joelguittet/chip-hardware/ALPHA-CHIP[v0_21]/README.md

# Source Files
C.H.I.P. is designed using OrCAD! A free "lite" viewer is available at <a href="http://www.orcad.com/">www.orcad.com</a>

# CHIP-Hardware
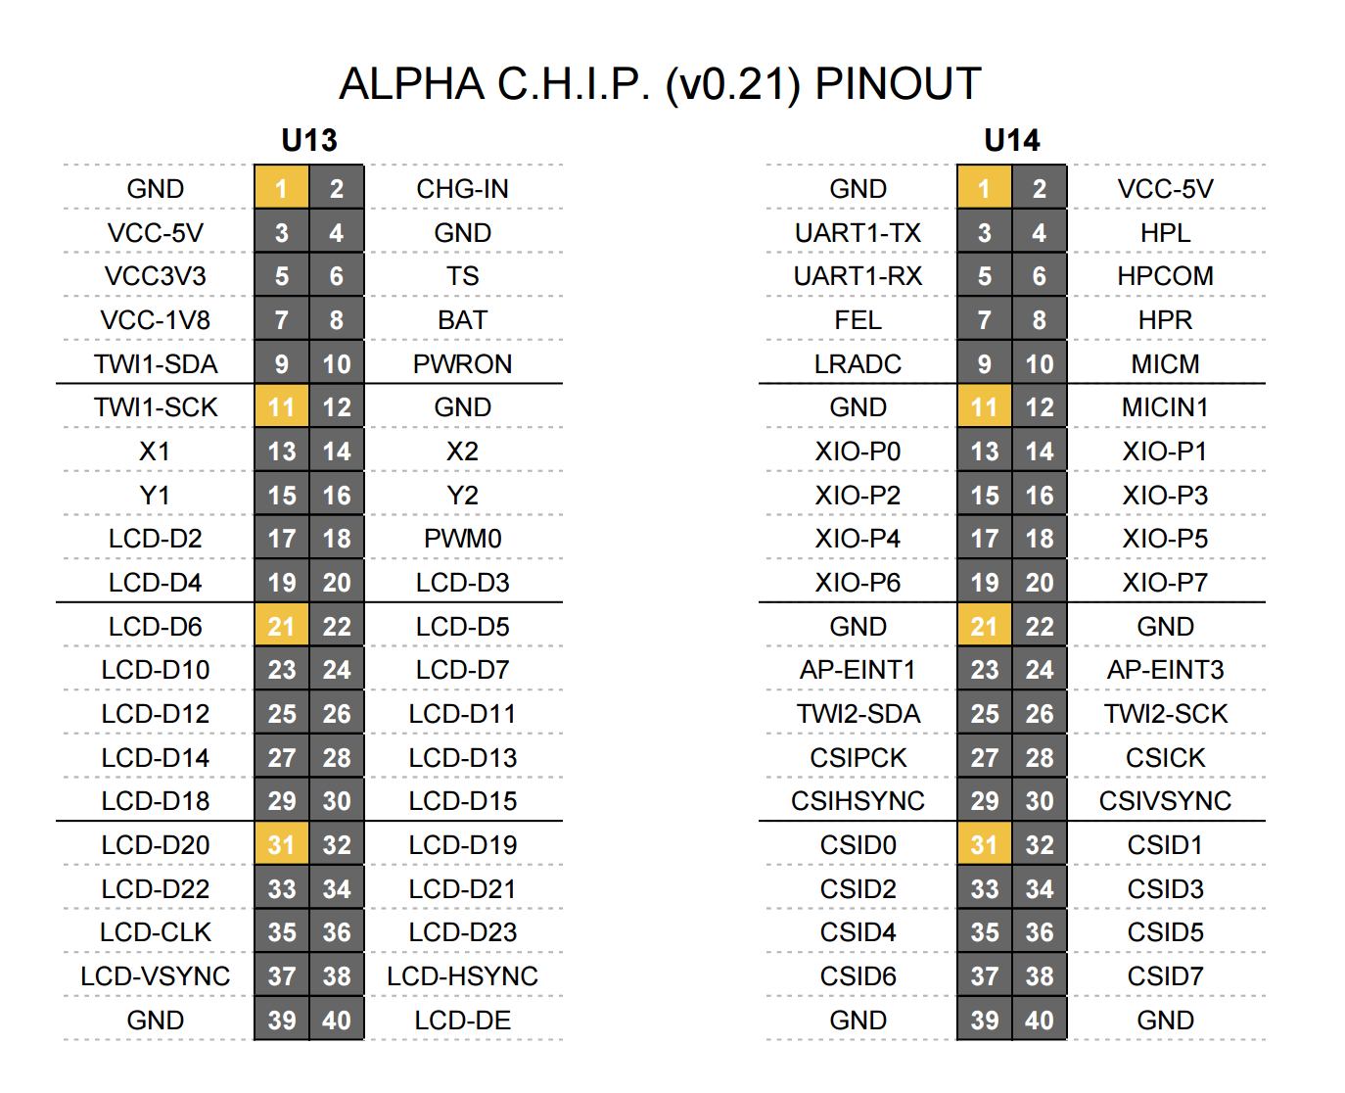
[picture p2: ALPHA-CHIP[v0_21]/ALPHA CHIP v0_21 PINOUT.png]
CHIP


#Composite Video and Audio Connector
A 3.5mm (1/8") "mini" TRRS to RCA composite video output cable.
Composite Cable

#License
<br />This work is licensed under a <a rel="license" href="http://creativecommons.org/licenses/by-sa/3.0/us/">Creative Commons Attribution-ShareAlike 3.0 United States License</a>.
