joelguittet/chip-hardware/CHIP[v1_0]/CHIP_v1_0_PINOUT.pdf

GND | 1 | 2 | CHG-IN | | GND | 1 | 2 | VCC-5V
VCC-5V | 3 | 4 | GND | | UART1-TX | 3 | 4 | HPL
VCC-3V3 | 5 | 6 | TS | | UART1-RX | 5 | 6 | HPCOM
VCC-1V8 | 7 | 8 | BAT | | FEL | 7 | 8 | HPR
TWI1-SDA | 9 | 10 | PWRON | was LRADC> | VCC-3V3 | 9 | 10 | MICM
TWI1-SCK | 11 | 12 | GND | was GND> | LRADC | 11 | 12 | MICIN1
X1 | 13 | 14 | X2 | | XIO-P0 | 13 | 14 | XIO-P1
Y1 | 15 | 16 | Y2 | | XIO-P2 | 15 | 16 | XIO-P3
LCD-D2 | 17 | 18 | PWM0 | | XIO-P4 | 17 | 18 | XIO-P5
LCD-D4 | 19 | 20 | LCD-D3 | | XIO-P6 | 19 | 20 | XIO-P7
LCD-D6 | 21 | 22 | LCD-D5 | | GND | 21 | 22 | GND
LCD-D10 | 23 | 24 | LCD-D7 | | AP-EINT1 | 23 | 24 | AP-EINT3
LCD-D12 | 25 | 26 | LCD-D11 | | TWI2-SDA | 25 | 26 | TWI2-SCK
LCD-D14 | 27 | 28 | LCD-D13 | | CSIPCK | 27 | 28 | CSICK
LCD-D18 | 29 | 30 | LCD-D15 | | CSIHSYNC | 29 | 30 | CSIVSYNC
LCD-D20 | 31 | 32 | LCD-D19 | | CSID0 | 31 | 32 | CSID1
LCD-D22 | 33 | 34 | LCD-D21 | | CSID2 | 33 | 34 | CSID3
LCD-CLK | 35 | 36 | LCD-D23 | | CSID4 | 35 | 36 | CSID5
LCD-VSYNC | 37 | 38 | LCD-HSYNC | | CSID6 | 37 | 38 | CSID7
GND | 39 | 40 | LCD-DE | | GND | 39 | 40 | GND

Use square pad

## C.H.I.P. (v1.0) PINOUT

U13 | U14

New Pin Location vs. v0.21
