joelguittet/chip-hardware/ALPHA-CHIP[v0_21]/CompositeCable-TRStoRCA-PINOUT.png

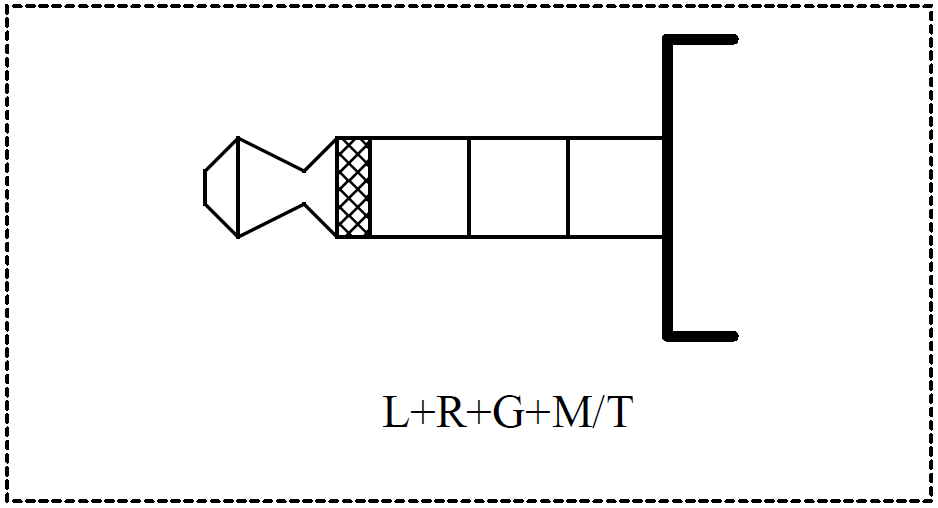
ALPHA-CHIP[v0_21]/CompositeCable-TRStoRCA-PINOUT.png
