joelguittet/chip-hardware/CHIP-PRO/CHIP_PRO-Schematics.pdf

# Schematics Index£º

# P01: REVISION HISTORY

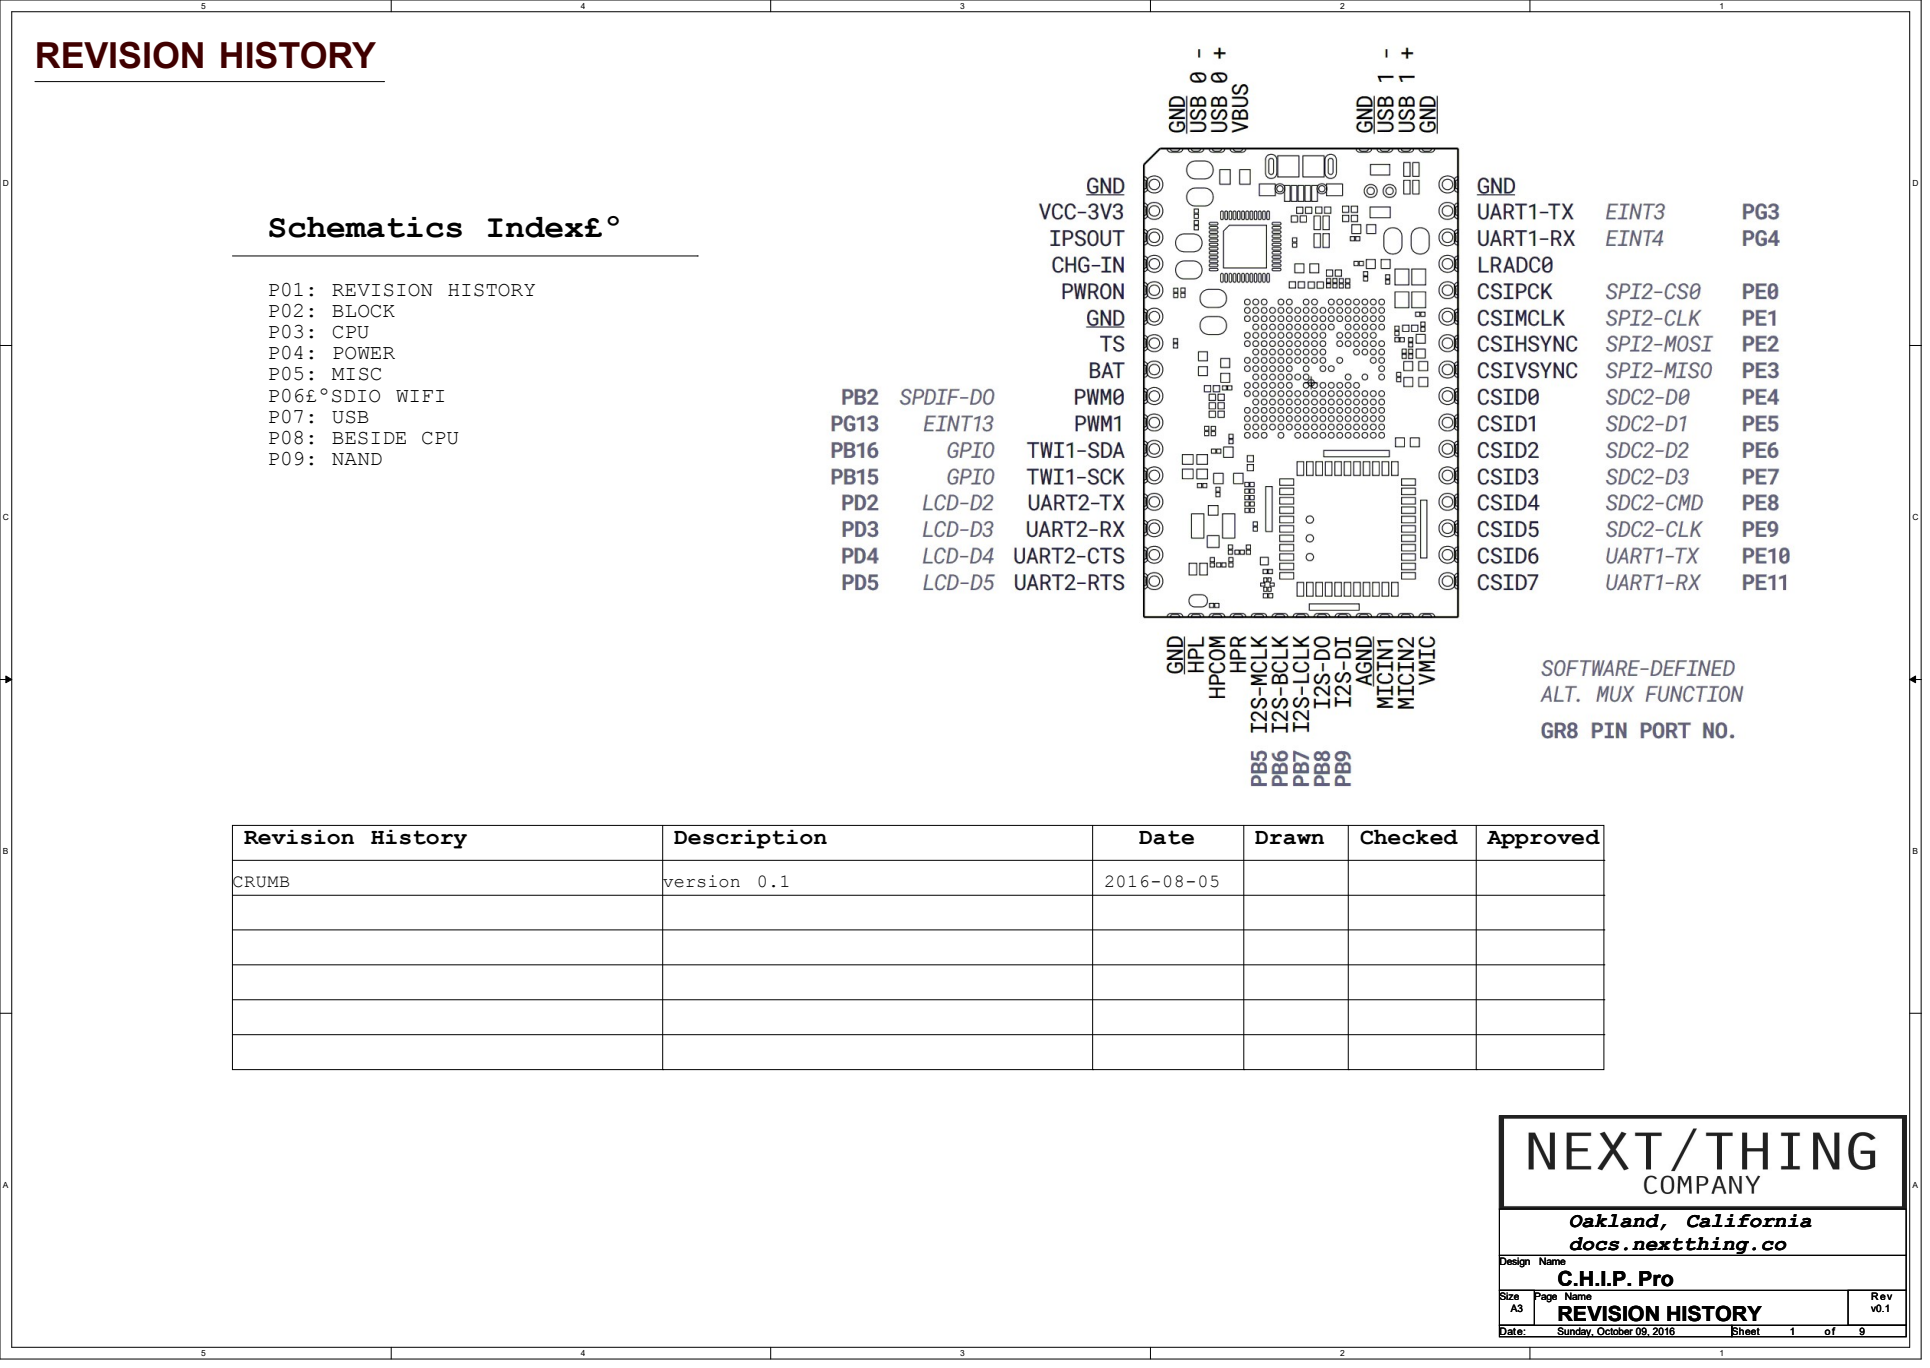
[picture p9: page 1]
Revision History; Description; Date; Drawn; Checked; Approved; P02: BLOCK P03: CPU P04: POWER P05: MISC P06£ºSDIO WIFI P07: USB P08: BESIDE CPU P09: NAND; REVISION HISTORY; CRUMB; version 0.1; Design Name; Size; Page Name; Rev; Date:; Sheet; v0.1 C.H.I.P. Pro A3; Sunday, October 09, 2016

Oakland, California
docs.nextthing.co

# BATT

# DCIN

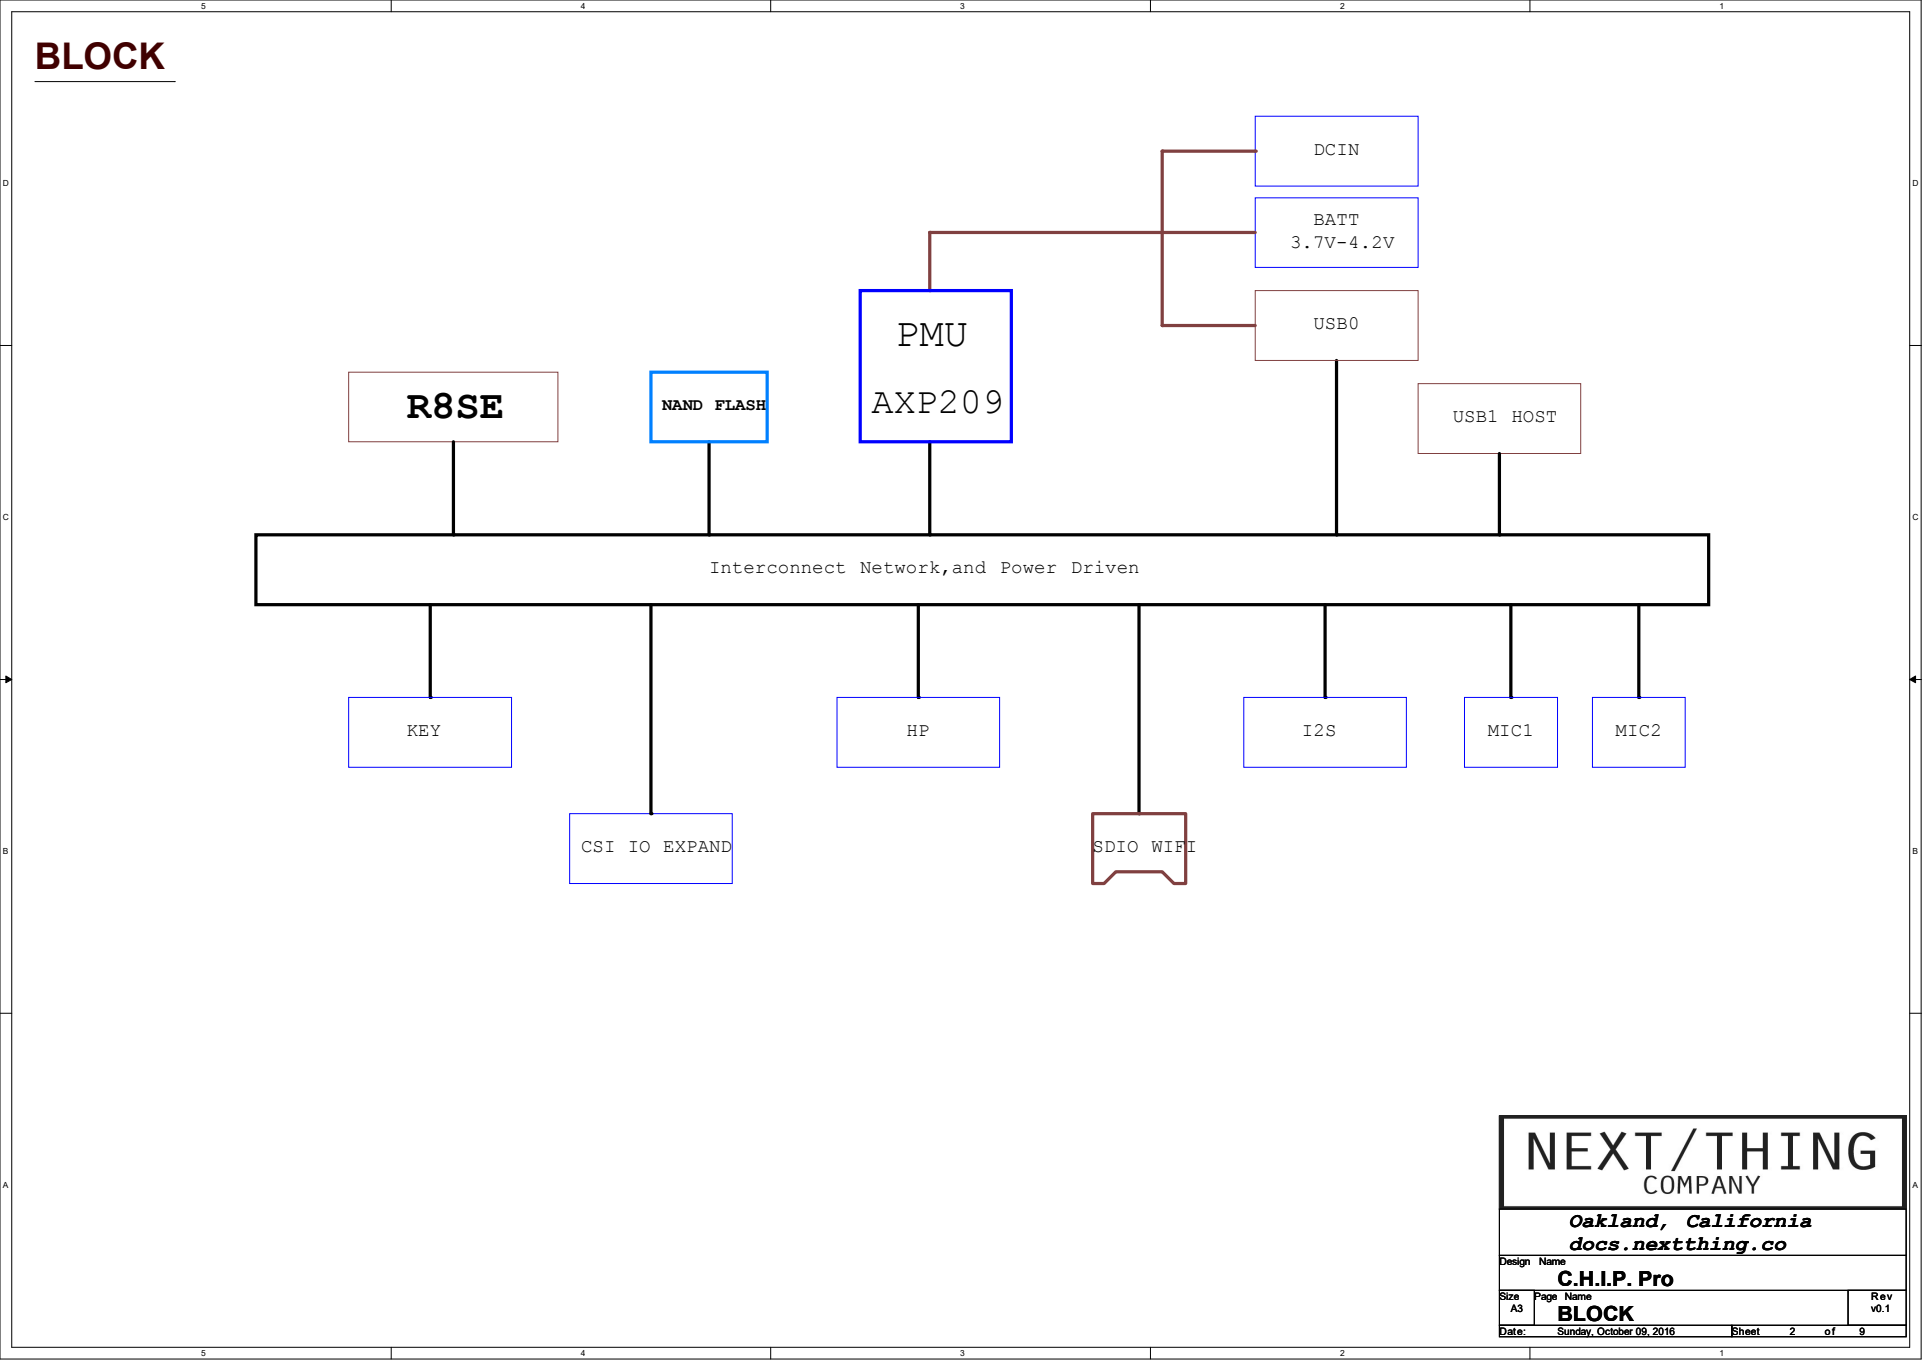
[picture p10: page 2]
SDIO WIFI; USB0; KEY; PMU; AXP209; MIC1; BLOCK; NAND FLASH R8SE; USB1 HOST; MIC2; Design Name; Size; Page Name; Rev; Date:; Sheet; v0.1 C.H.I.P. Pro A3; Sunday, October 09, 2016

Interconnect Network,and Power Driven

CSI IO EXPAND

Oakland, California
docs.nextthing.co

CPU | NAND

# SYS

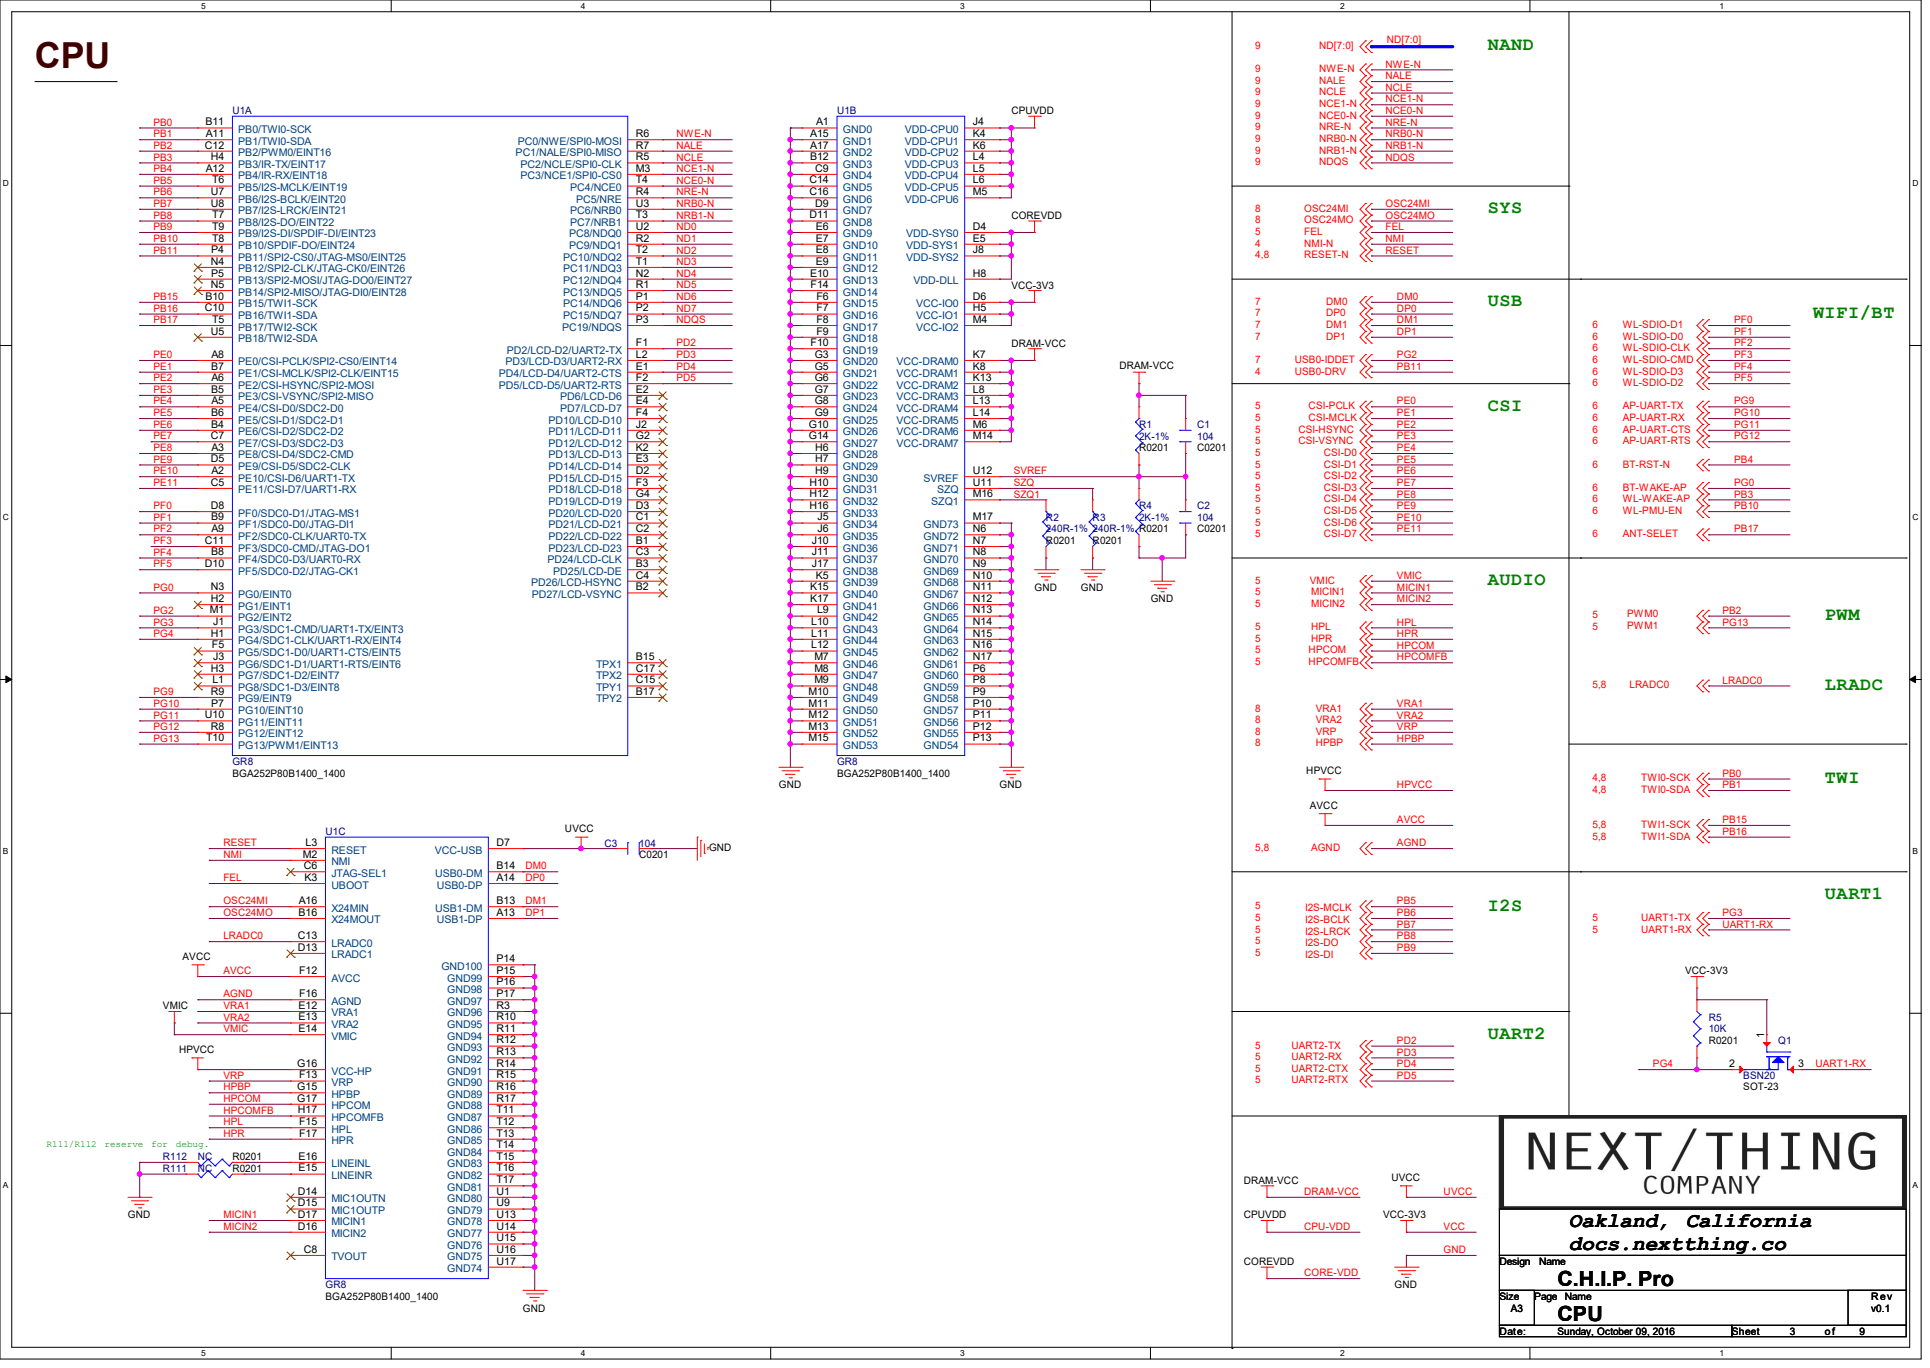
[picture p11: page 3]

VDD-CPU0 J4 VDD-CPU1 K4 VDD-CPU2 K6 VDD-CPU3 L4 VDD-CPU4 L5 VDD-CPU5 L6 VDD-CPU6 M5 VDD-DLL H8 VDD-SYS0 D4 VDD-SYS1 E5 VDD-SYS2 J8 VCC-DRAM0 K7 VCC-DRAM1 K8 VCC-DRAM2 K13 VCC-DRAM3 L8 VCC-DRAM4 L13 VCC-DRAM5 L14 VCC-DRAM6 M6 VCC-IO0 D6 VCC-IO1 H5 VCC-IO2 M4 GND25 G9 GND26 G10 GND27 G14 GND28 H6 GND29 H7 GND30 H9 GND31 H10 GND32 H12 GND33 H16
PC1/NALE/SPI0-MISO R7 PC0/NWE/SPI0-MOSI R6 PC3/NCE1/SPI0-CS0 M3 PC2/NCLE/SPI0-CLK R5 PC5/NRE R4 PC6/NRB0 U3 PC8/NDQ0 U2 PC10/NDQ2 T2 PC11/NDQ3 T1 PC13/NDQ5 R1 PC12/NDQ4 N2 PC19/NDQS P3 PC14/NDQ6 P1 PC9/NDQ1 R2 PC7/NRB1 T3 PC4/NCE0 T4 PC15/NDQ7 P2 TPX1 B15 TPX2 C17 TPY1 C15 TPY2 B17

PD2/LCD-D2/UART2-TX F1 PD3/LCD-D3/UART2-RX L2 PD4/LCD-D4/UART2-CTS E1 PD5/LCD-D5/UART2-RTS F2 PD6/LCD-D6 E2 PD7/LCD-D7 E4 PD10/LCD-D10 F4 PD11/LCD-D11 J2 PD12/LCD-D12 G2 PD13/LCD-D13 K2 PD14/LCD-D14 E3 PD15/LCD-D15 D2 PD18/LCD-D18 F3 PD19/LCD-D19 G4 PD20/LCD-D20 D3 PD21/LCD-D21 C1 PD22/LCD-D22 C2 PD23/LCD-D23 B1 PD24/LCD-CLK C3 PD25/LCD-DE B3 PD26/LCD-HSYNC C4 PD27/LCD-VSYNC B2

HPBP HPL NMI RESET OSC24MI OSC24MO

2 3 U1C GR8 BGA252P80B1400_1400
VCC-USB D7 USB0-DM B14 USB0-DP A14 USB1-DM B13 USB1-DP A13 HPBP G15

# POWER/PMU

# VCC-1V8 AVCC

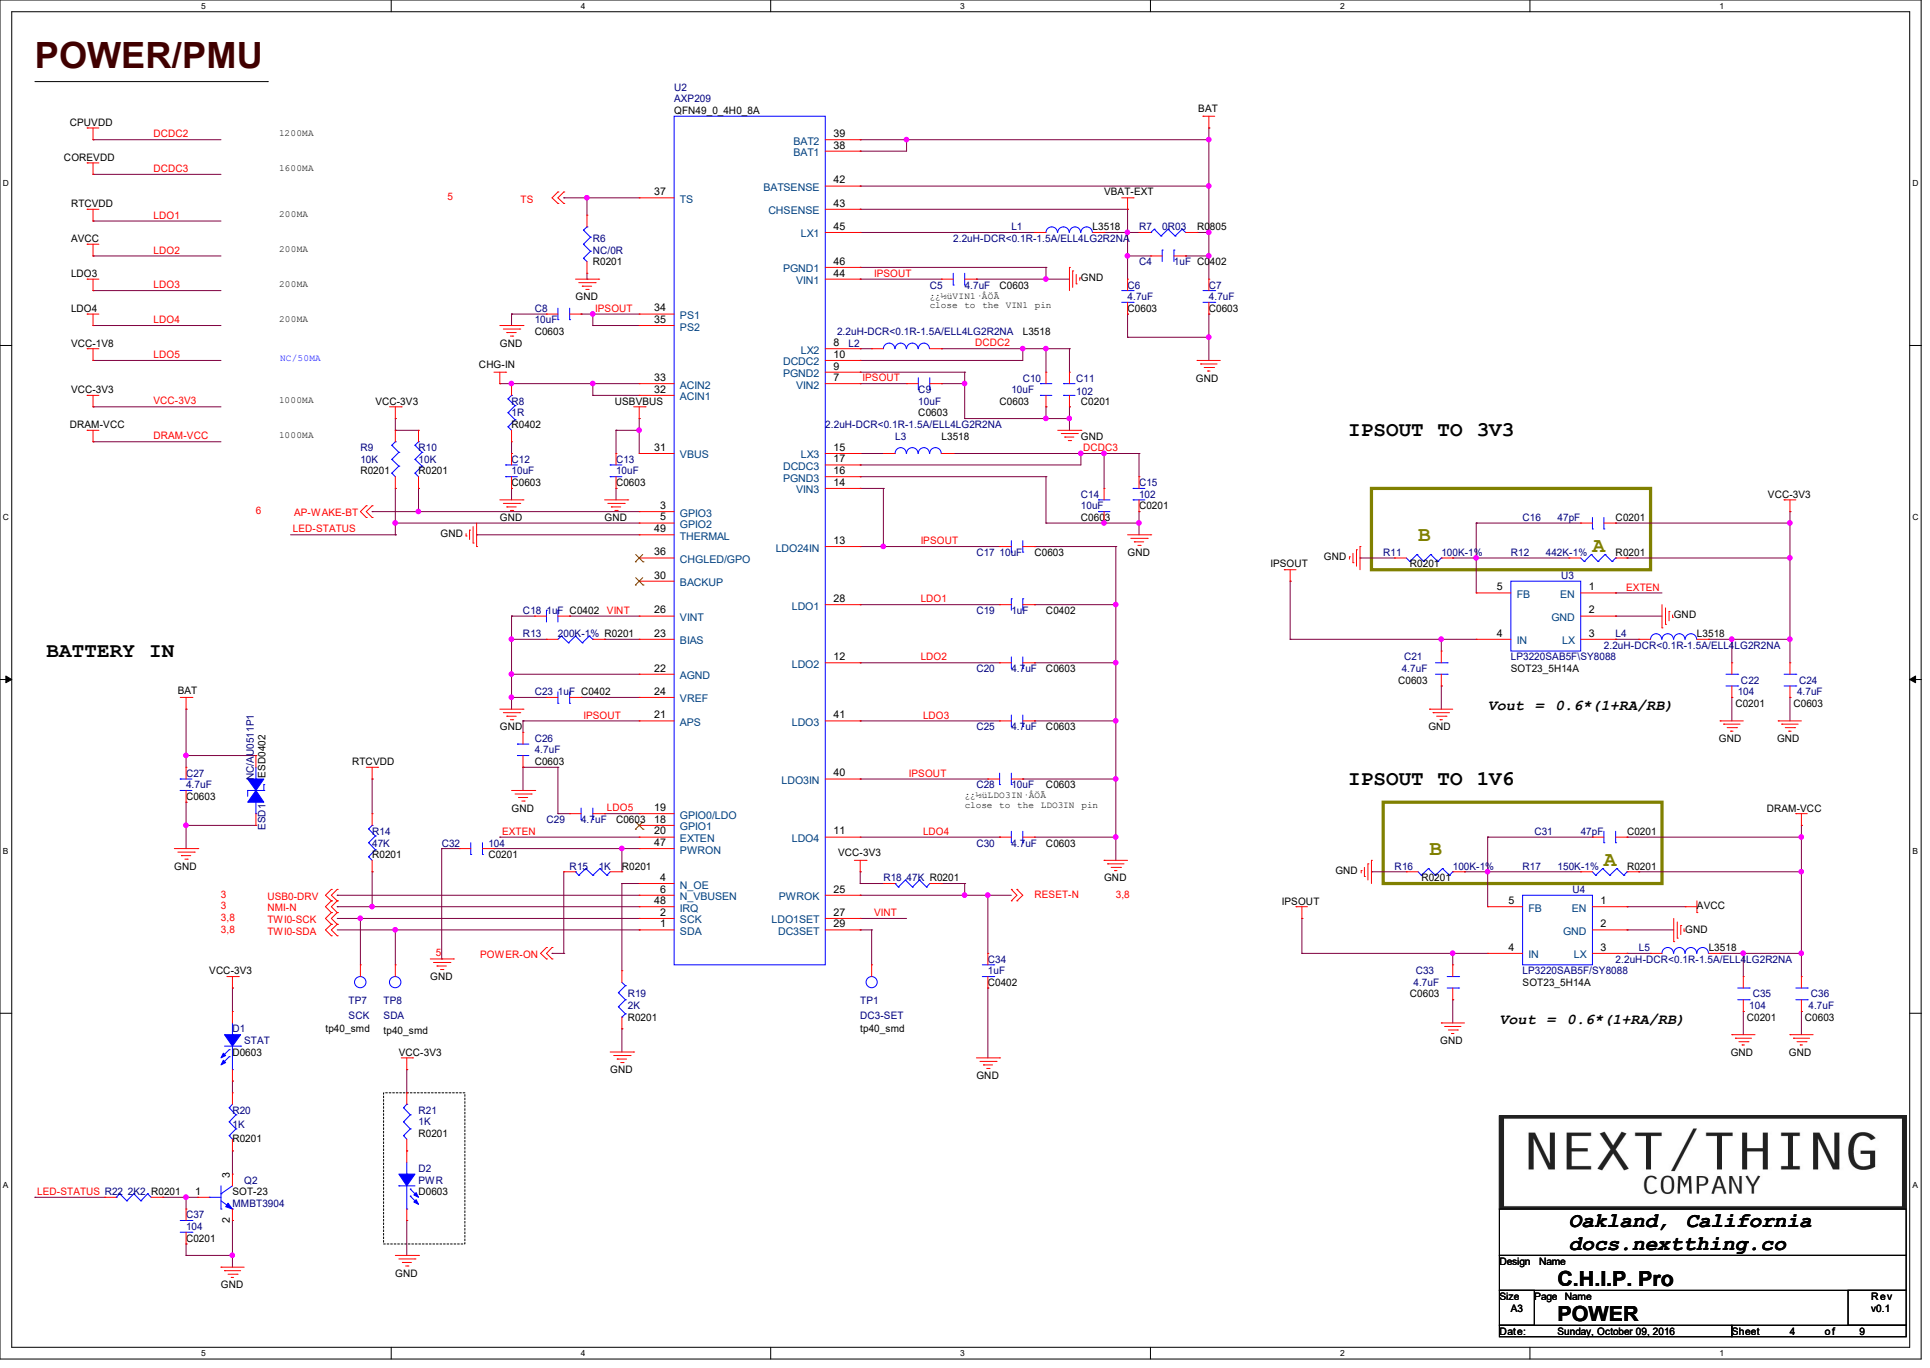
[picture p12: page 4]

BATSENSE 42 CHSENSE 43 VIN1 44
BACKUP 30 VBUS 31 ACIN1 32 ACIN2 33 PS1 34 PS2 35 CHGLED/GPO 36

¿¿½üVIN1·ÅÖÃ
close to the VIN1 pin

¿¿½üLDO3IN·ÅÖÃ
close to the LDO3IN pin

# MISC

# PWM0 TSUART2-RTX UART2-TX

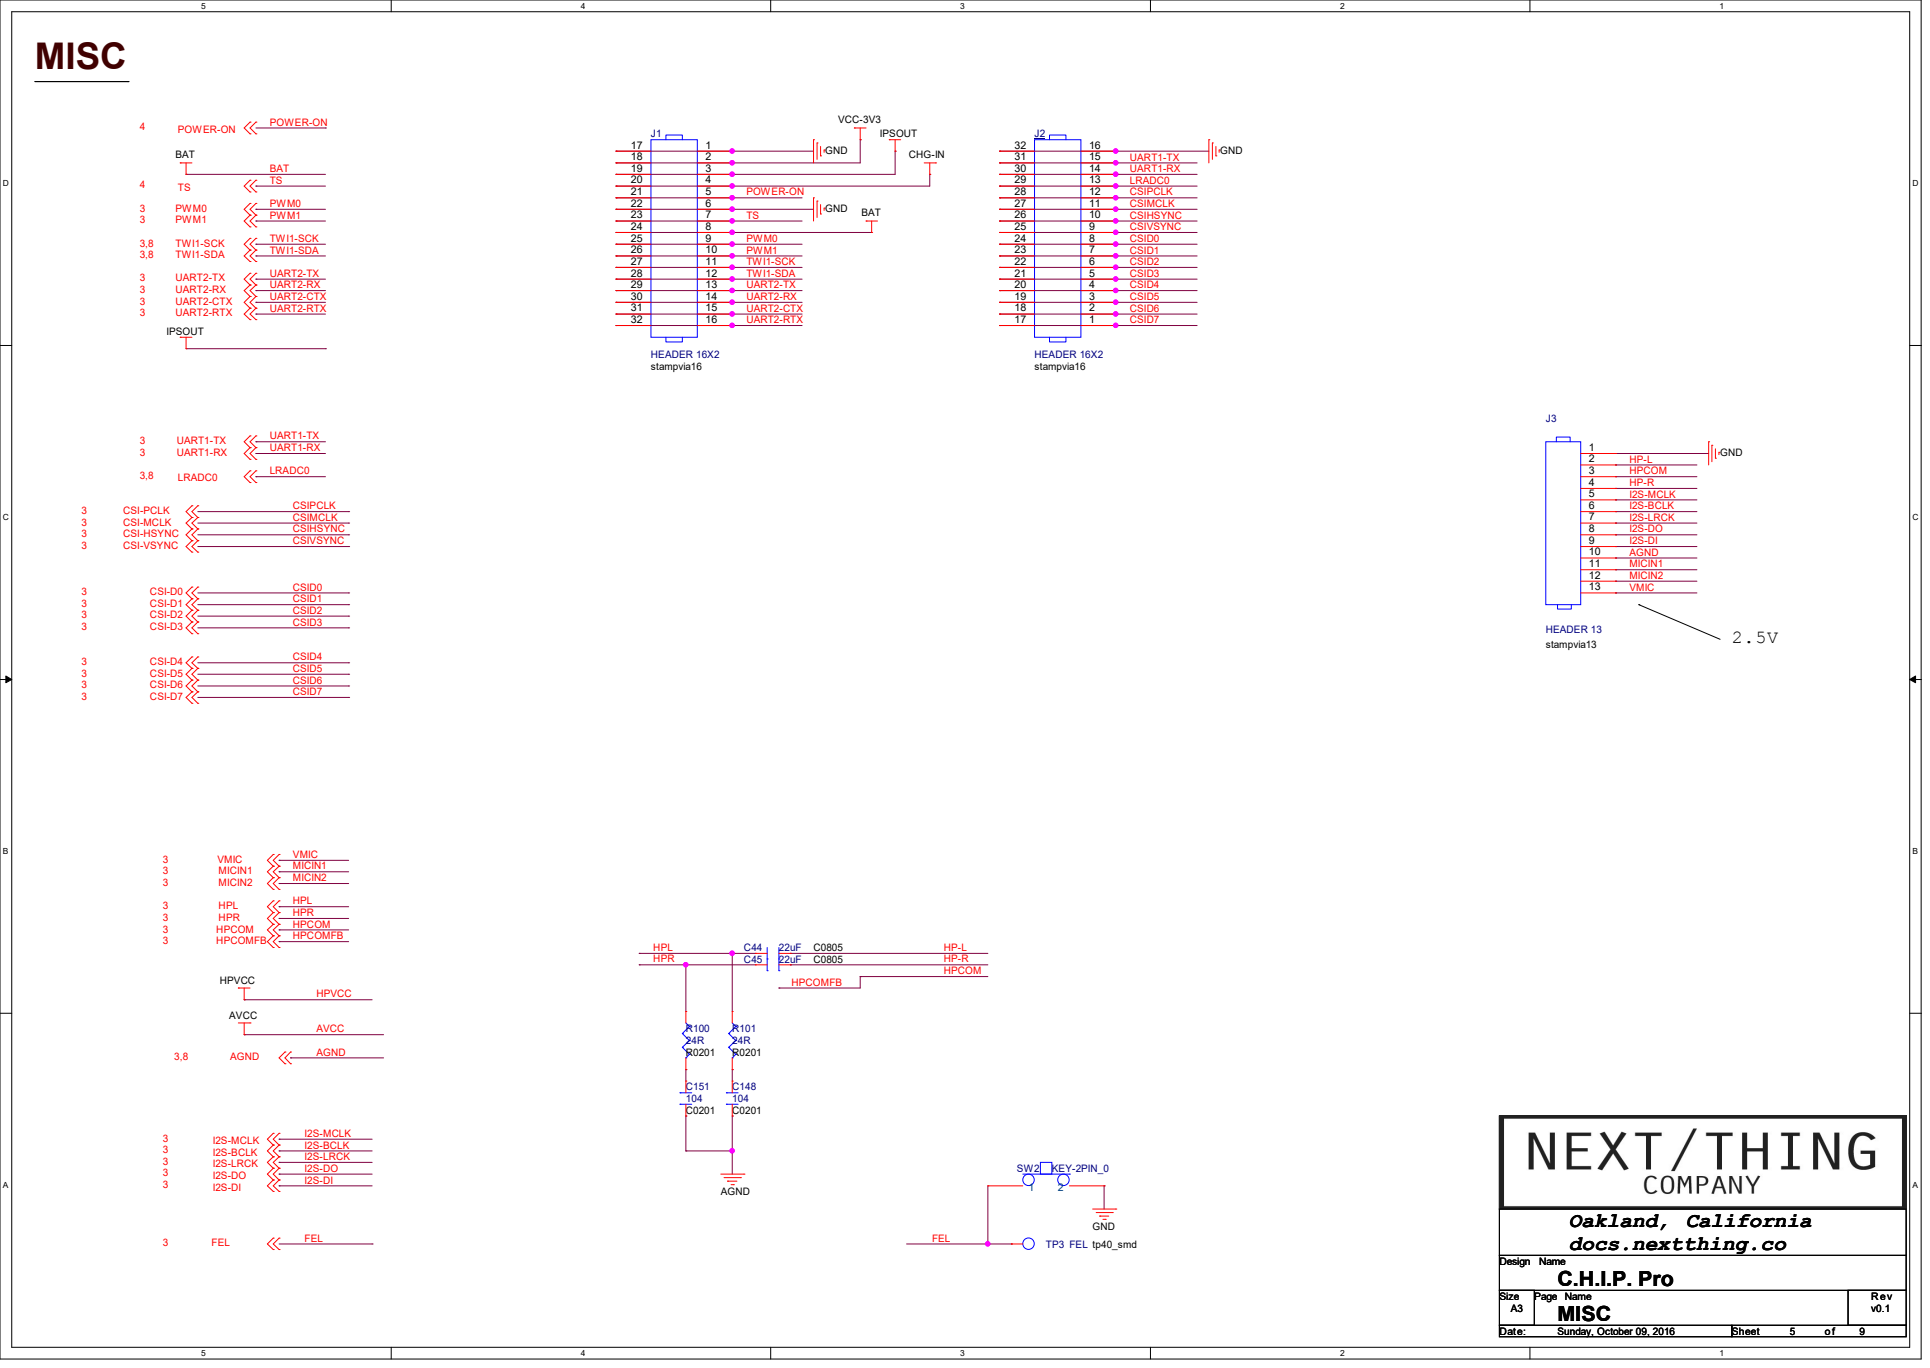
[picture p13: page 5]

IPSOUT GND BAT GND

TWI1-SCK
TWI1-SDA UART2-RTX UART2-CTX UART2-RX UART2-TX

A

B

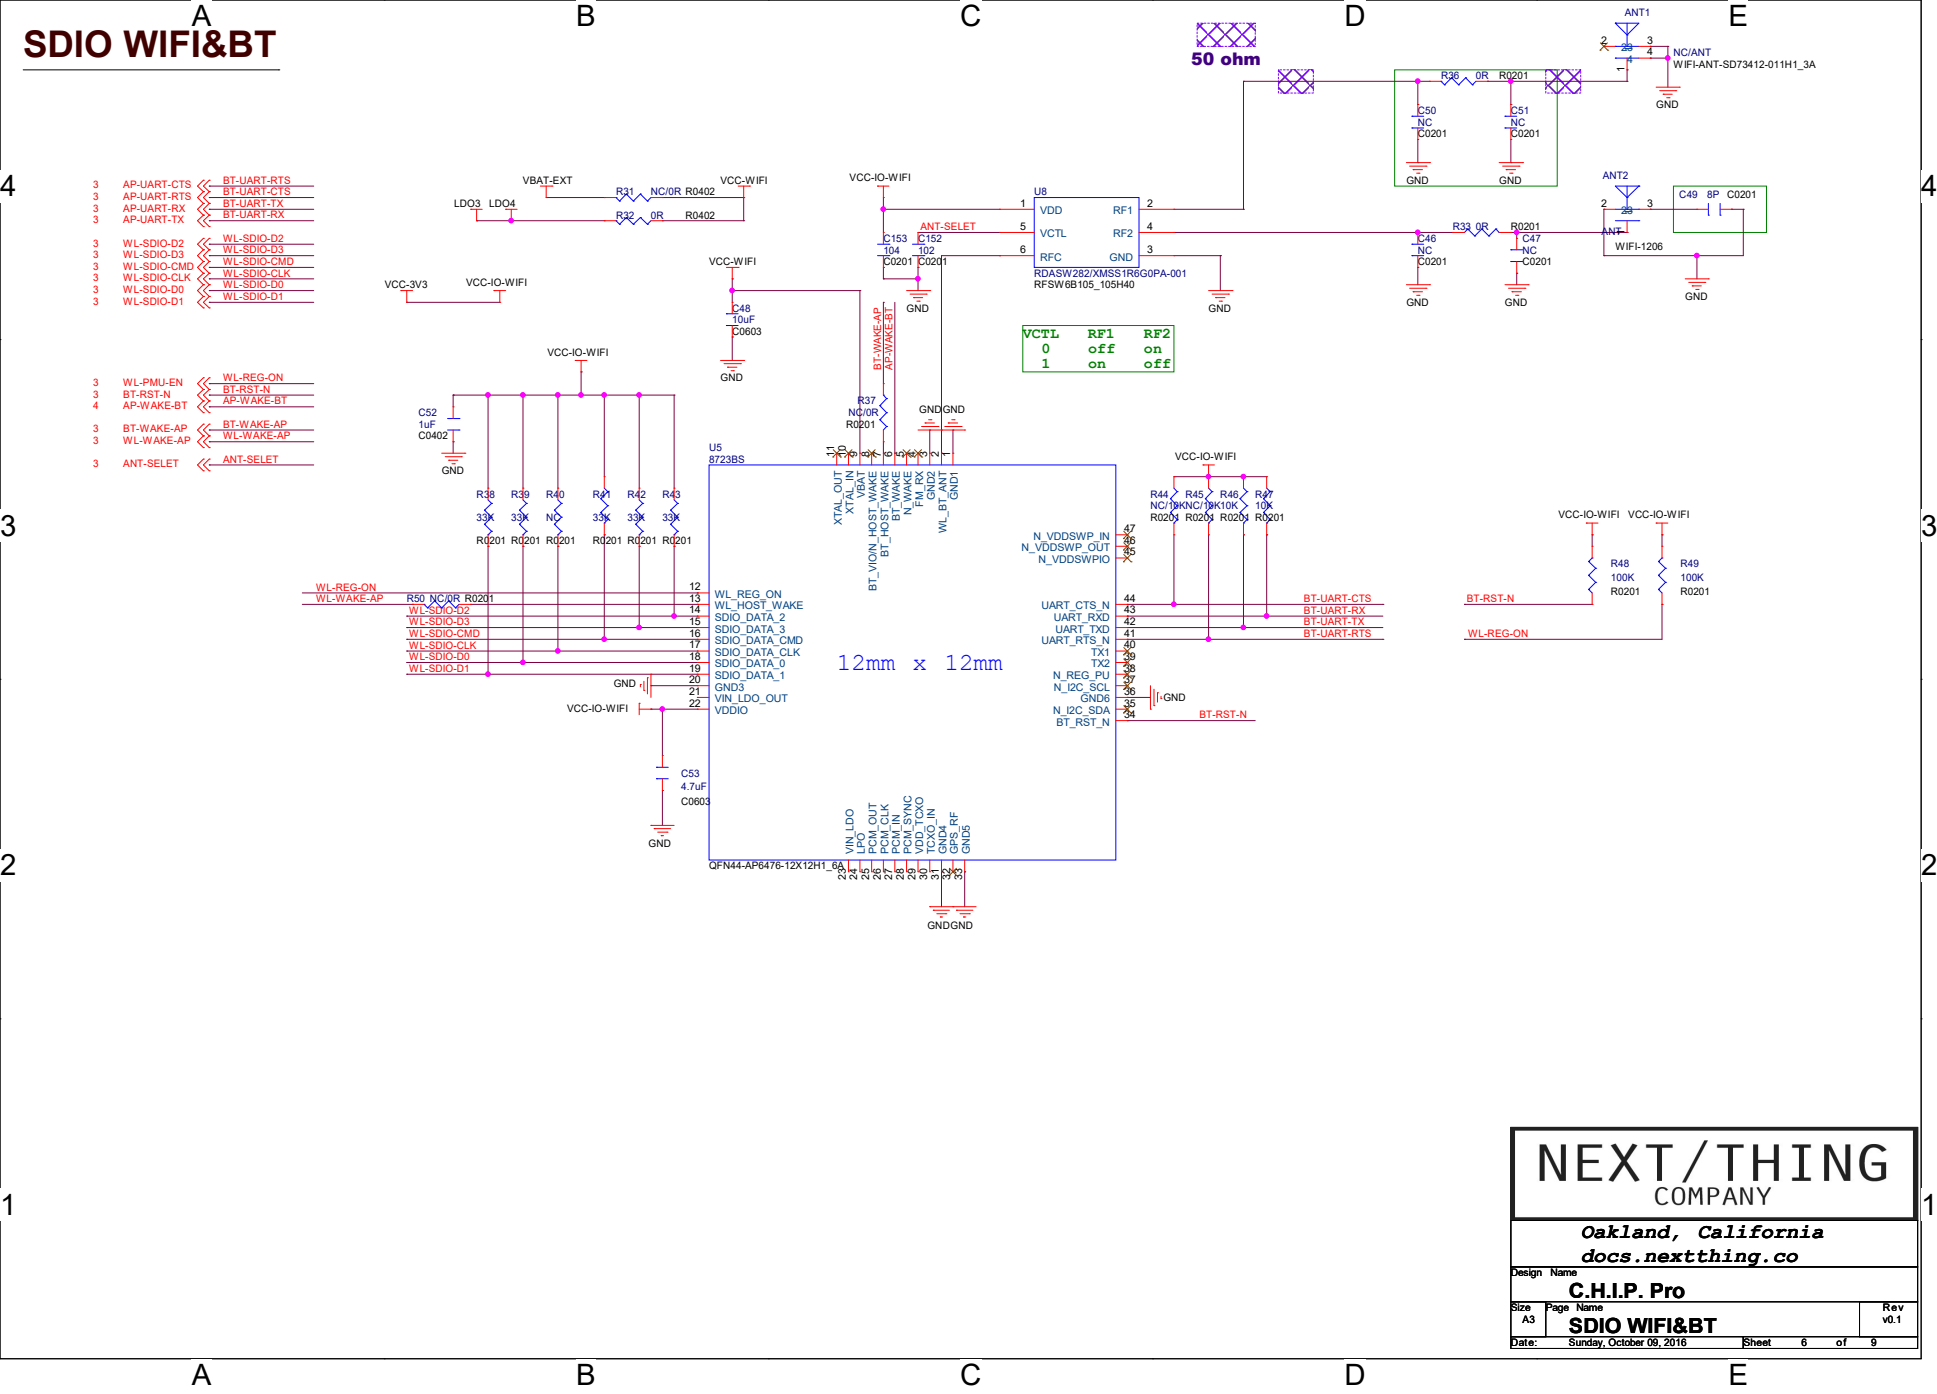
[picture p14: page 6]

BT-UART-RTS
BT-UART-CTS
BT-UART-TX
AP-WAKE-BT BT-RST-N WL-SDIO-D2 WL-SDIO-D3 WL-SDIO-CMD WL-SDIO-CLK WL-SDIO-D0 WL-SDIO-D1 BT-UART-RX

BT-RST-N WL-REG-ON WL-REG-ON

BT-RST-N WL-SDIO-CLK

# USB

# J5HEADER 4

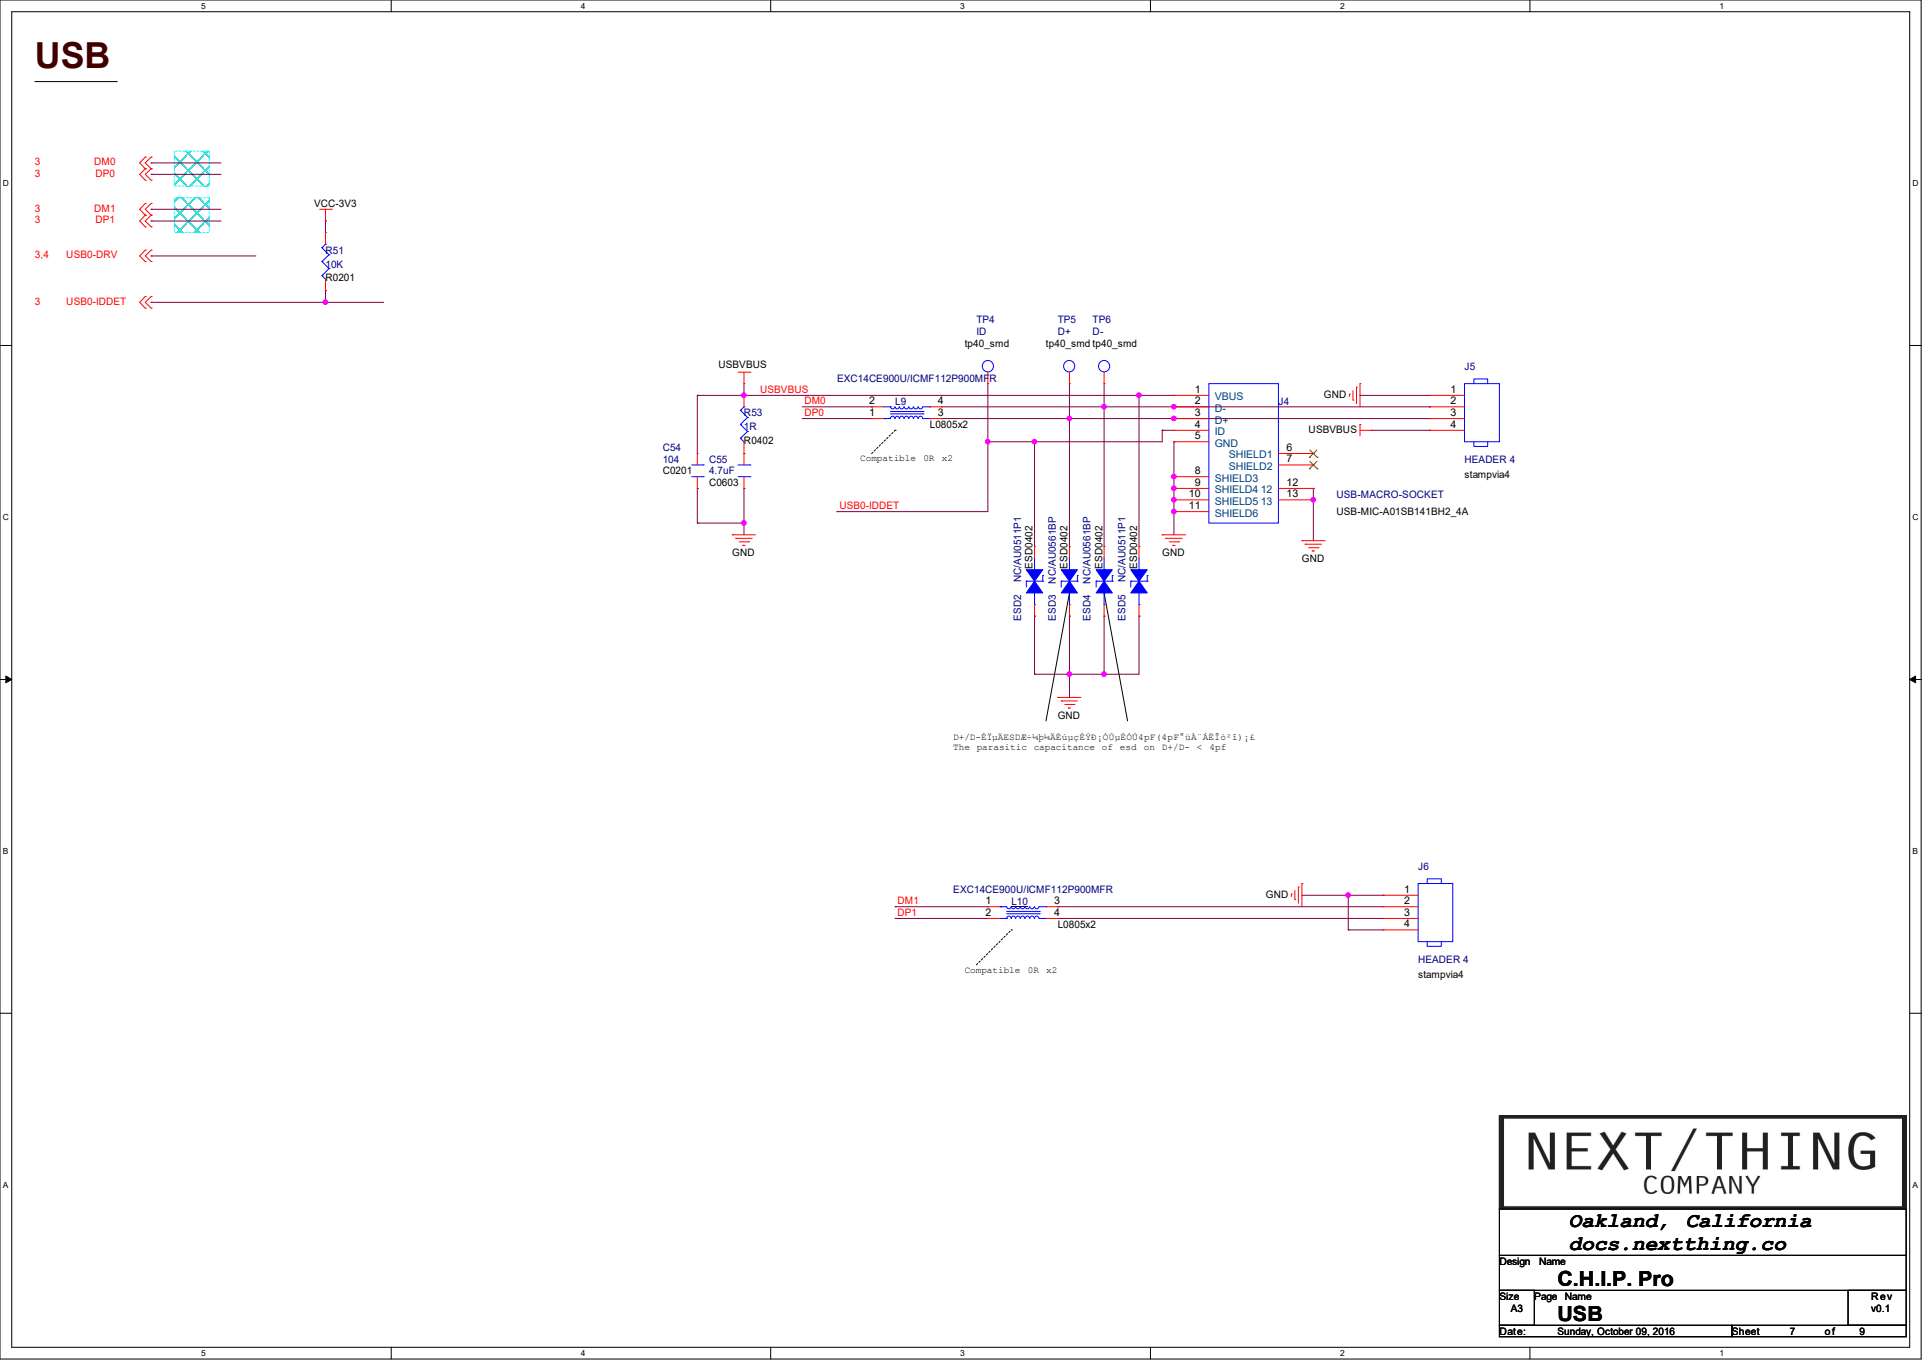
[picture p15: page 7]

4 ESD⁴ NC/AU⁰⁵⁶¹BP ESD⁰⁴⁰² TP5 D+

4 ESD³ NC/AU⁰⁵⁶¹BP ESD⁰⁴⁰²

D+/D-ÉÏµÄESDÆ÷¼þ¼ÄÉúµçÈÝÐ¡ÓÚµÈÓÚ4pF(4pF°üÀ¨ÁËÎó²î)¡£
The parasitic capacitance of esd on D+/D- < 4pf

# DRAM

# PIO-INTFACE

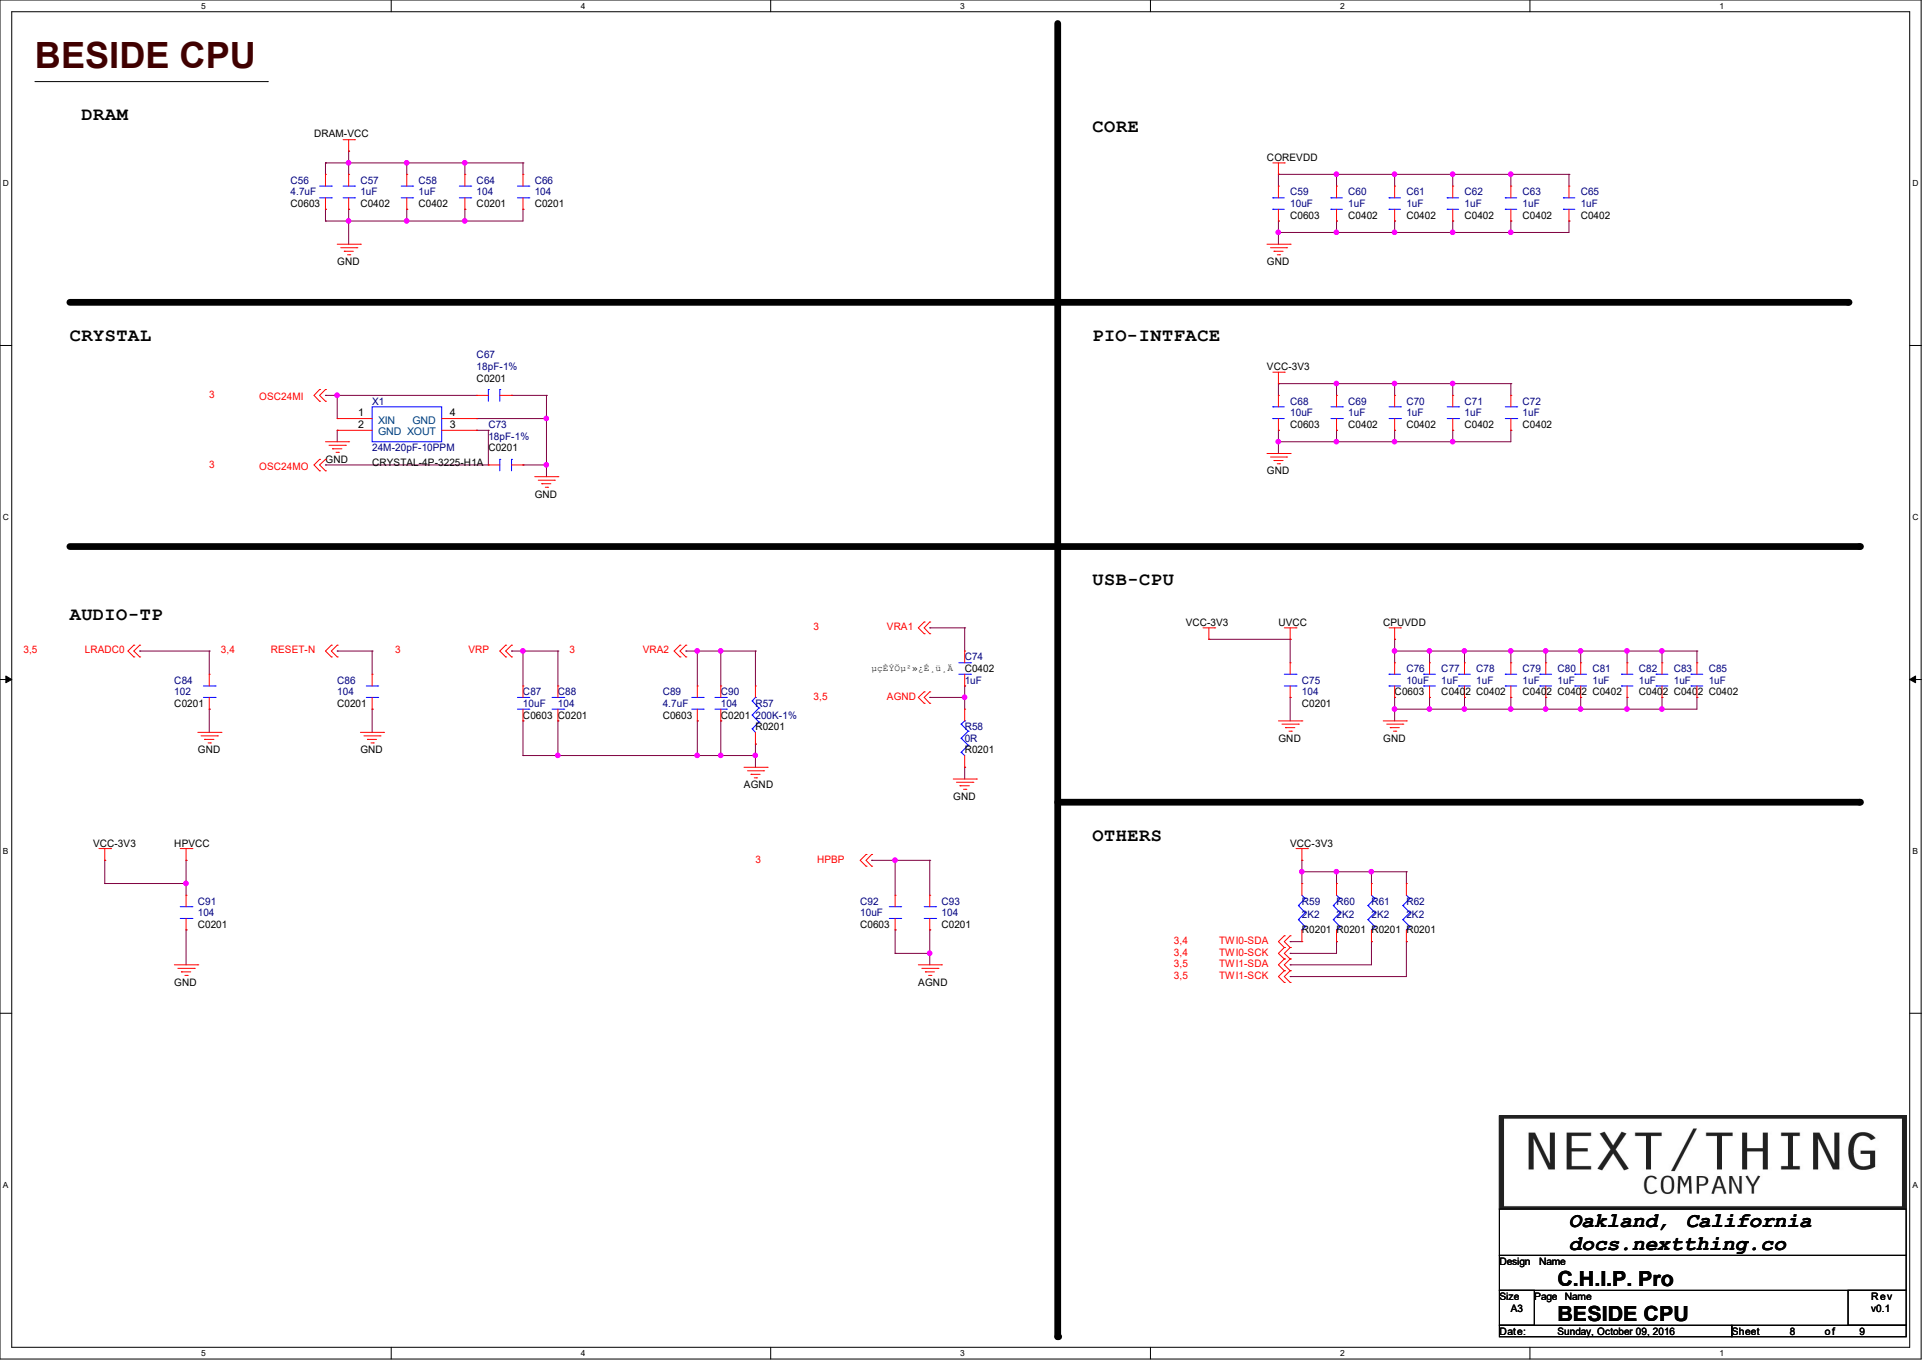
[picture p16: page 8]

# NAND

# NALE NRB1-N

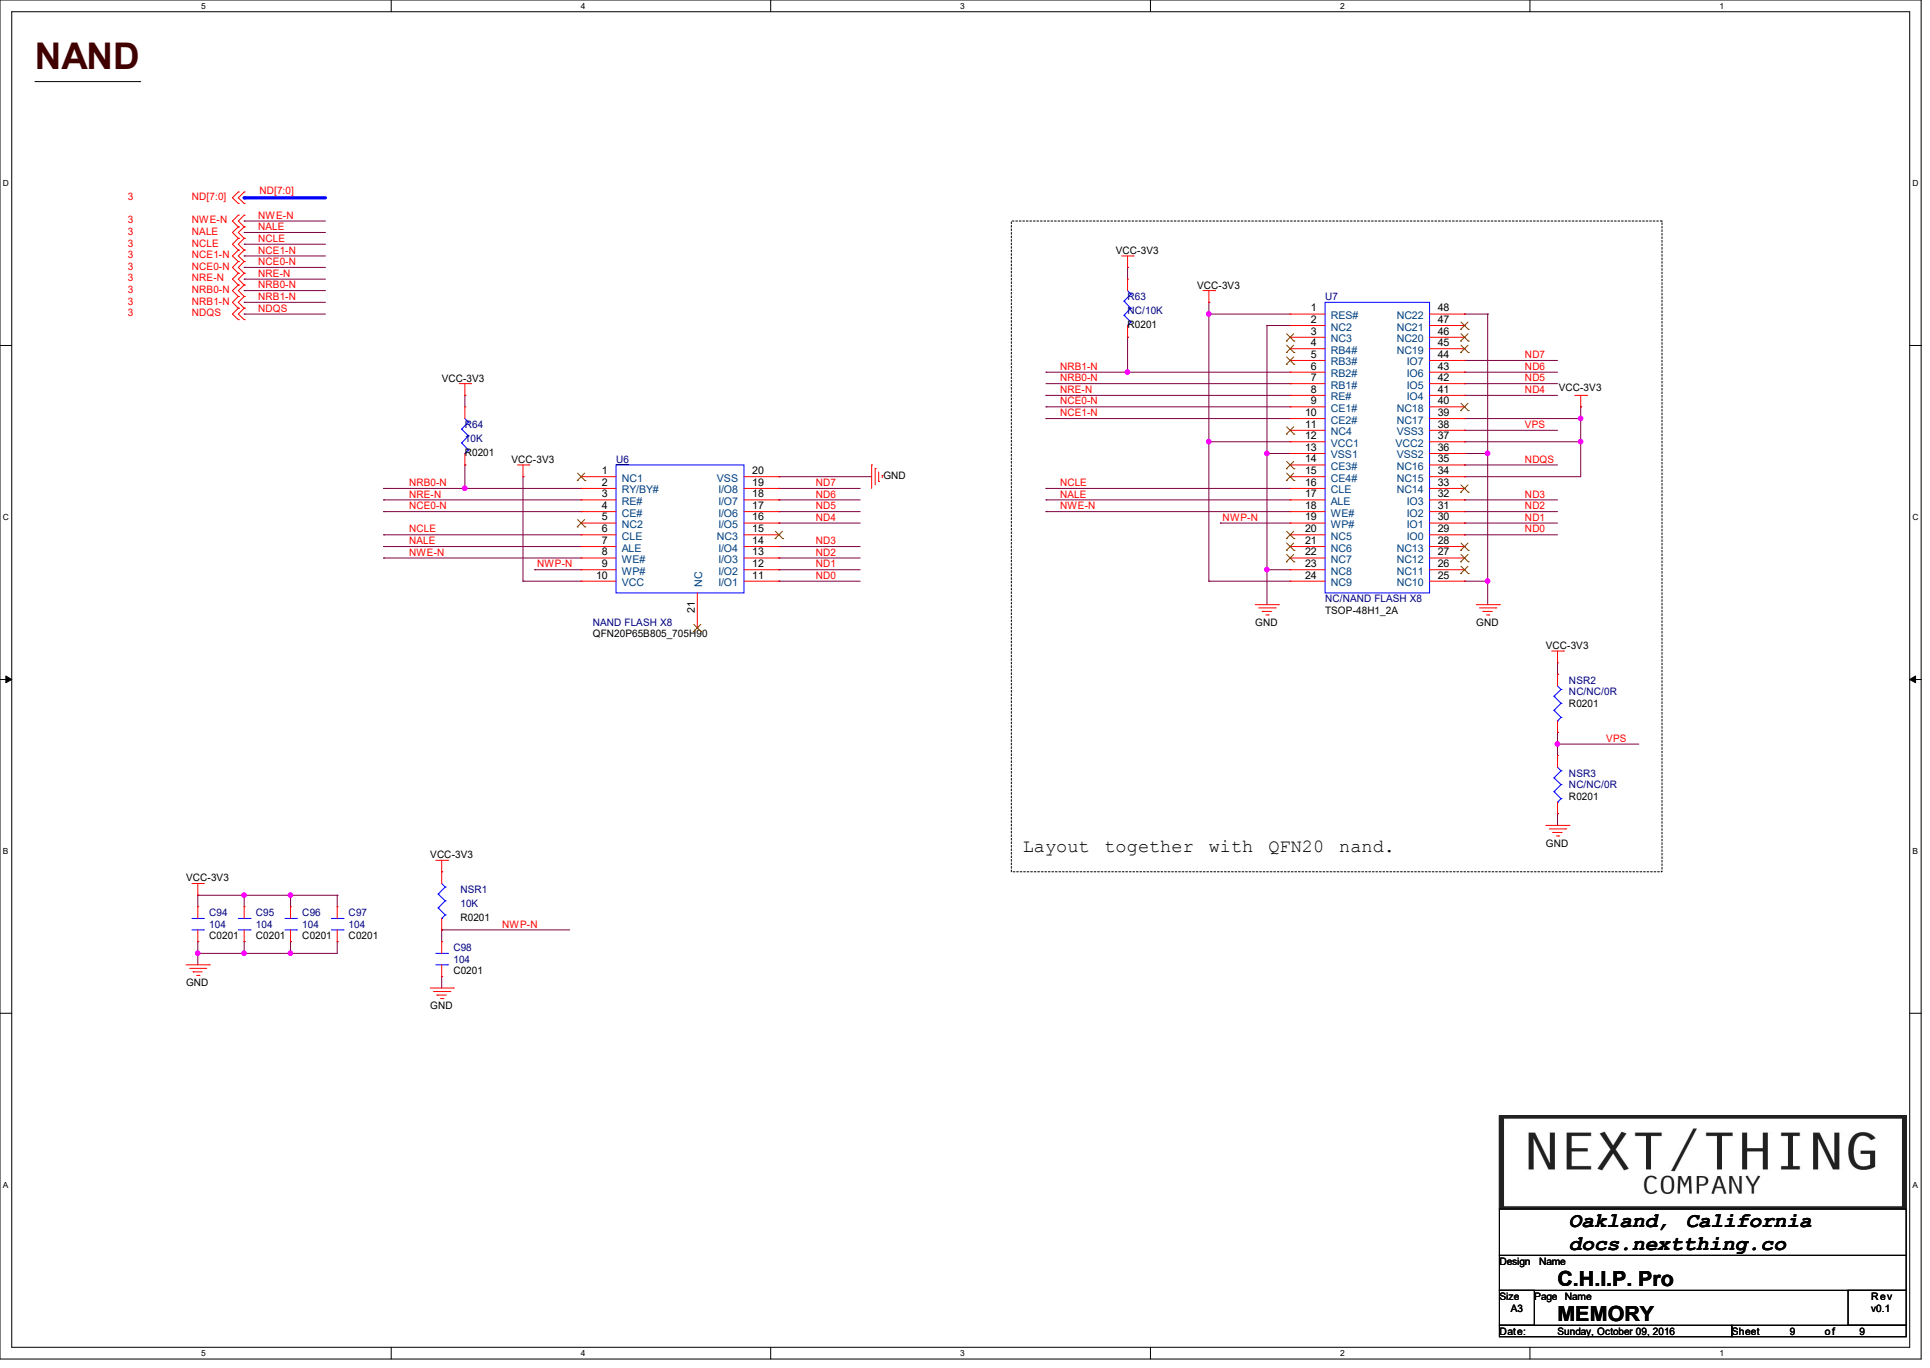
[picture p17: page 9]

R0201 NAND FLASH X8 U6 QFN20P65B805_705H90 CLE 6 ALE 7 RE# 3 VCC 10 CE# 4 NC2 5 WE# 8 WP# 9 NC1 1 RY/BY# 2

Layout together with QFN20 nand. NWP-N
