joelguittet/chip-hardware/CHIP[v1_0]/CHIP_v1_0_SCHEMATIC_20151203.pdf

# Schematics Index：

# P01: REVISION HISTORY

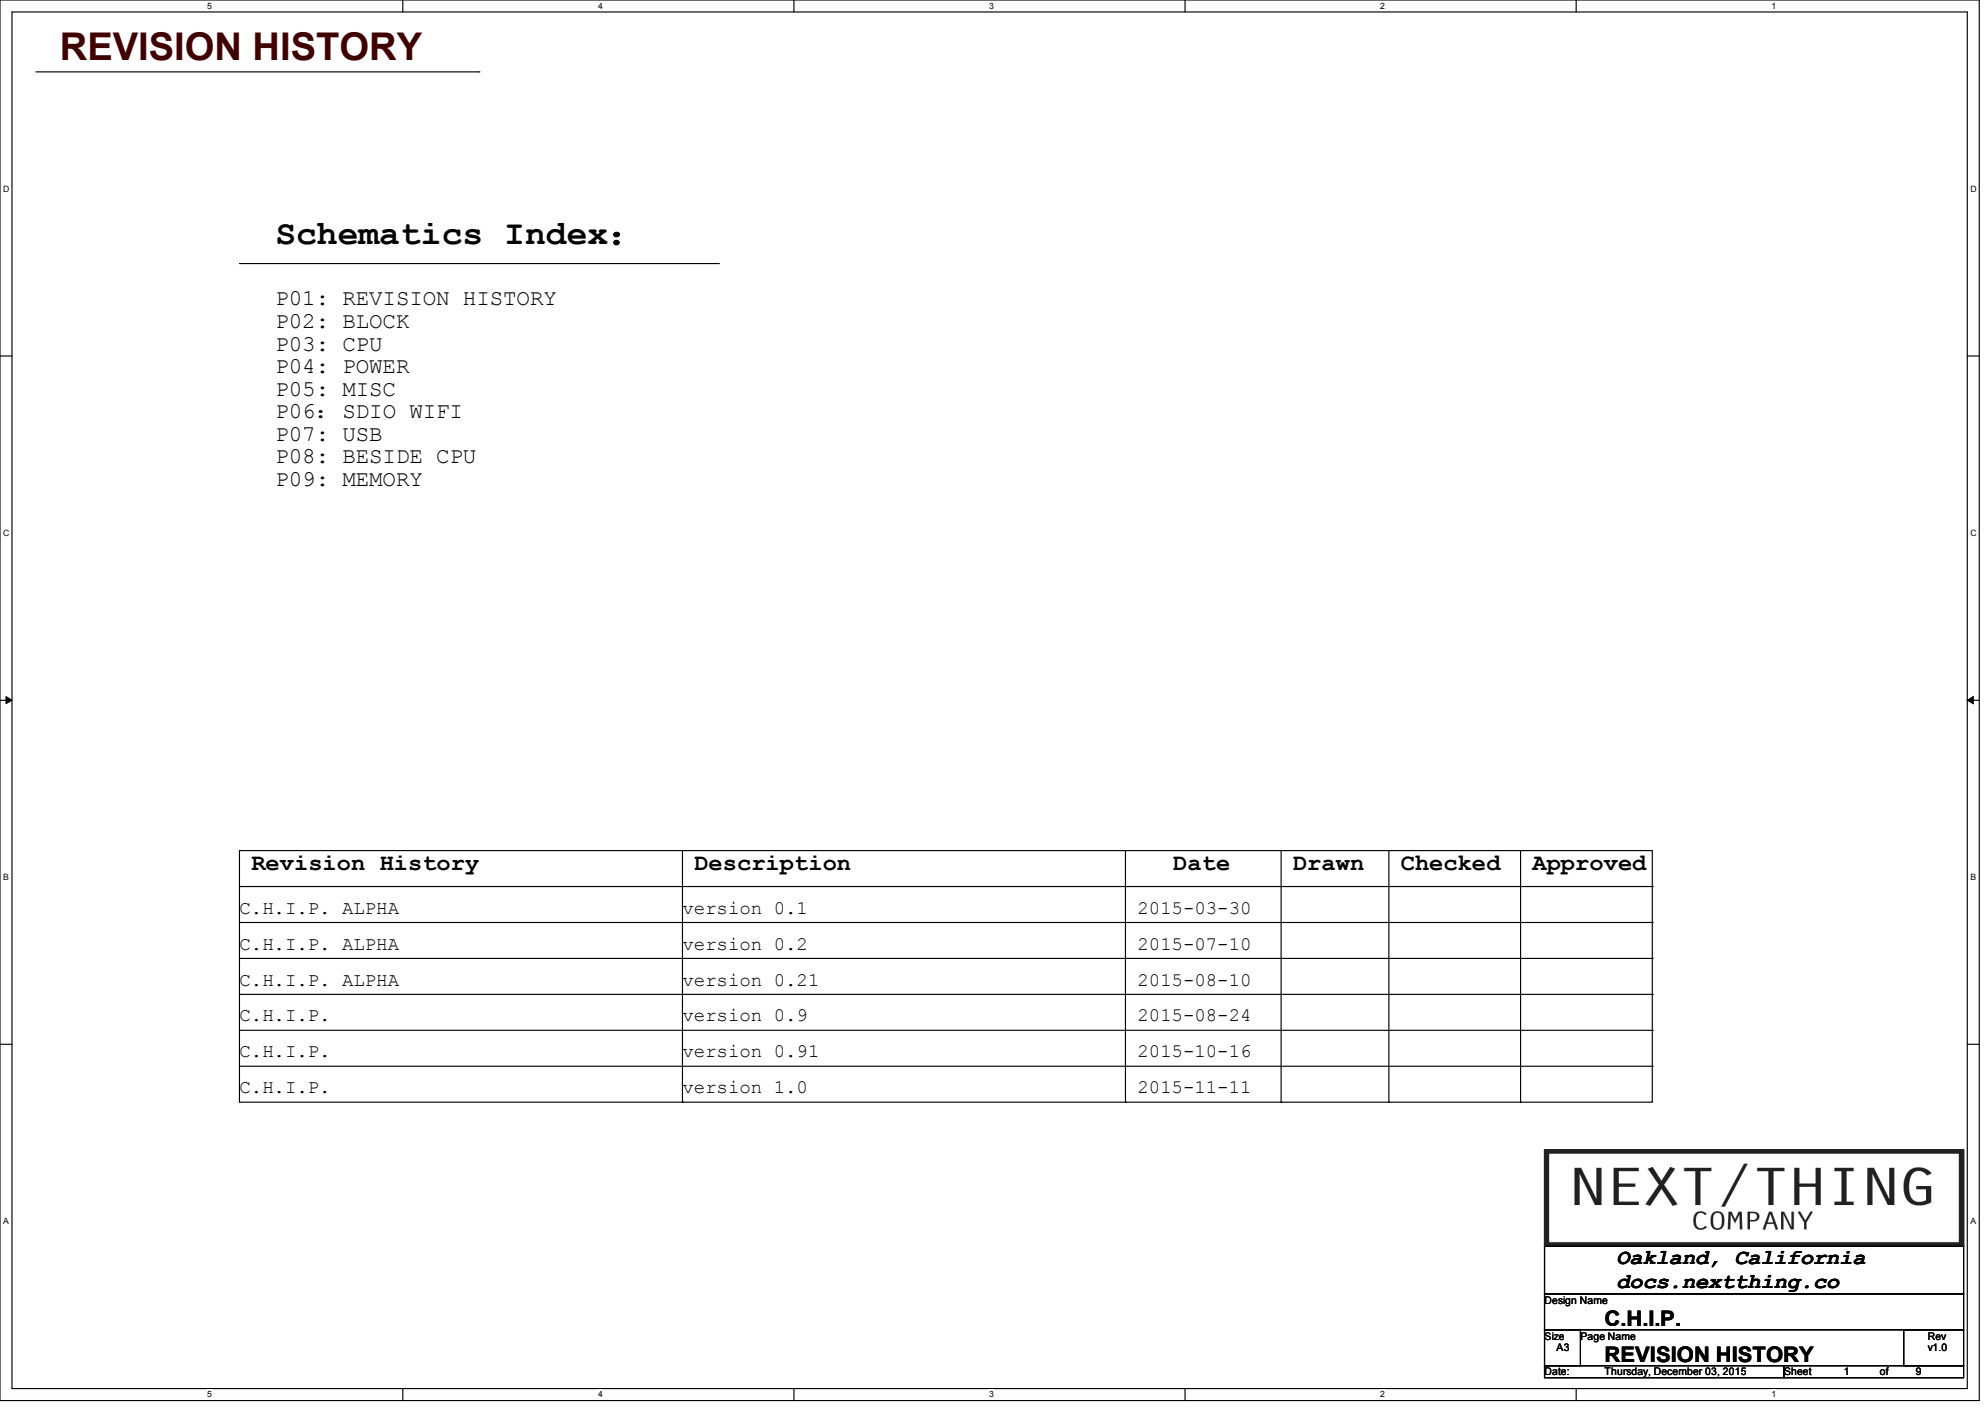
[picture p18: page 1]
Revision History; Description; Date; Drawn; Checked; Approved; P02: BLOCK P03: CPU P04: POWER P05: MISC P06：SDIO WIFI; P07: USB P08: BESIDE CPU P09: MEMORY; REVISION HISTORY; C.H.I.P. ALPHA; version 0.1; version 0.2; version 0.21; version 0.9; version 0.91; version 1.0; Design Name; Size; Page Name; Rev; Date:; Sheet; Thursday, December 03, 2015

Oakland, California
docs.nextthing.co

# BATT

# DCIN

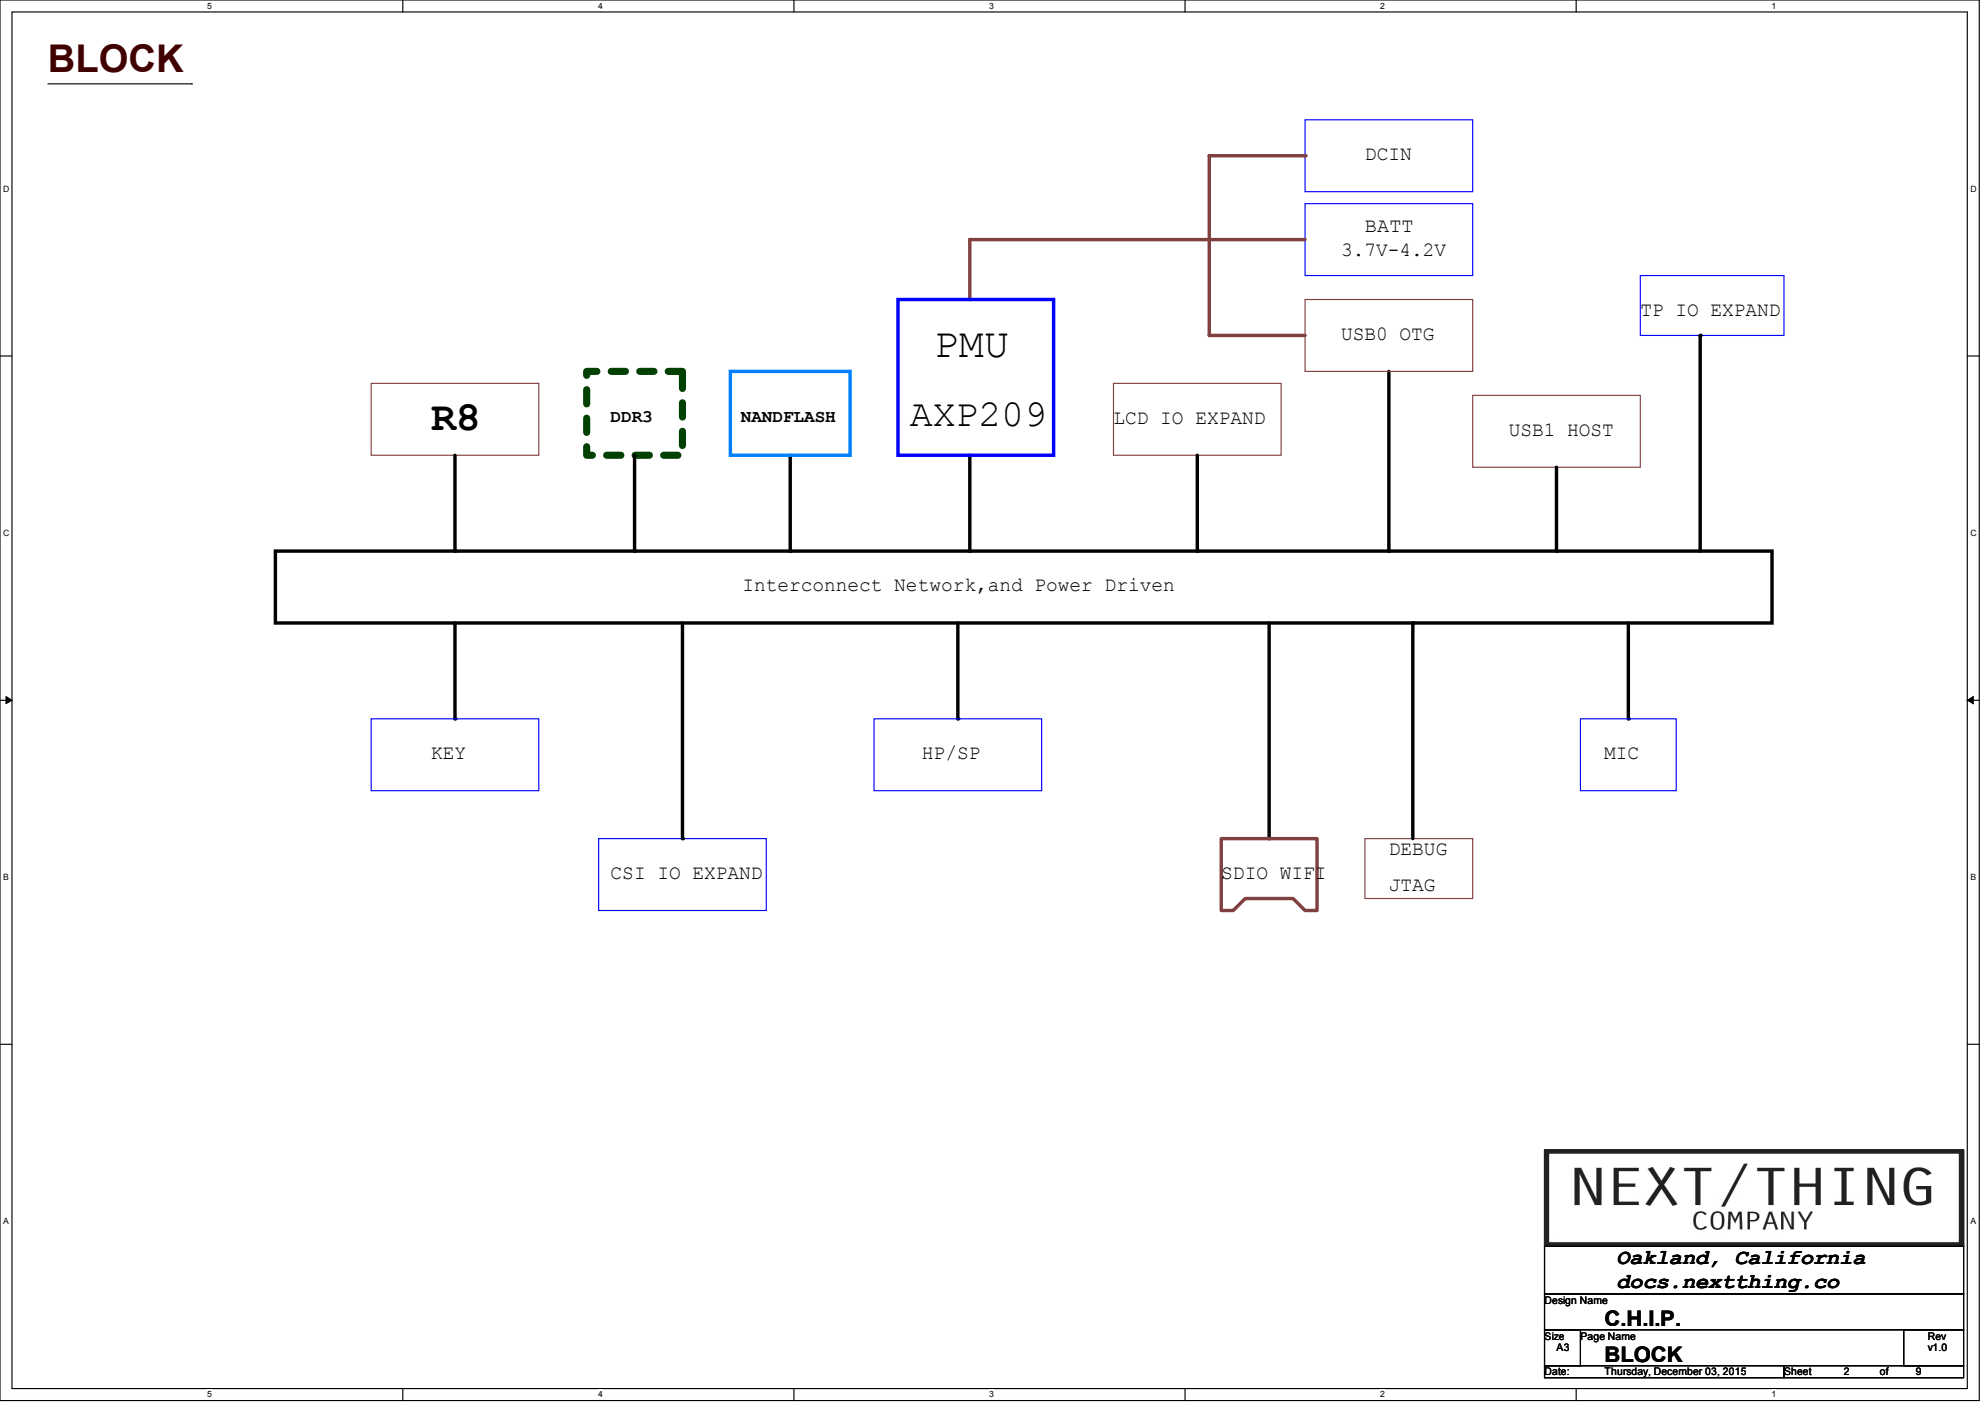
[picture p19: page 2]
SDIO WIFI; USB0 OTG; DEBUG; JTAG; KEY; PMU; AXP209; MIC; BLOCK; NANDFLASH; USB1 HOST R8; DDR3; Thursday, December 03, 2015

TP IO EXPAND

LCD IO EXPAND

Interconnect Network,and Power Driven

CSI IO EXPAND

Oakland, California
docs.nextthing.co

# CPU

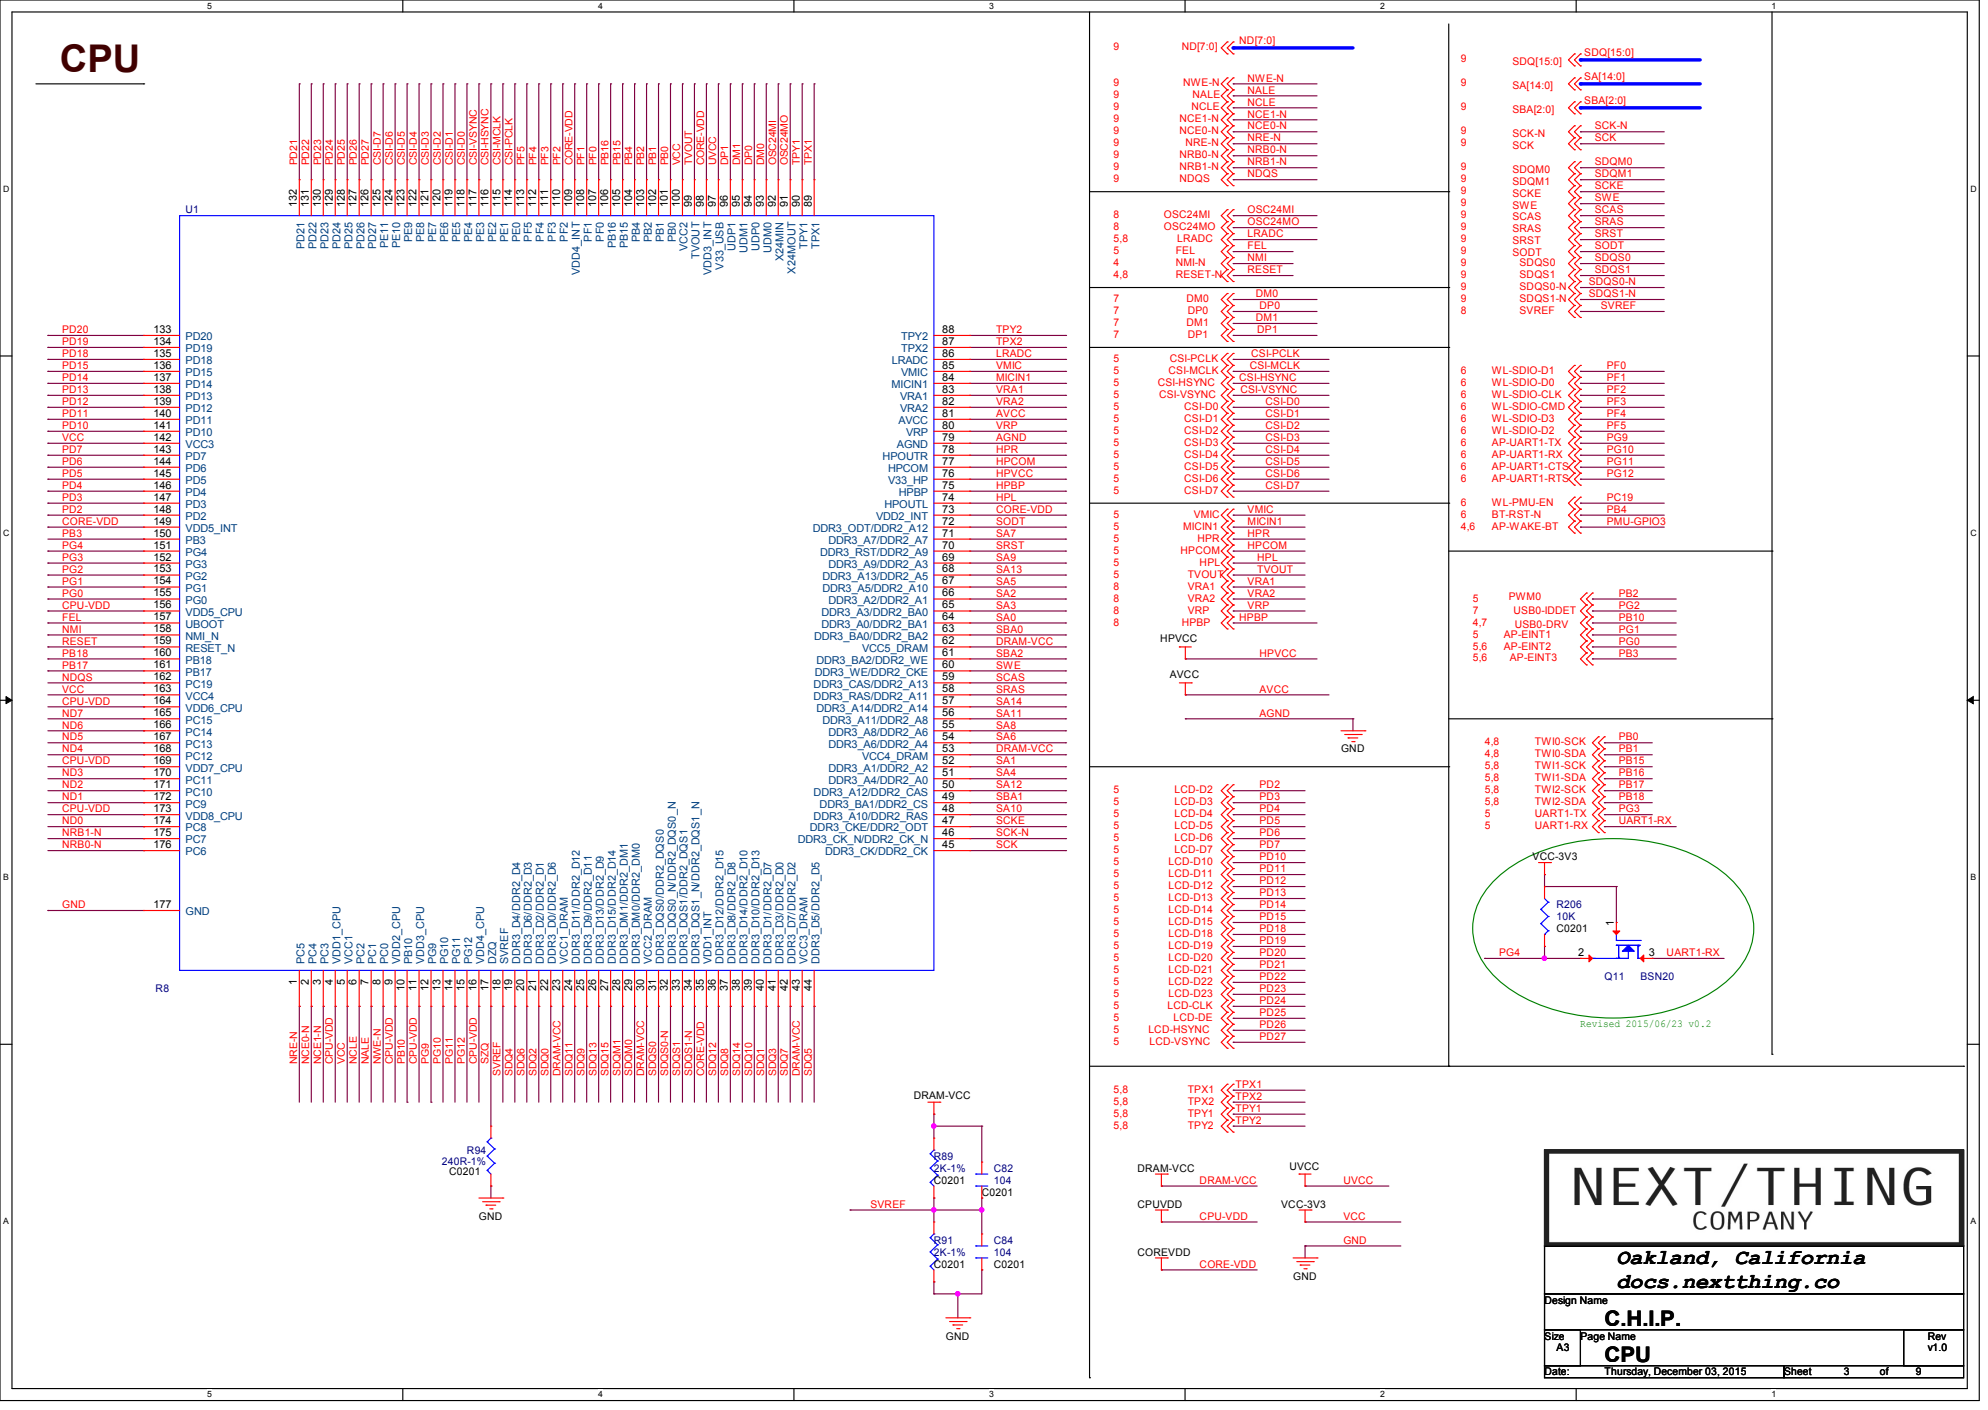
[picture p20: page 3]

# POWER/PMU

# IPSOUT TO 5V FOR SYS

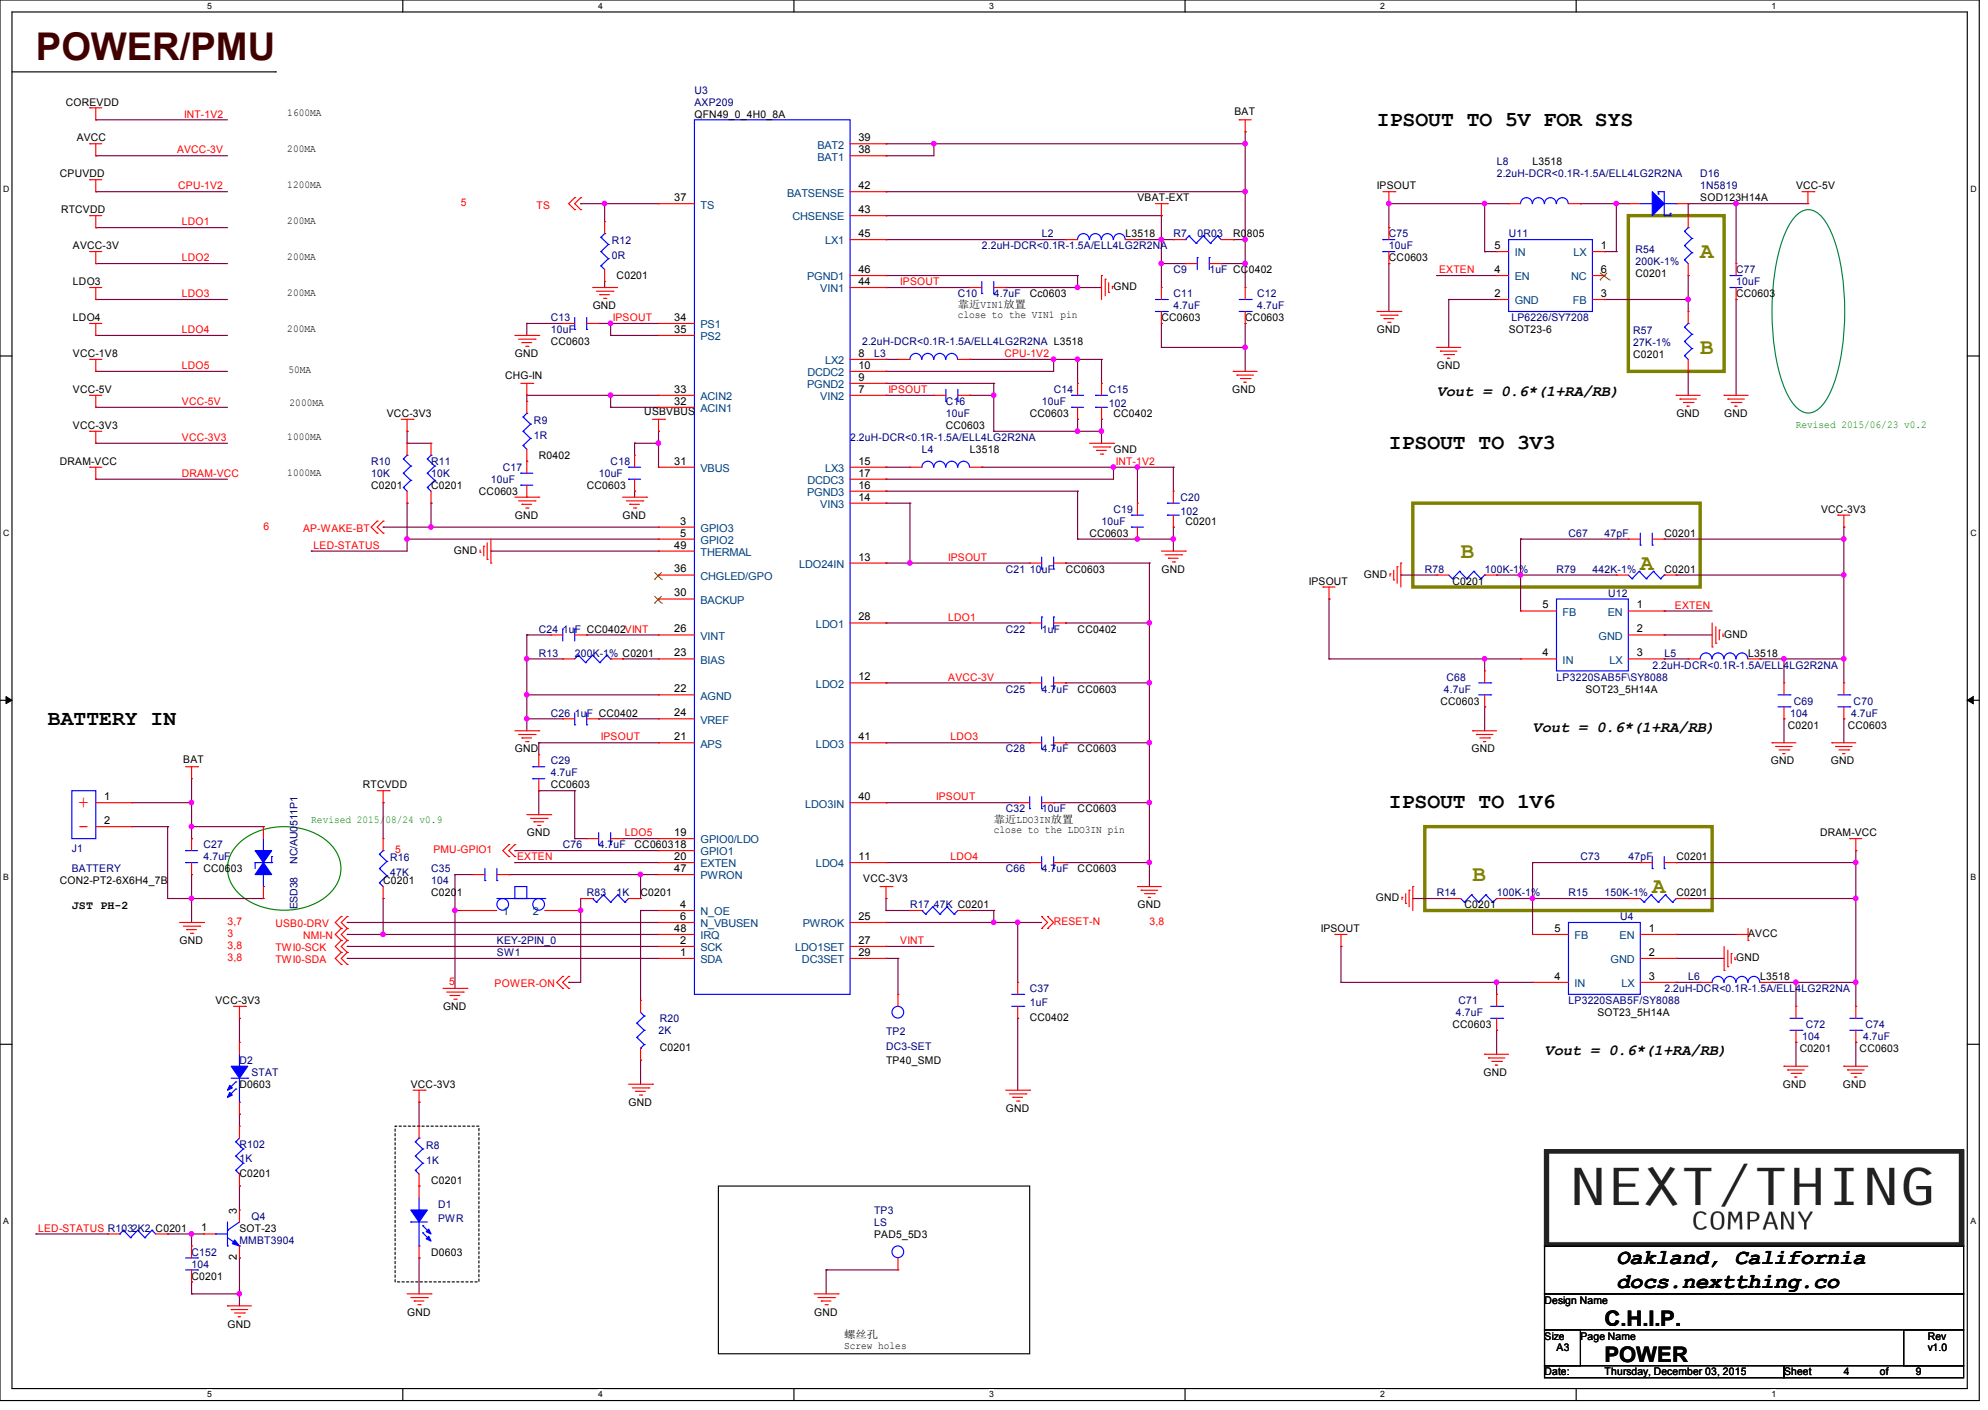
[picture p21: page 4]

靠近VIN1放置
close to the VIN1 pin

靠近LDO3IN放置
close to the LDO3IN pin

# MISC

## Note:

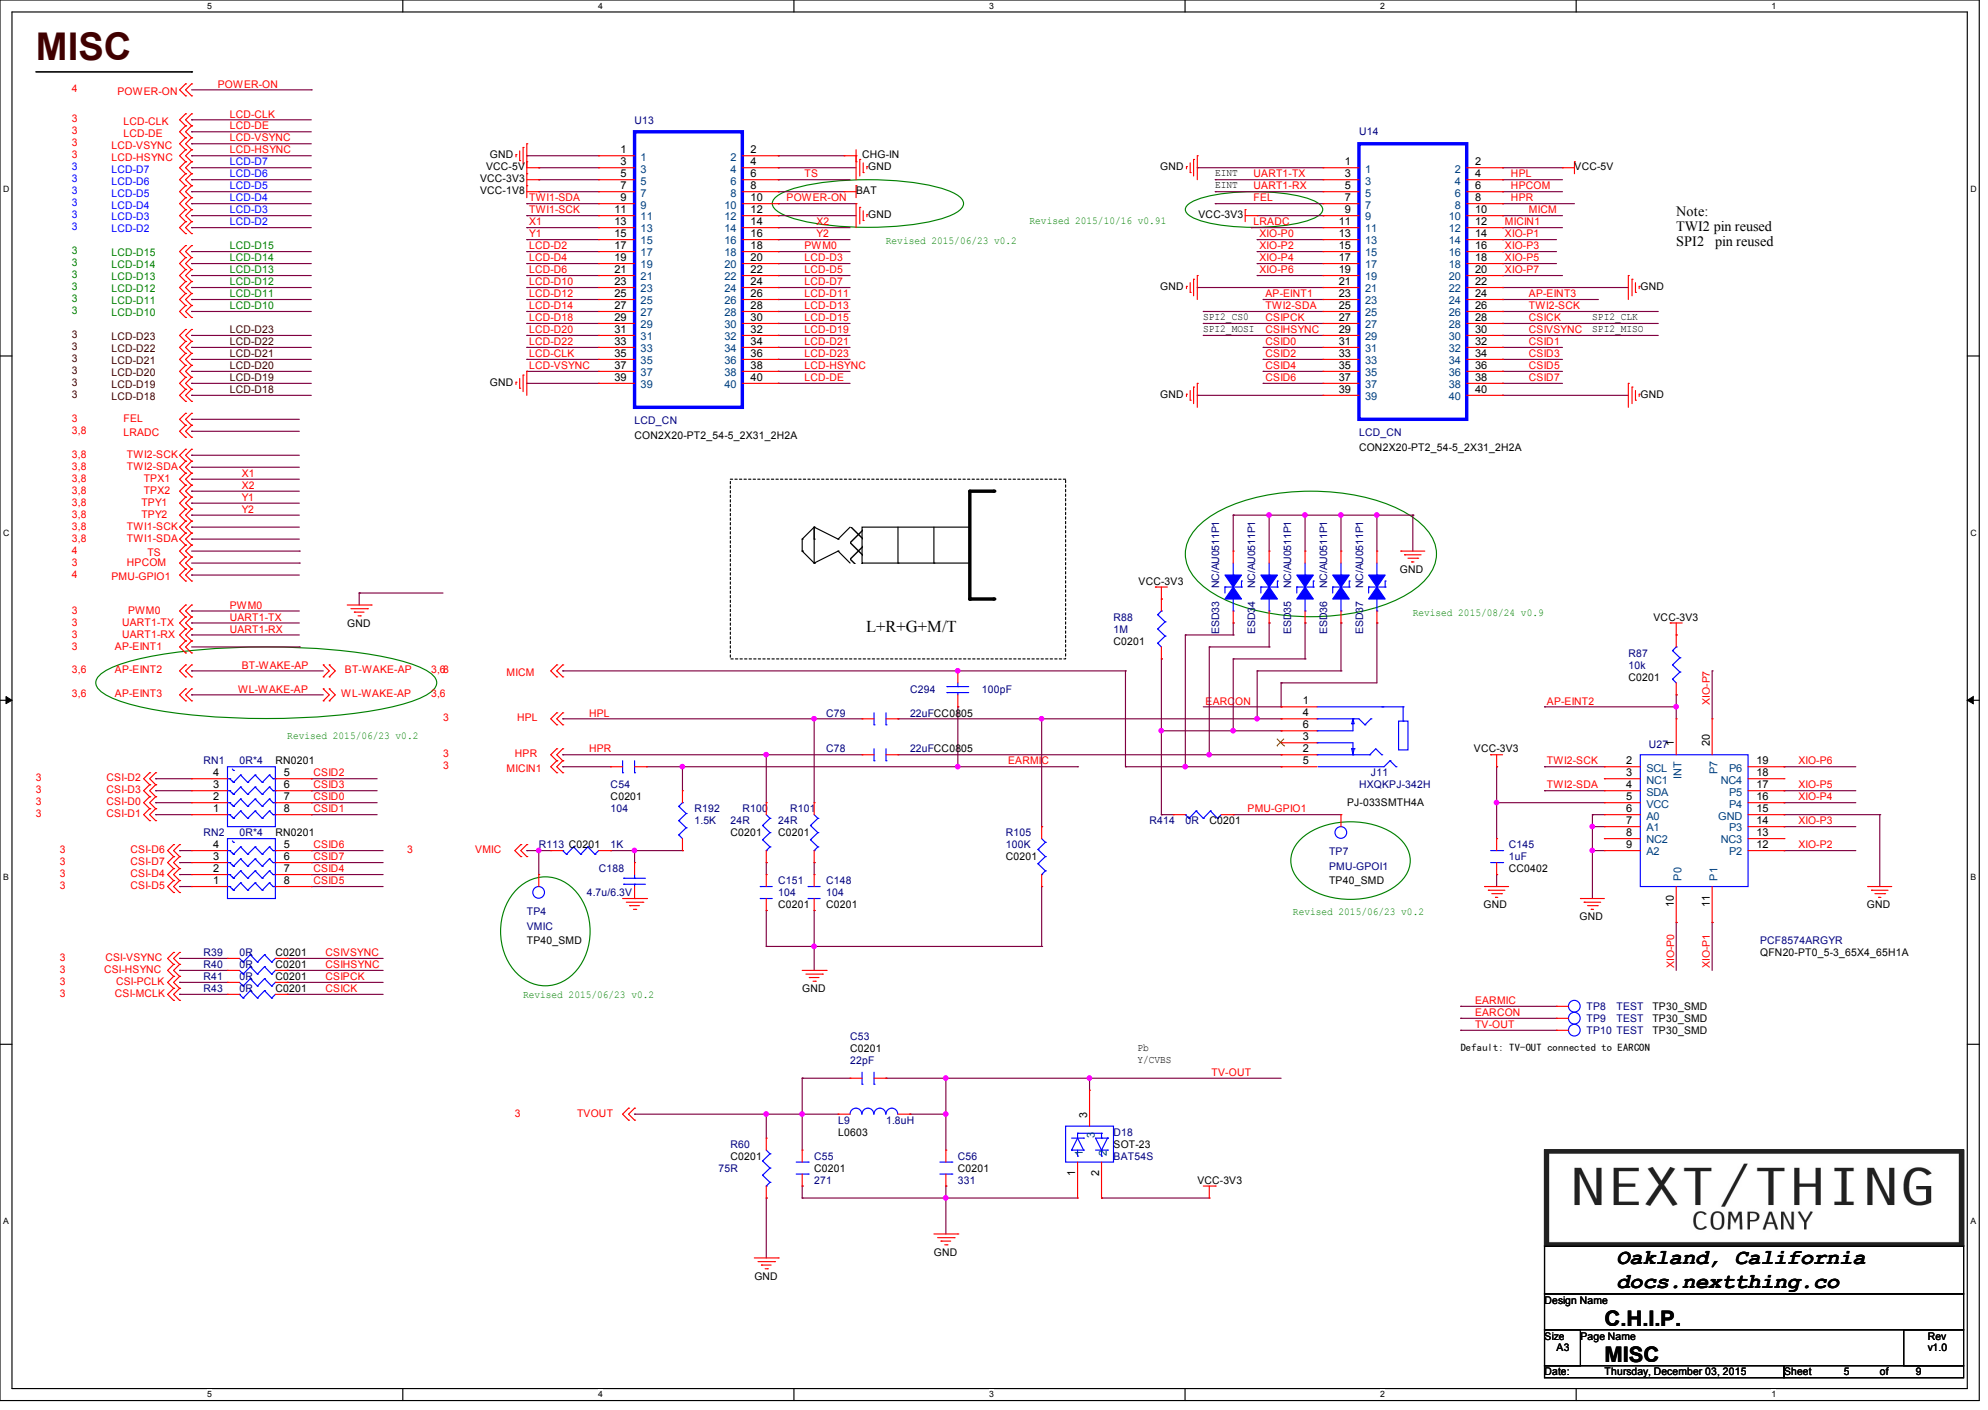
[picture p22: page 5]

EARMIC | | 6

Default: TV-OUT connected to EARCON

A

B

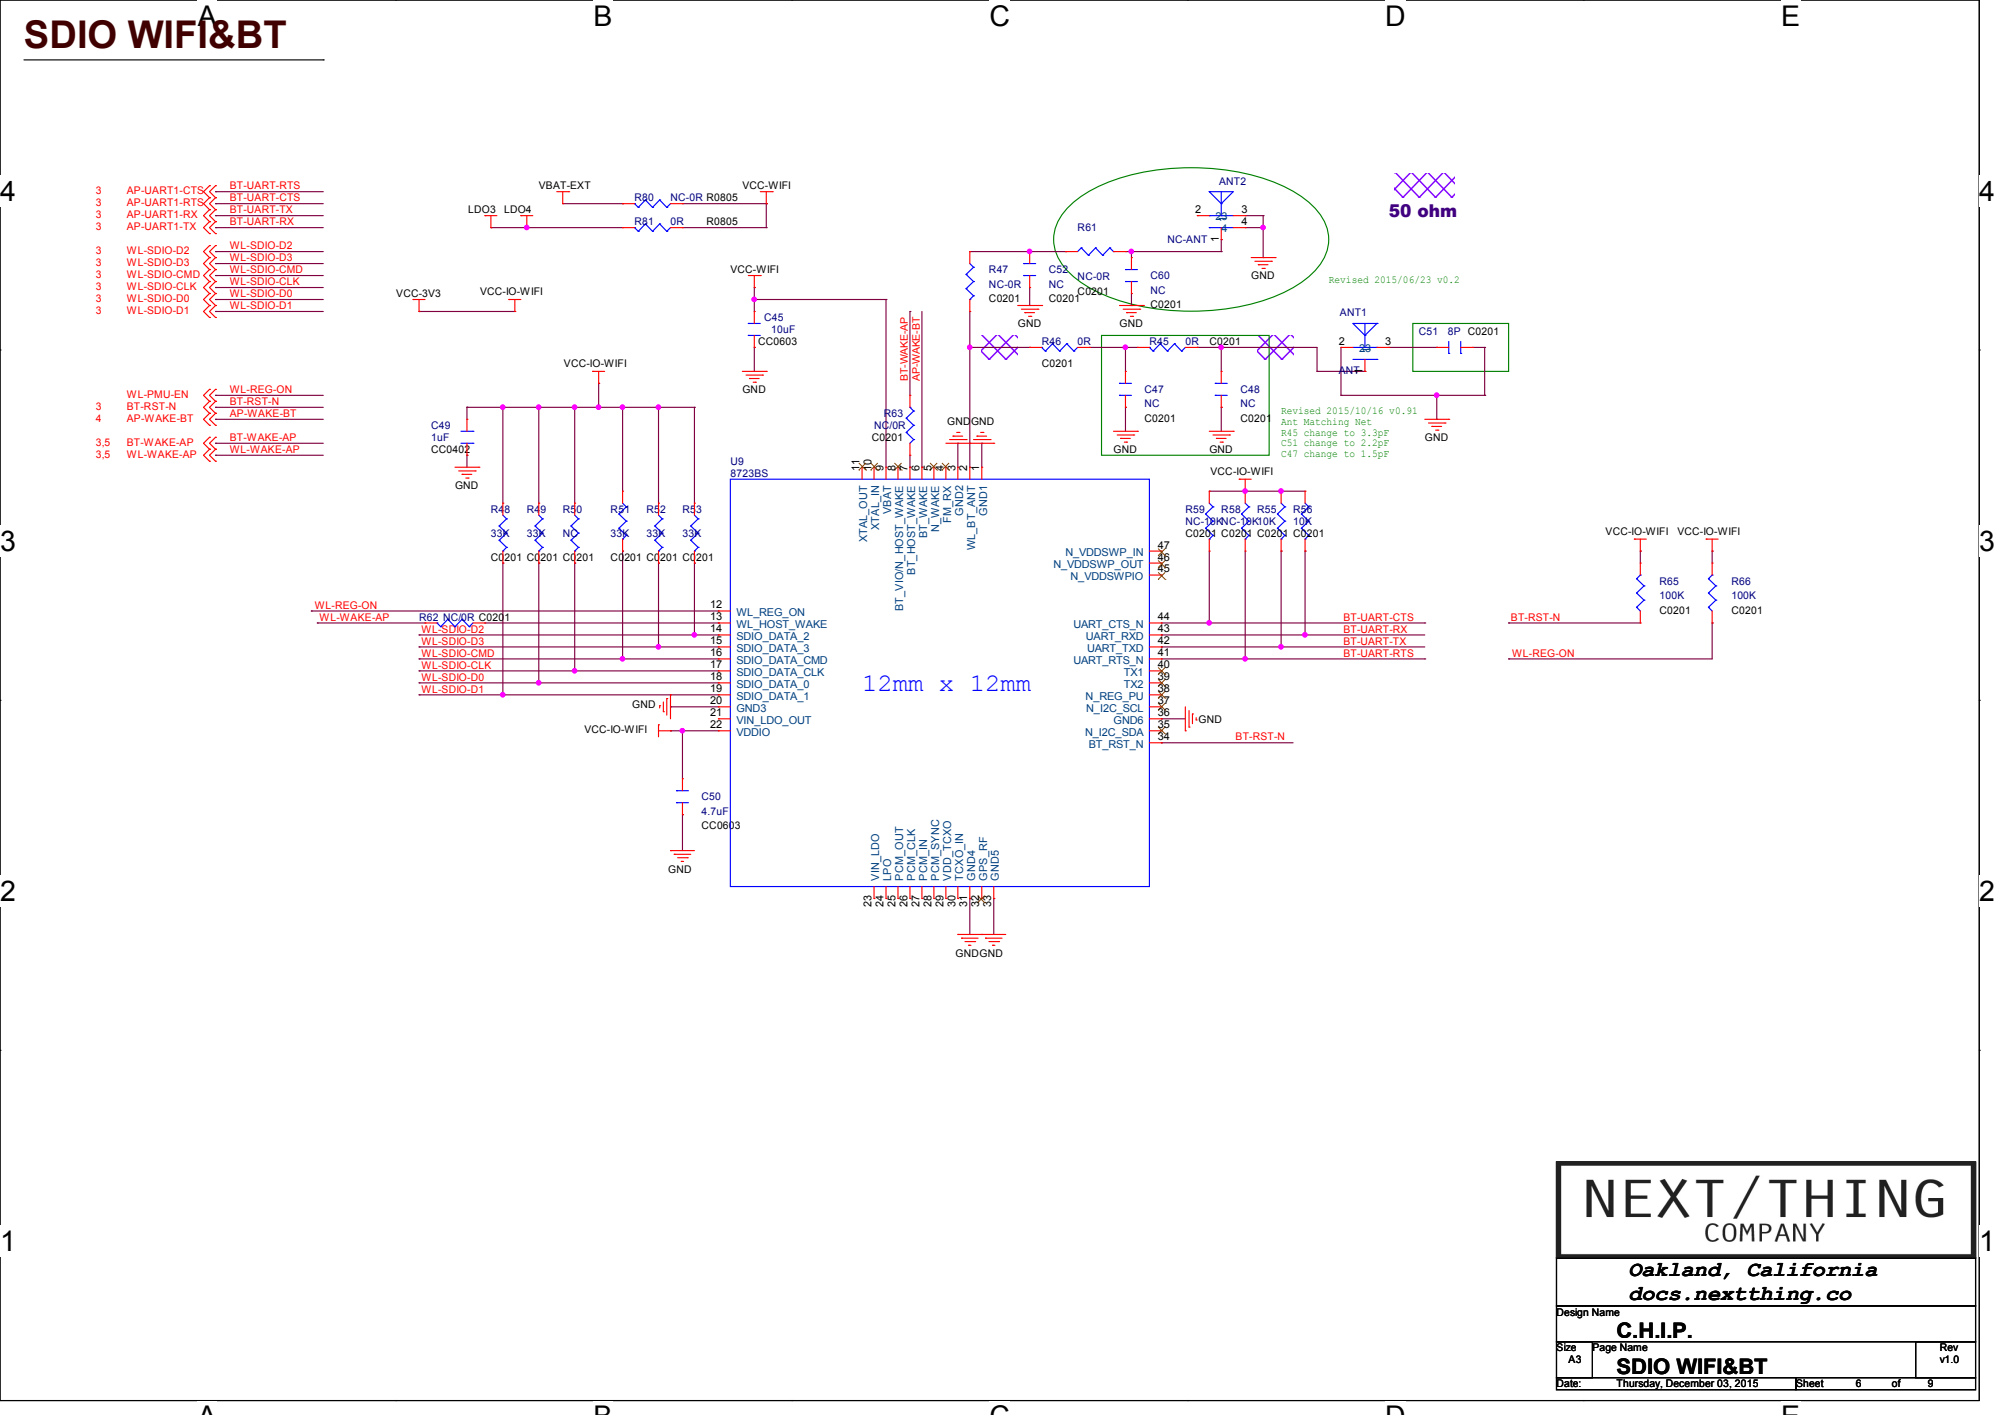
[picture p23: page 6]

VCC-IO-WIFI

# USB

# USB

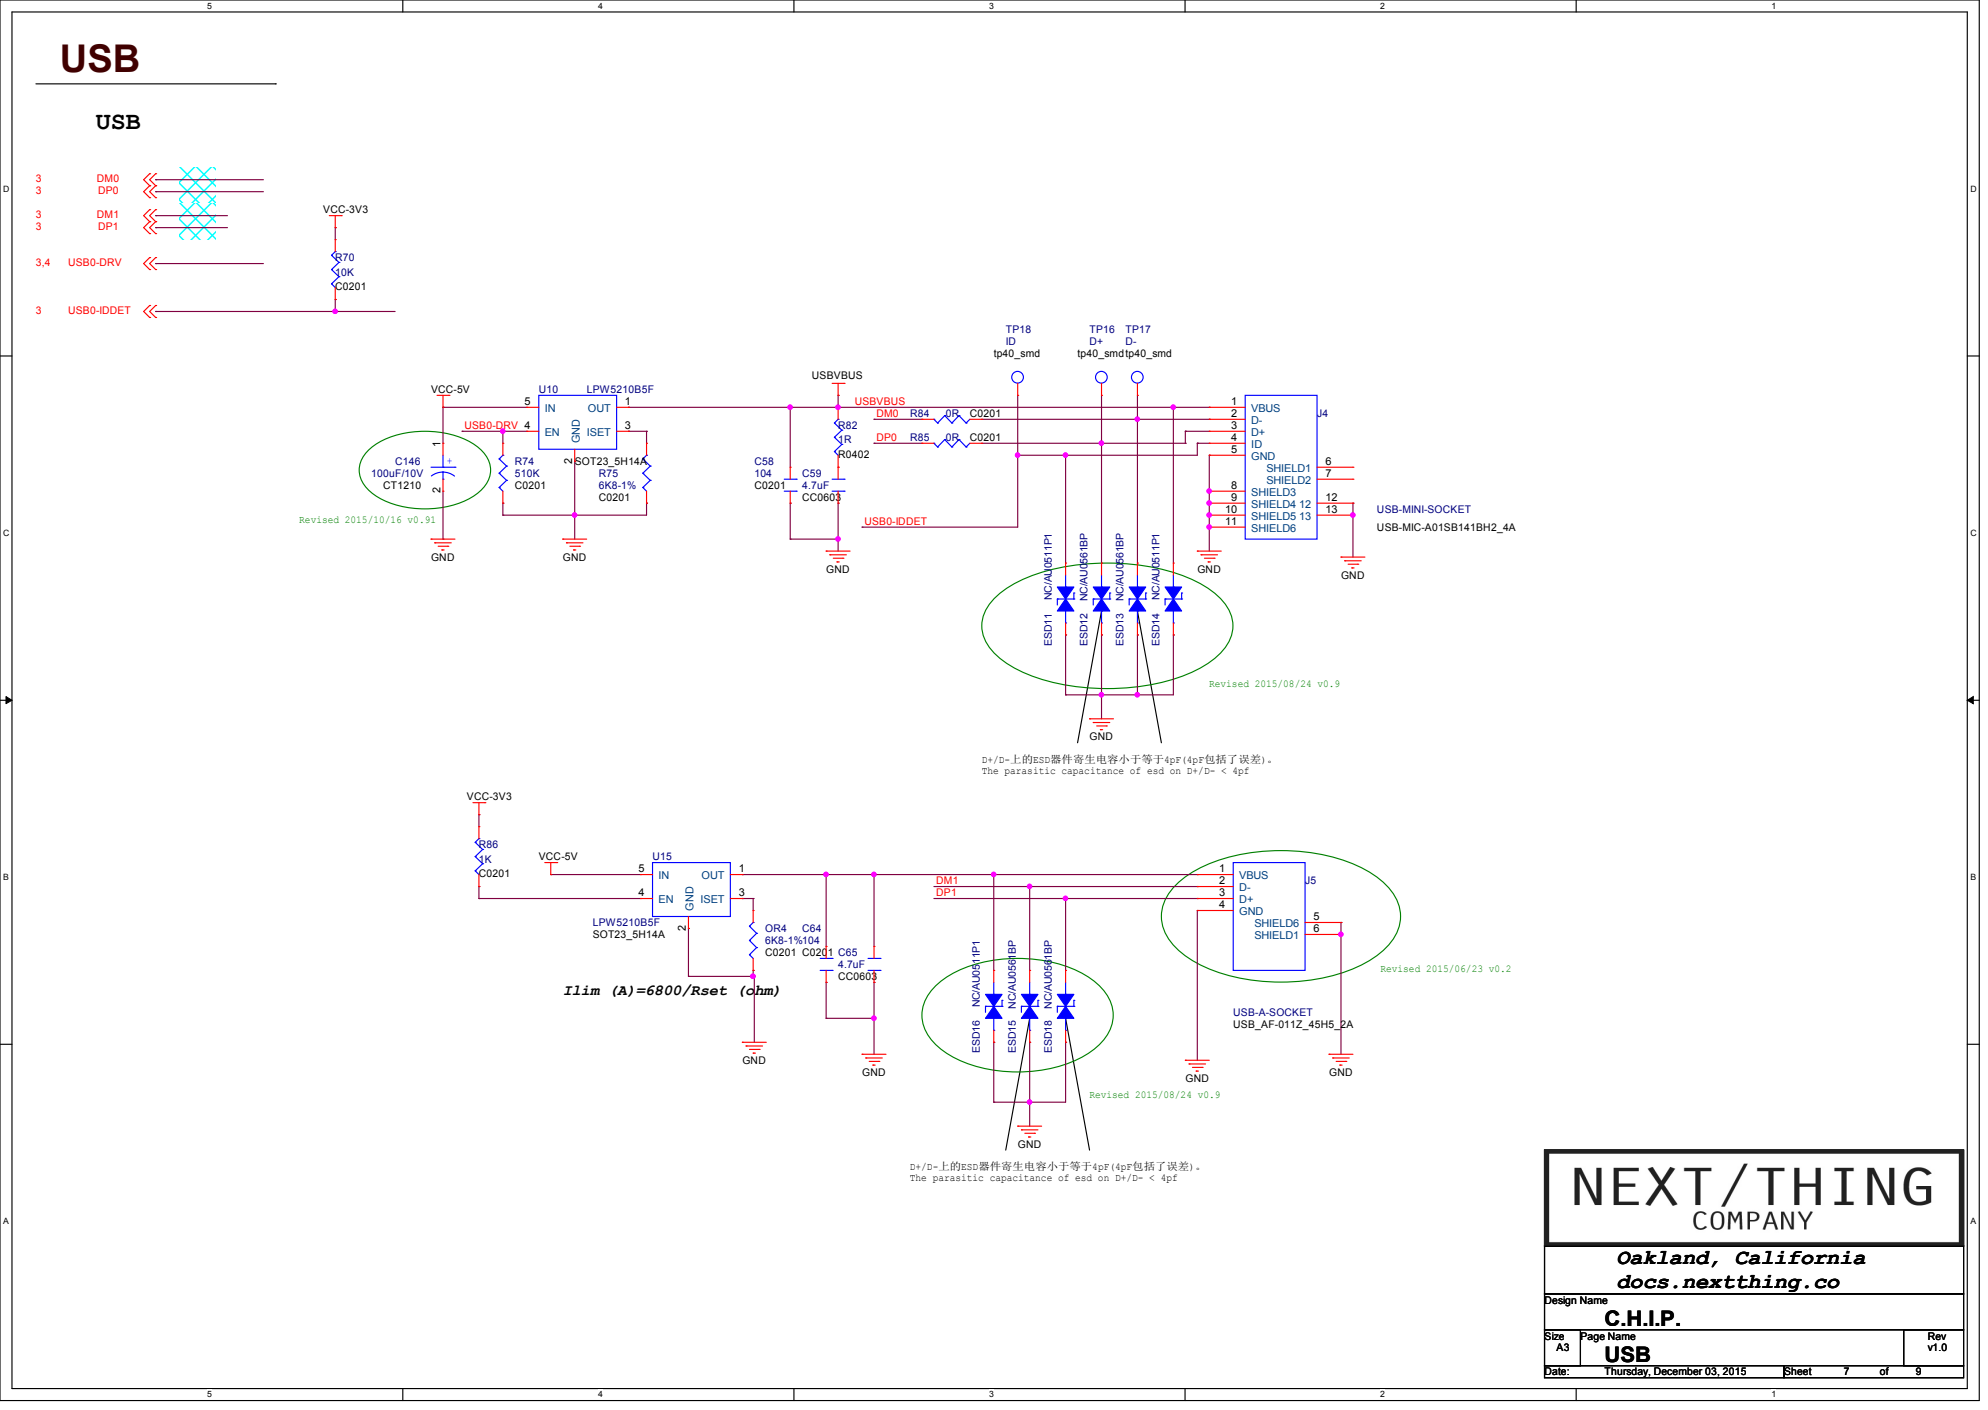
[picture p24: page 7]

D+/D-上的ESD器件寄生电容小于等于4pF(4pF包括了误差)。
The parasitic capacitance of esd on D+/D- < 4pf

# DRAM

# PIO-INTFACE

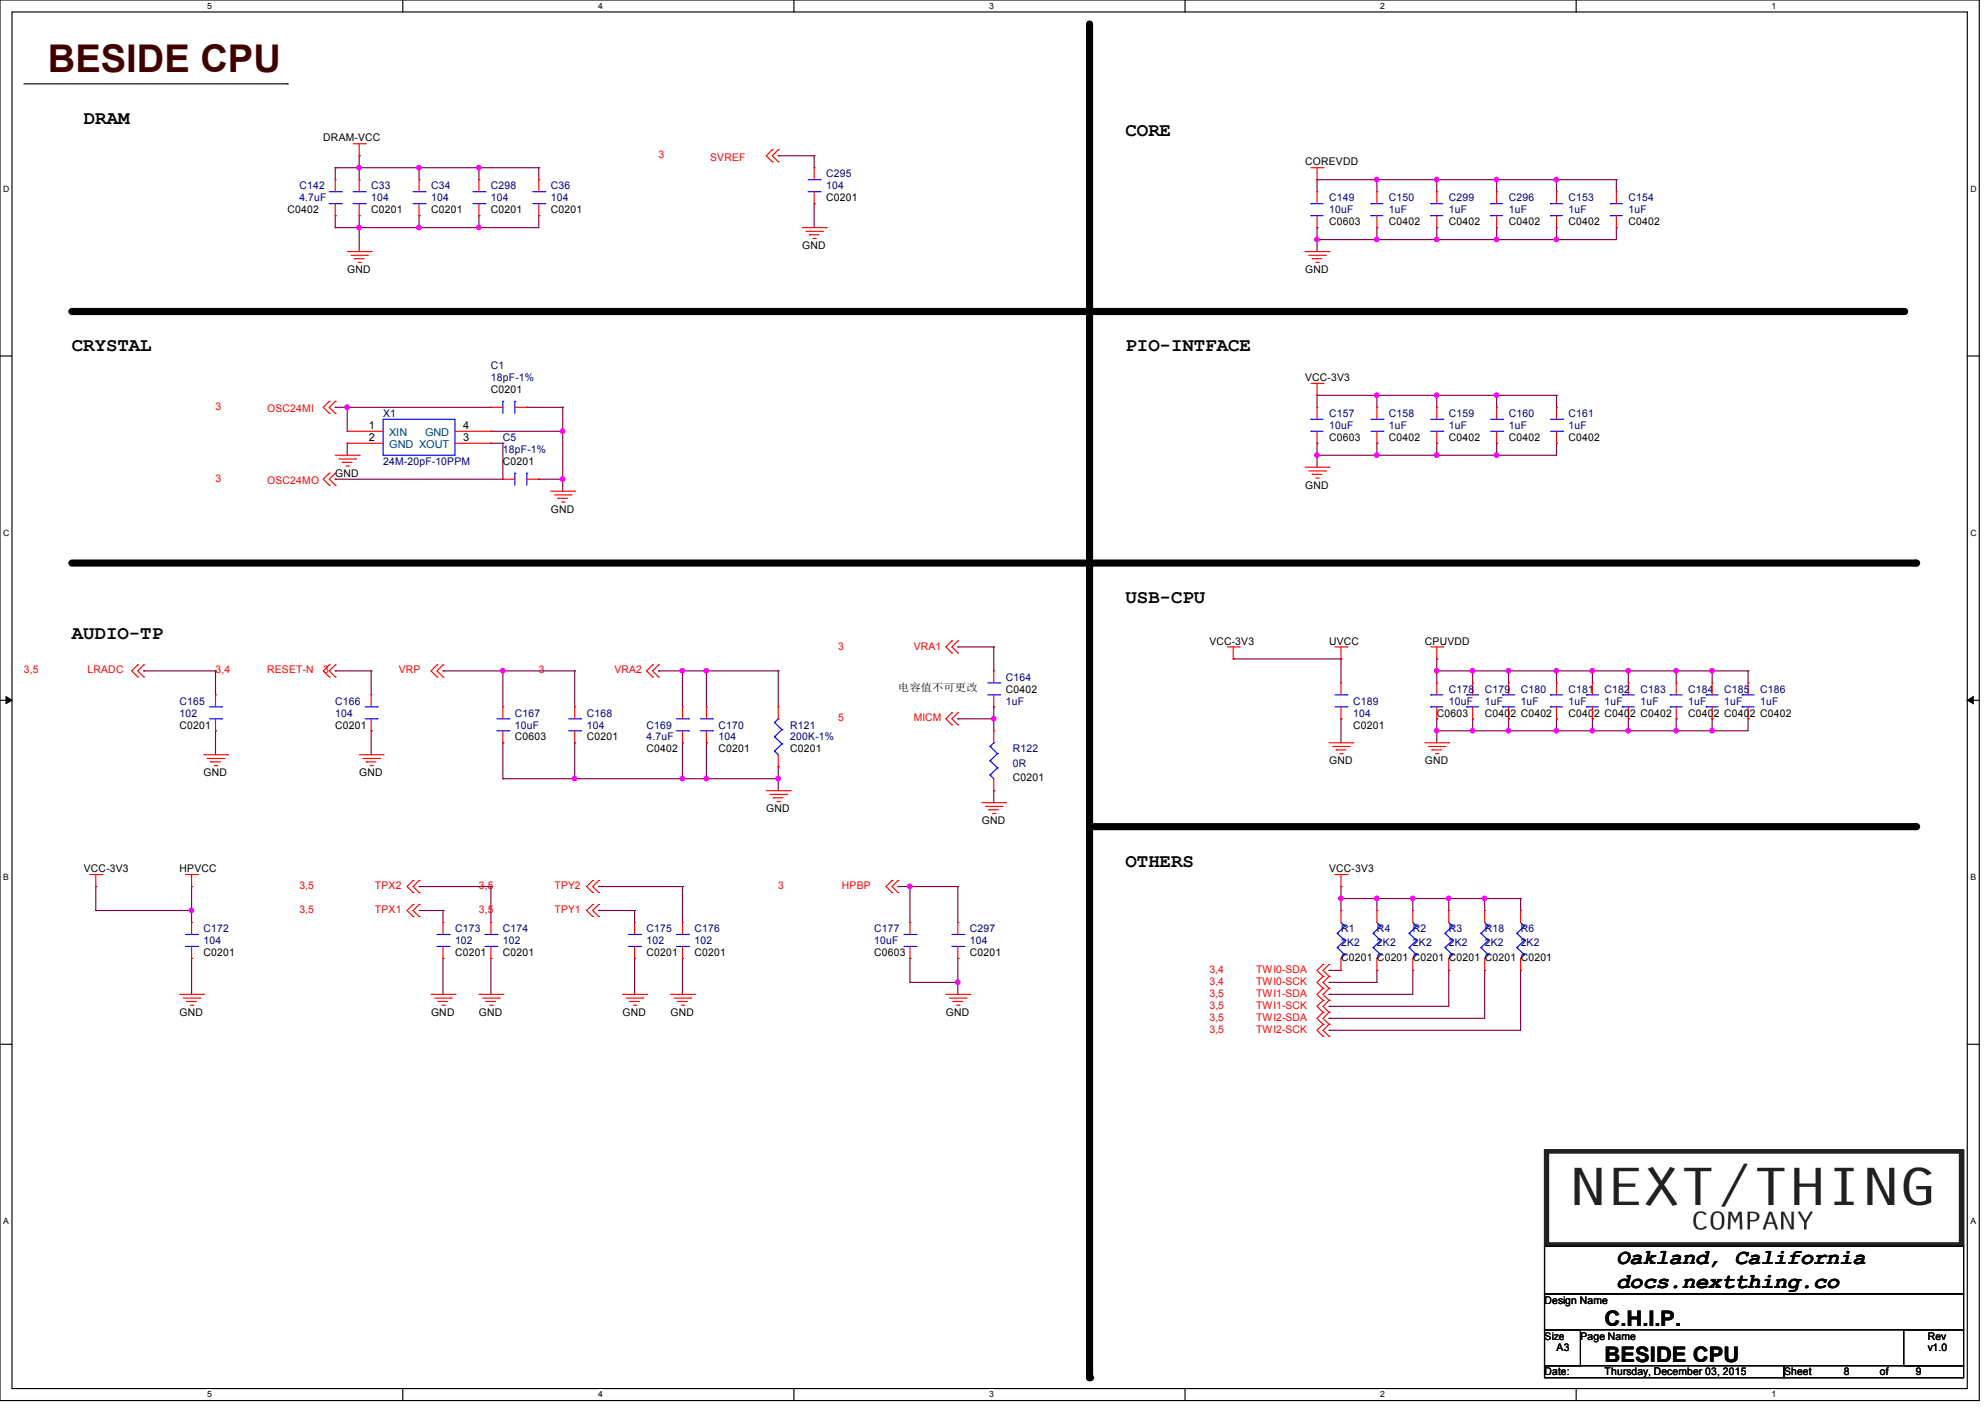
[picture p25: page 8]

# MEMORY

DDR3 | NAND

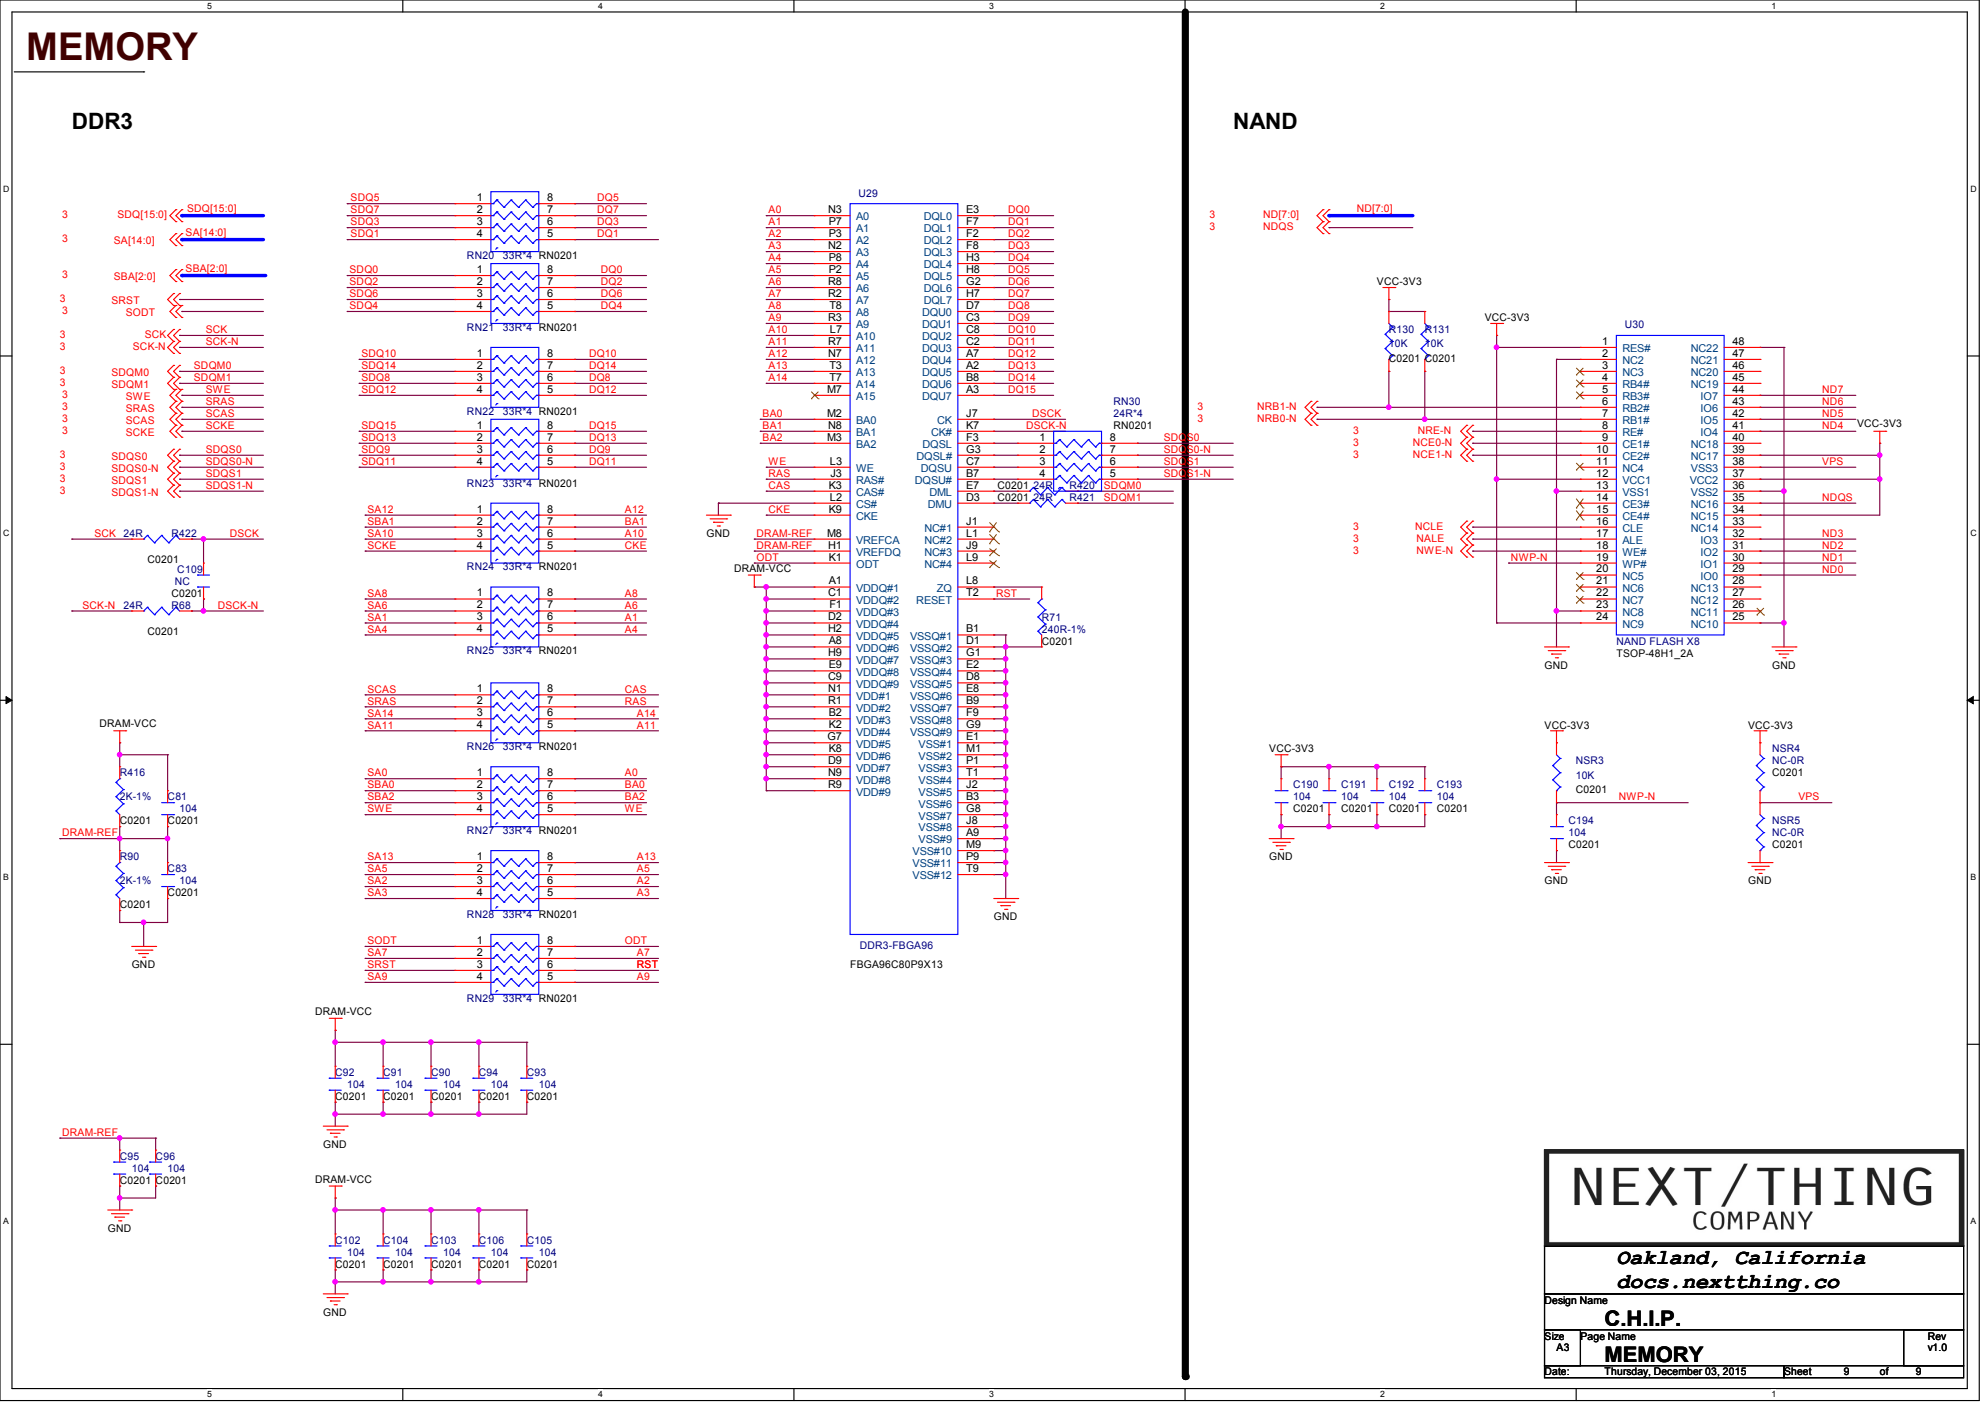
[picture p26: page 9]
