joelguittet/chip-hardware/ALPHA-CHIP[v0_21]/CHIP_ALPHA_V_021.pdf

# Schematics Index：

# P01: REVISION HISTORY

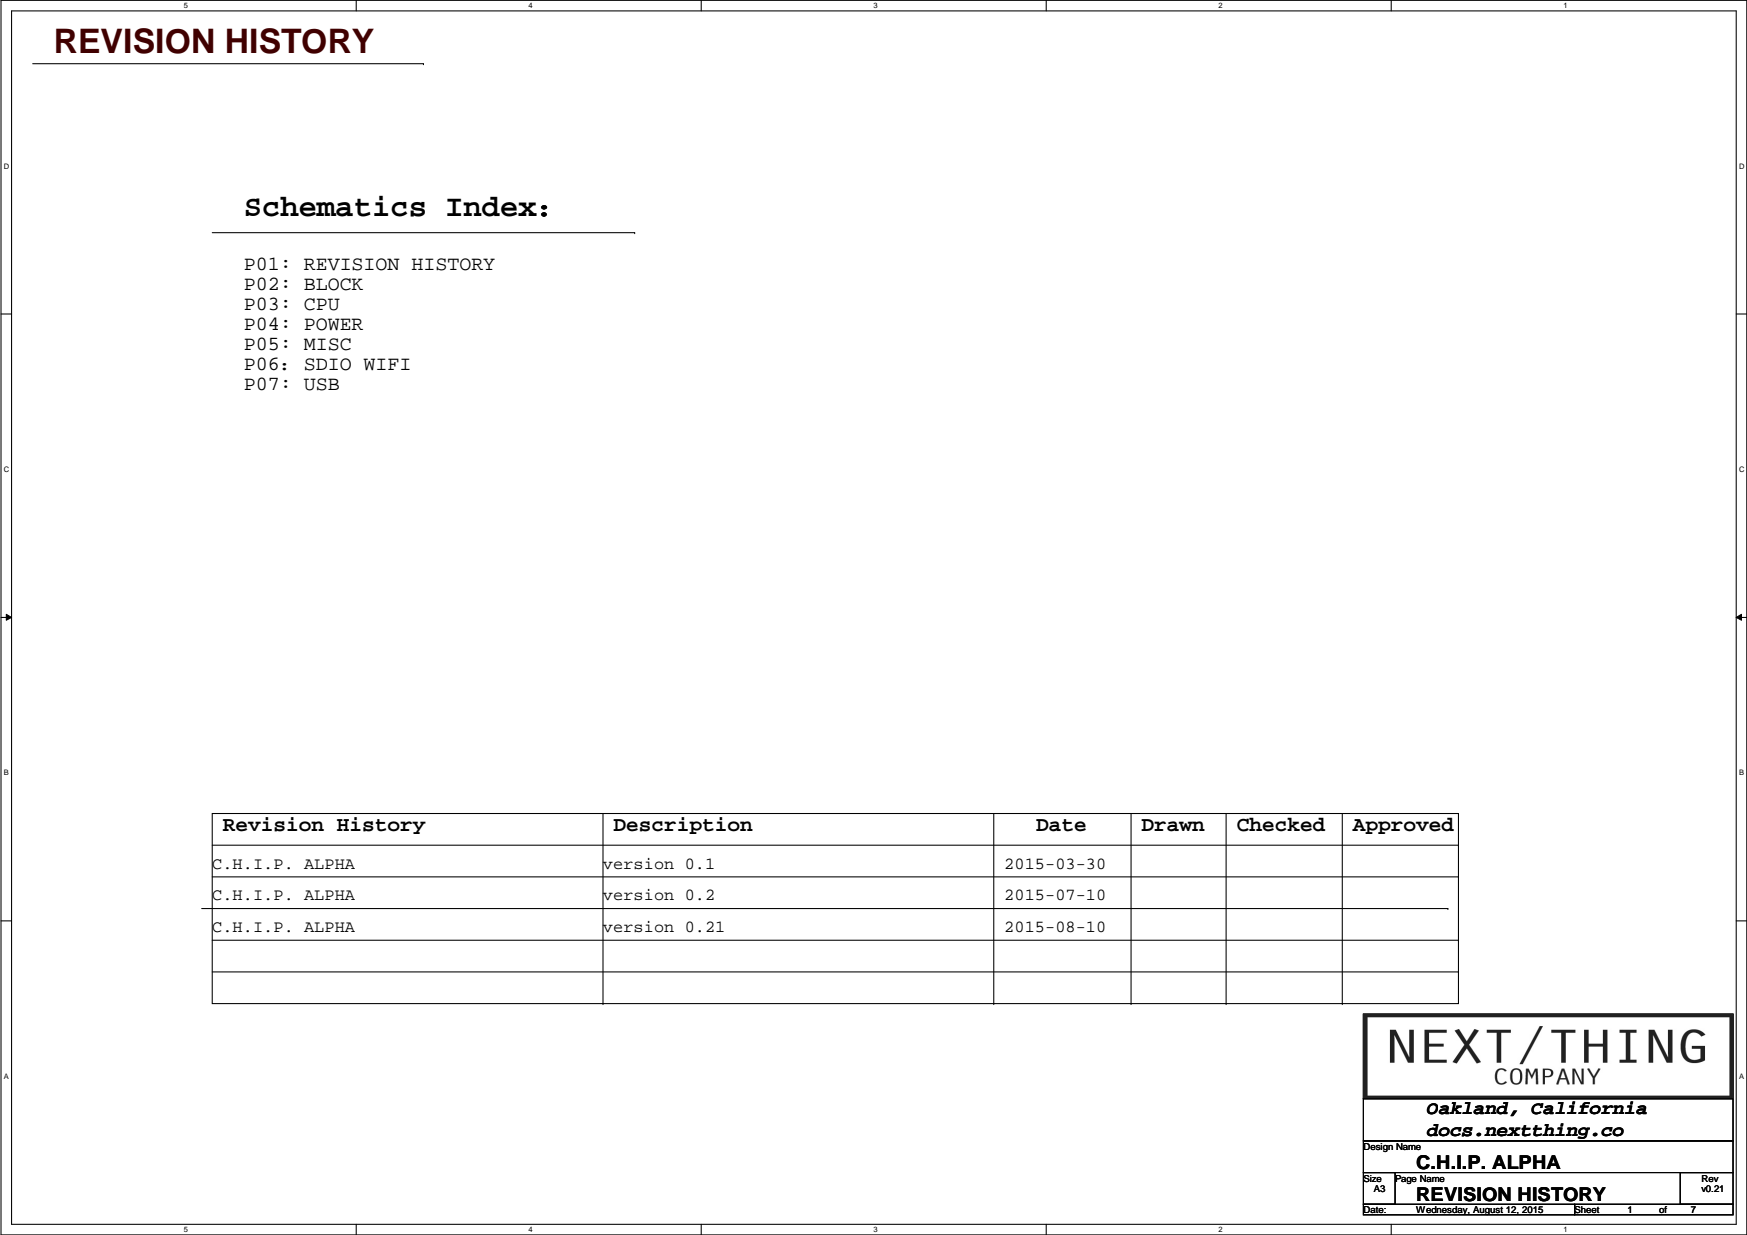
[picture p27: page 1]
Revision History; Description; Date; Drawn; Checked; Approved; P02: BLOCK P03: CPU P04: POWER P05: MISC P06：SDIO WIFI P07: USB; REVISION HISTORY; C.H.I.P. ALPHA; version 0.1; version 0.2; version 0.21; Design Name; Size; Page Name; Rev; Date:; Sheet; Wednesday, August 12, 2015

Oakland, California
docs.nextthing.co
C.H.I.P. ALPHA

# BATT

# DCIN

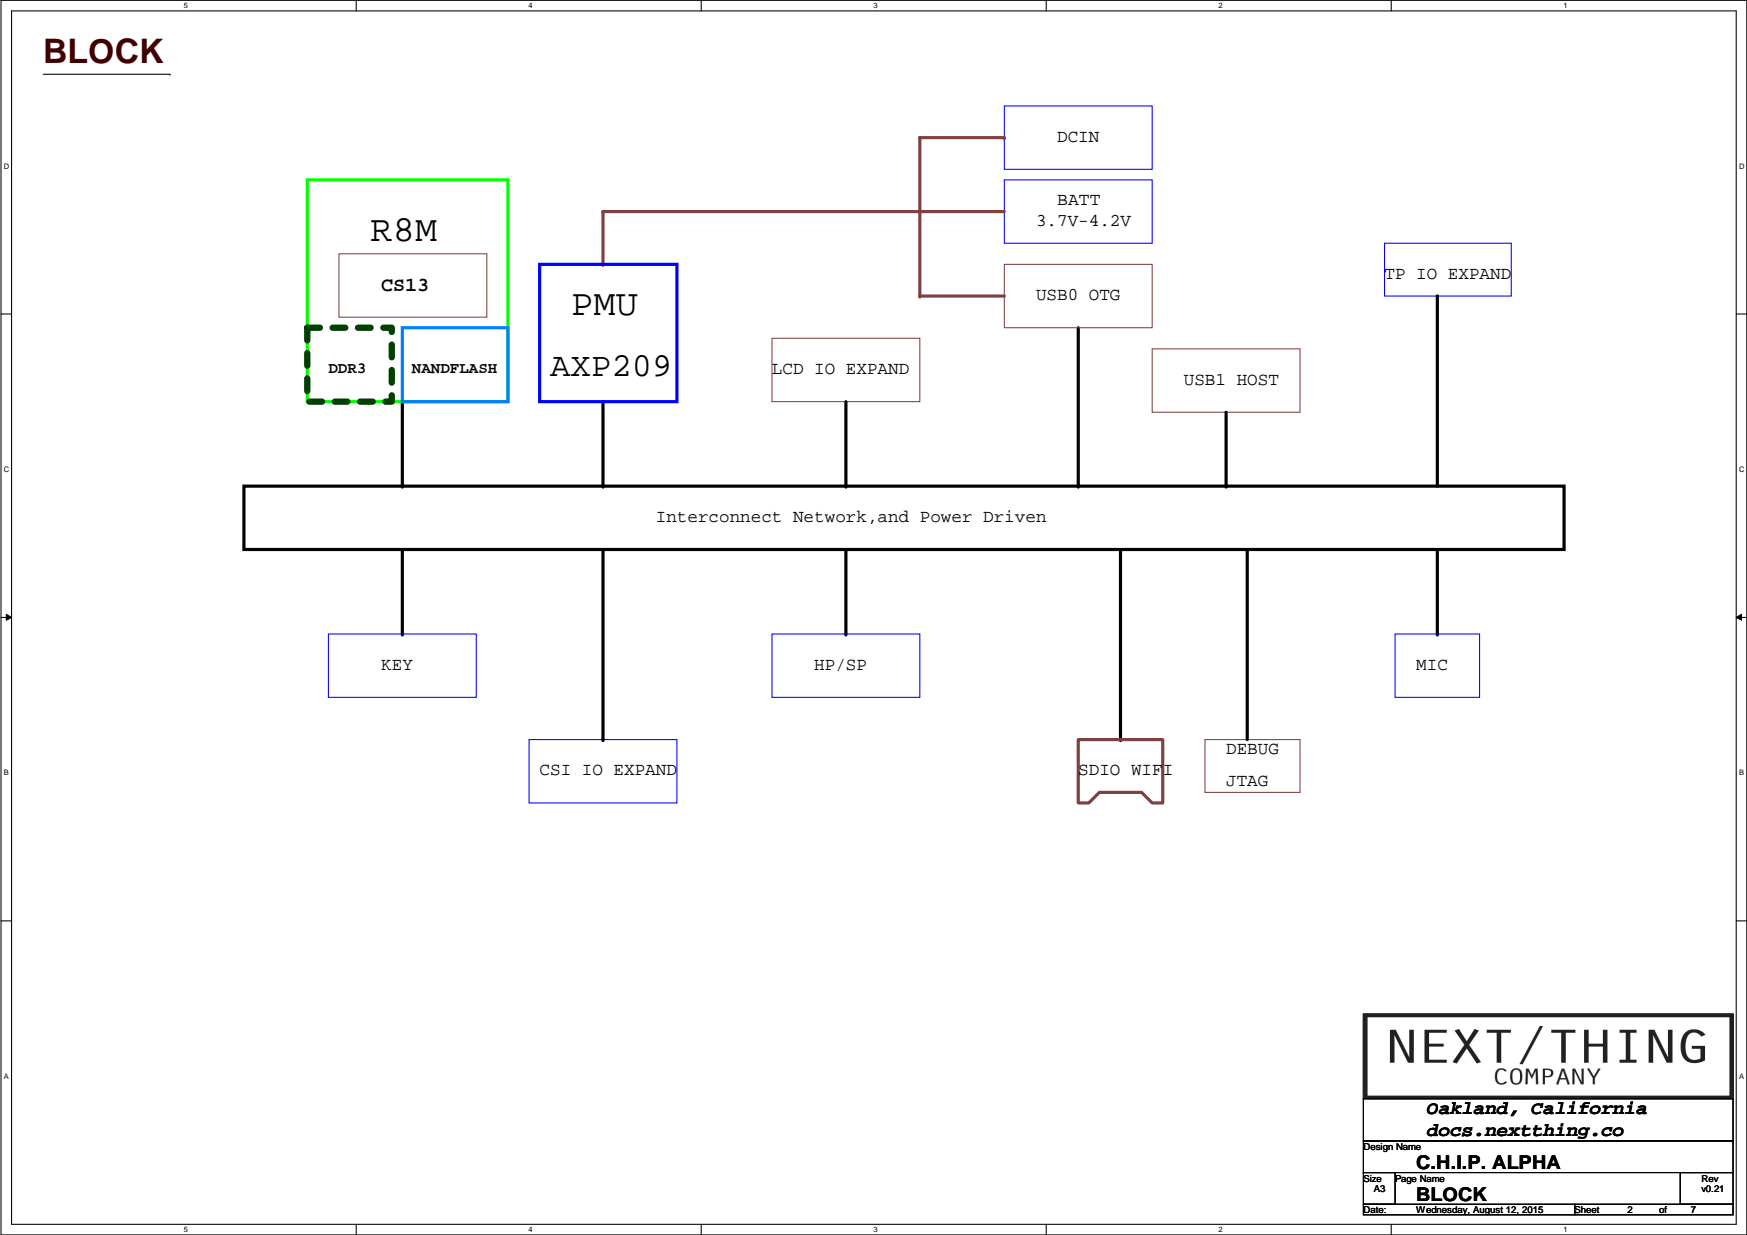
[picture p28: page 2]
SDIO WIFI; USB0 OTG; DEBUG; JTAG; KEY; PMU; AXP209; MIC; BLOCK; NANDFLASH; USB1 HOST; DDR3; Wednesday, August 12, 2015

TP IO EXPAND

LCD IO EXPAND

Interconnect Network,and Power Driven

CSI IO EXPAND

Oakland, California
docs.nextthing.co

# CPU

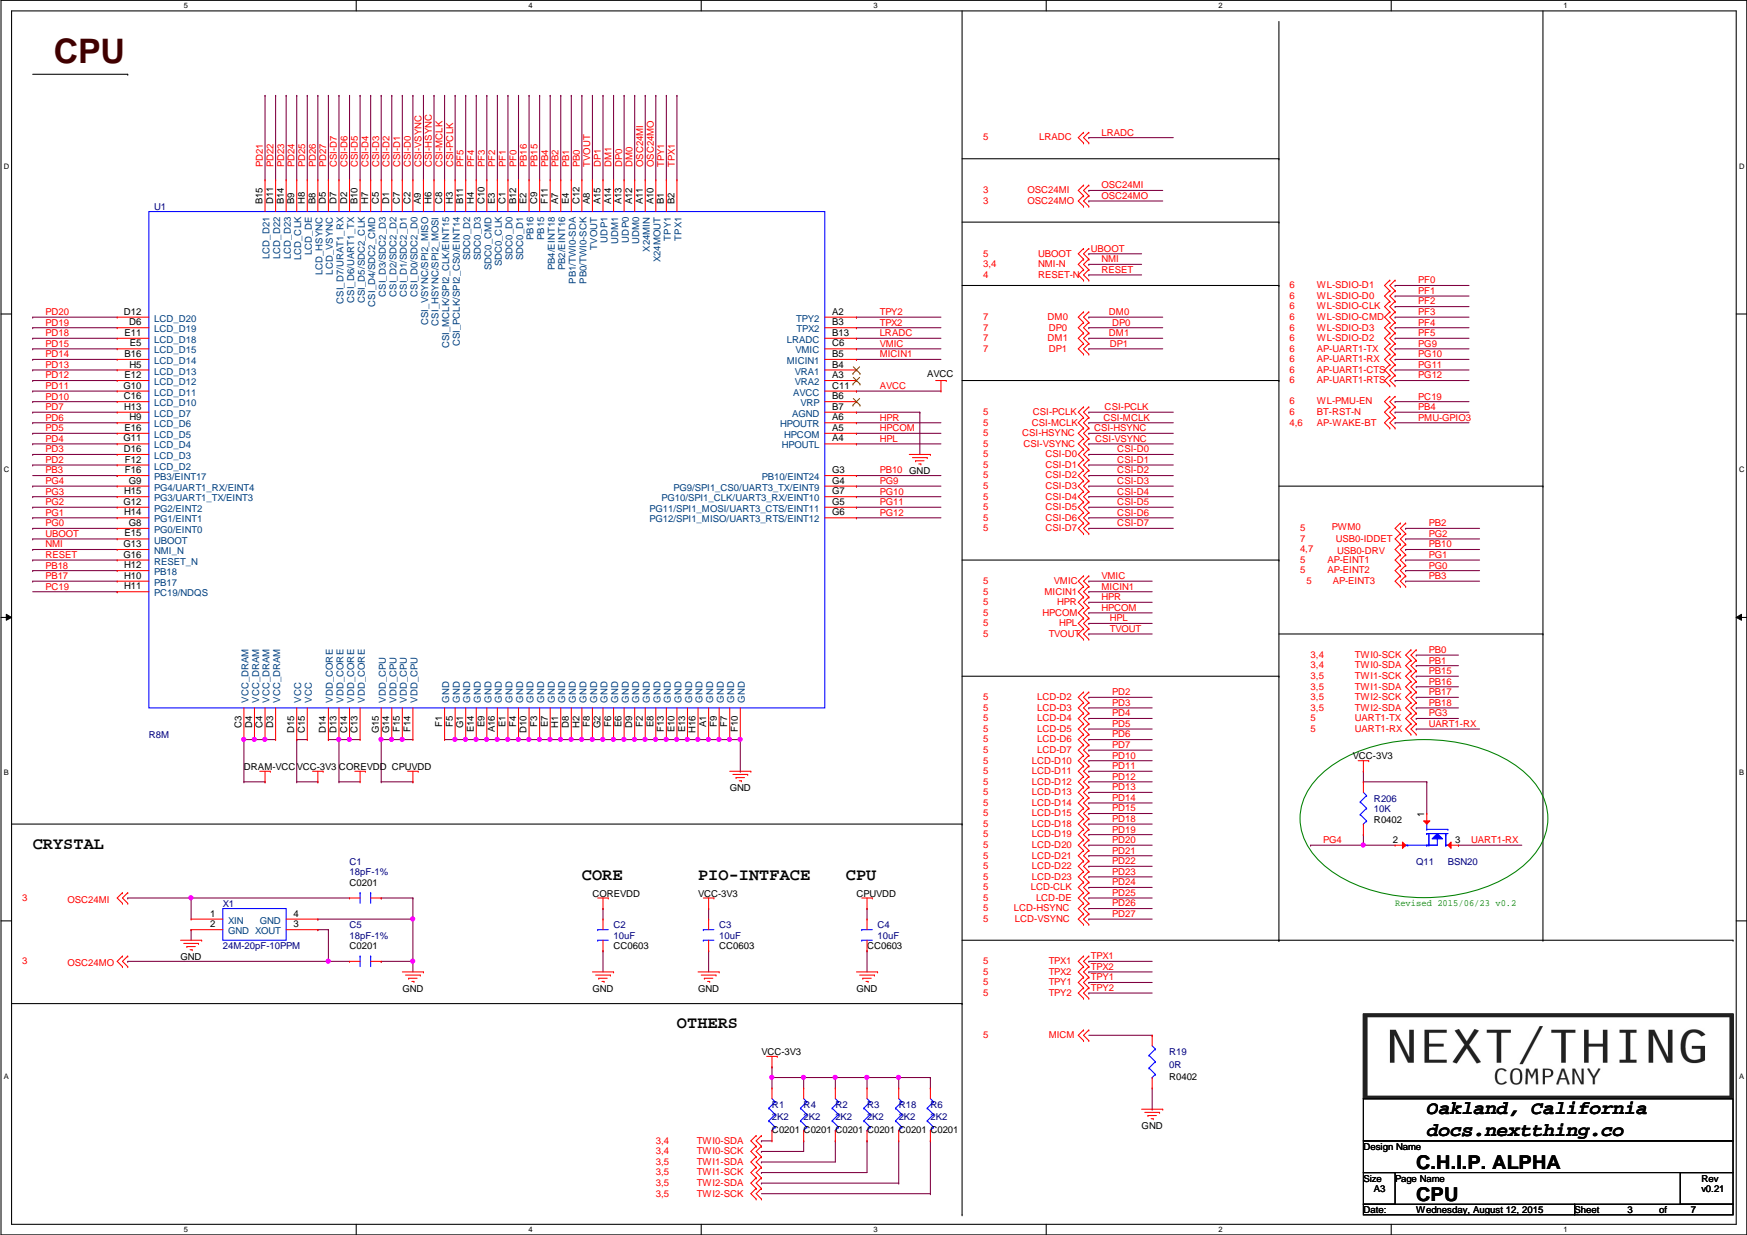
[picture p29: page 3]

DRAM-VCCVCC-3V3 COREVDD CPUVDD

# POWER/PMU

# IPSOUT TO 5V FOR SYS

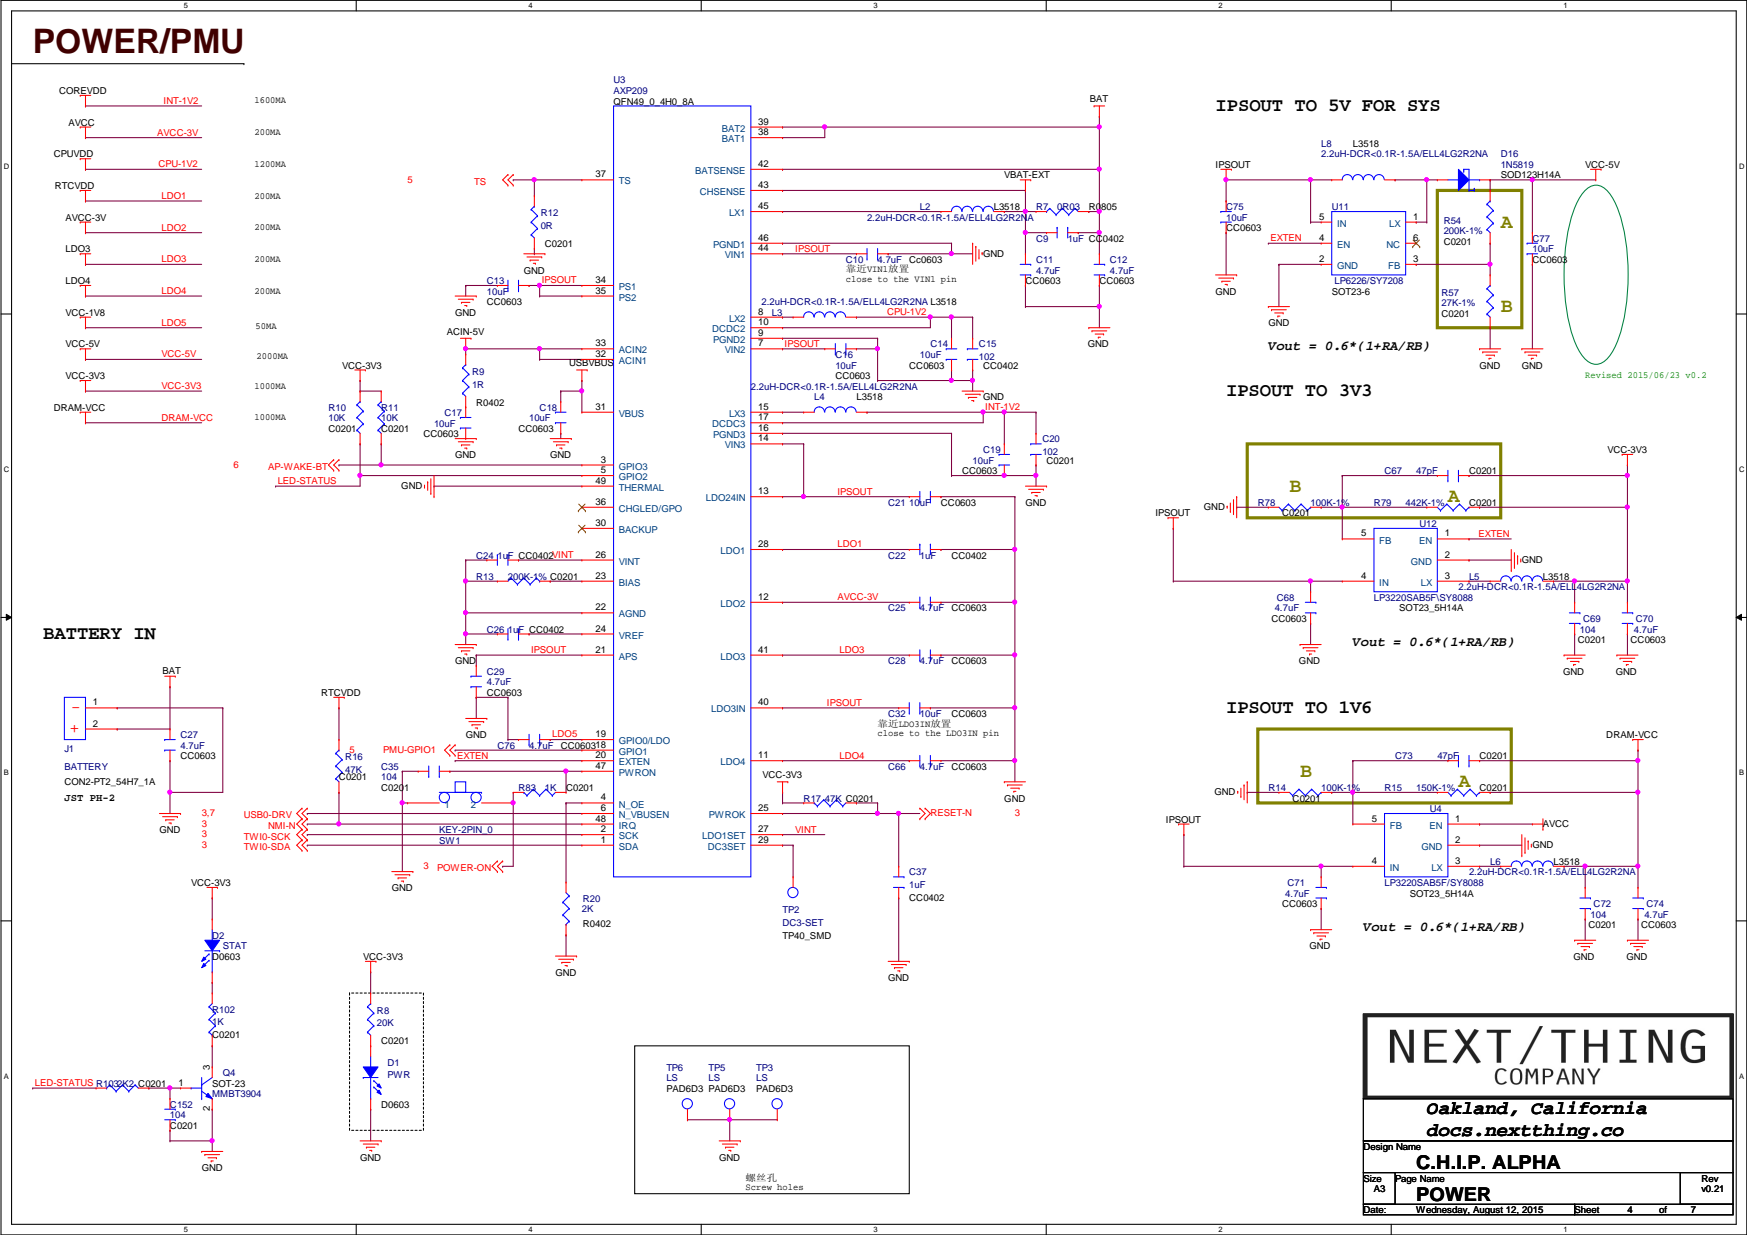
[picture p30: page 4]

靠靠VIN1放放
close to the VIN1 pin

靠靠LDO3IN放放
close to the LDO3IN pin

# MISC

### Note:

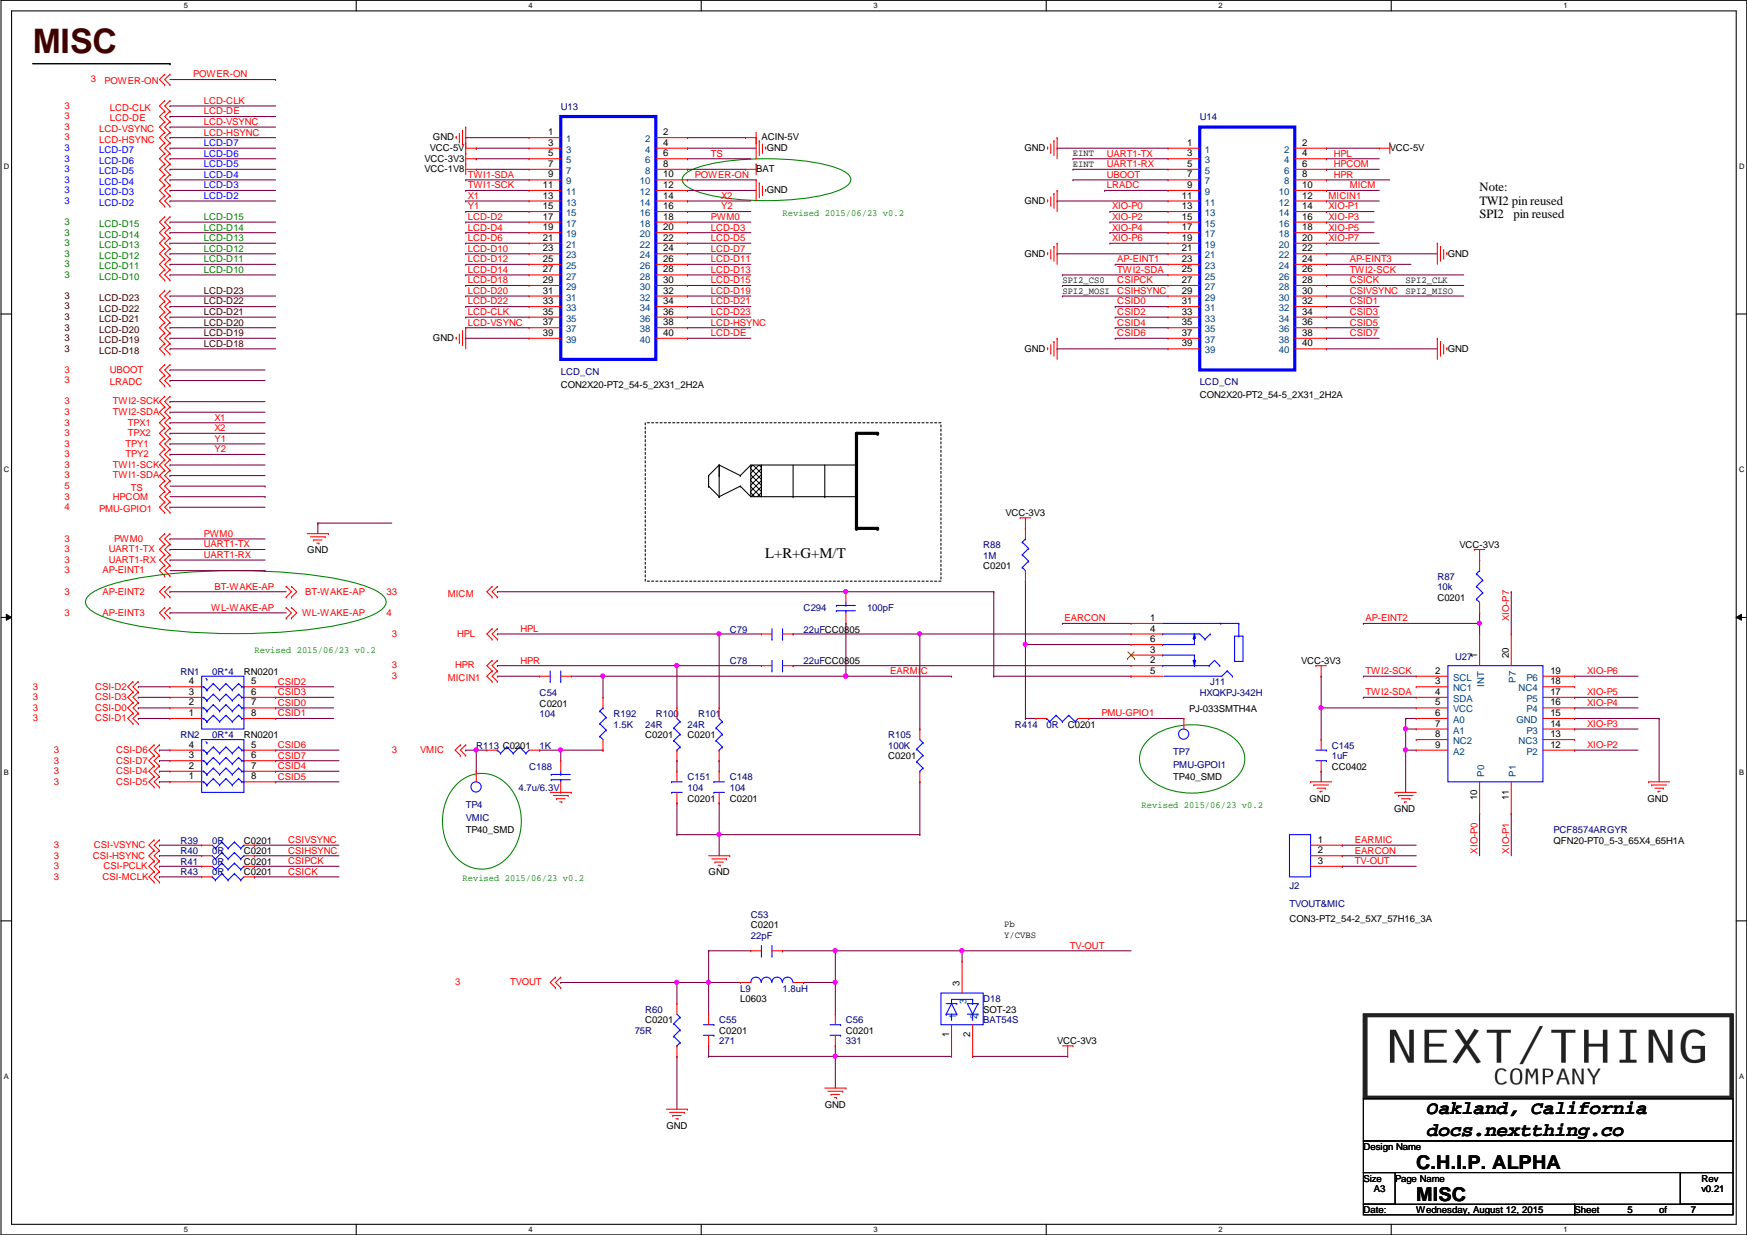
[picture p31: page 5]

XIO-P7 WL-WAKE-AP

A | B | C | D | E
4 | 4

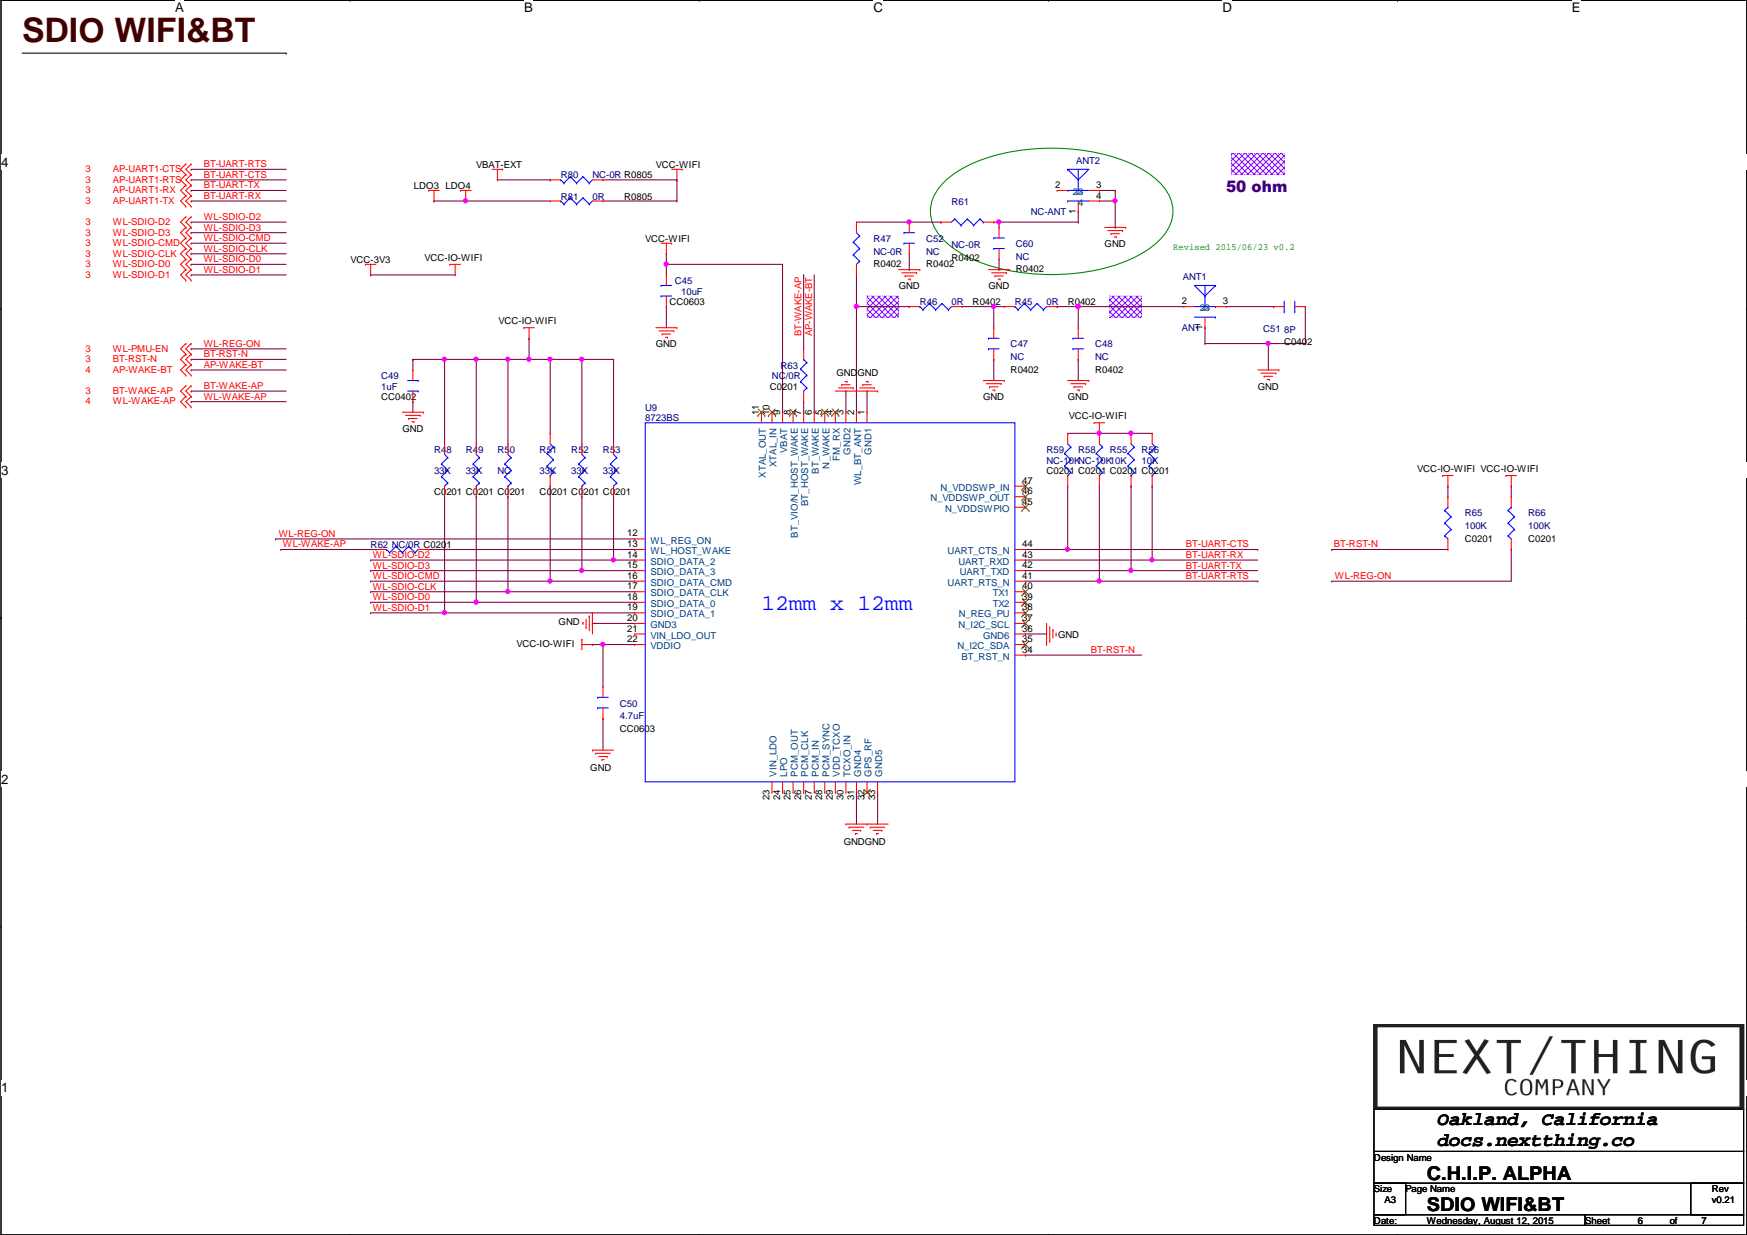
[picture p32: page 6]

VCC-IO-WIFI

# USB

# USB

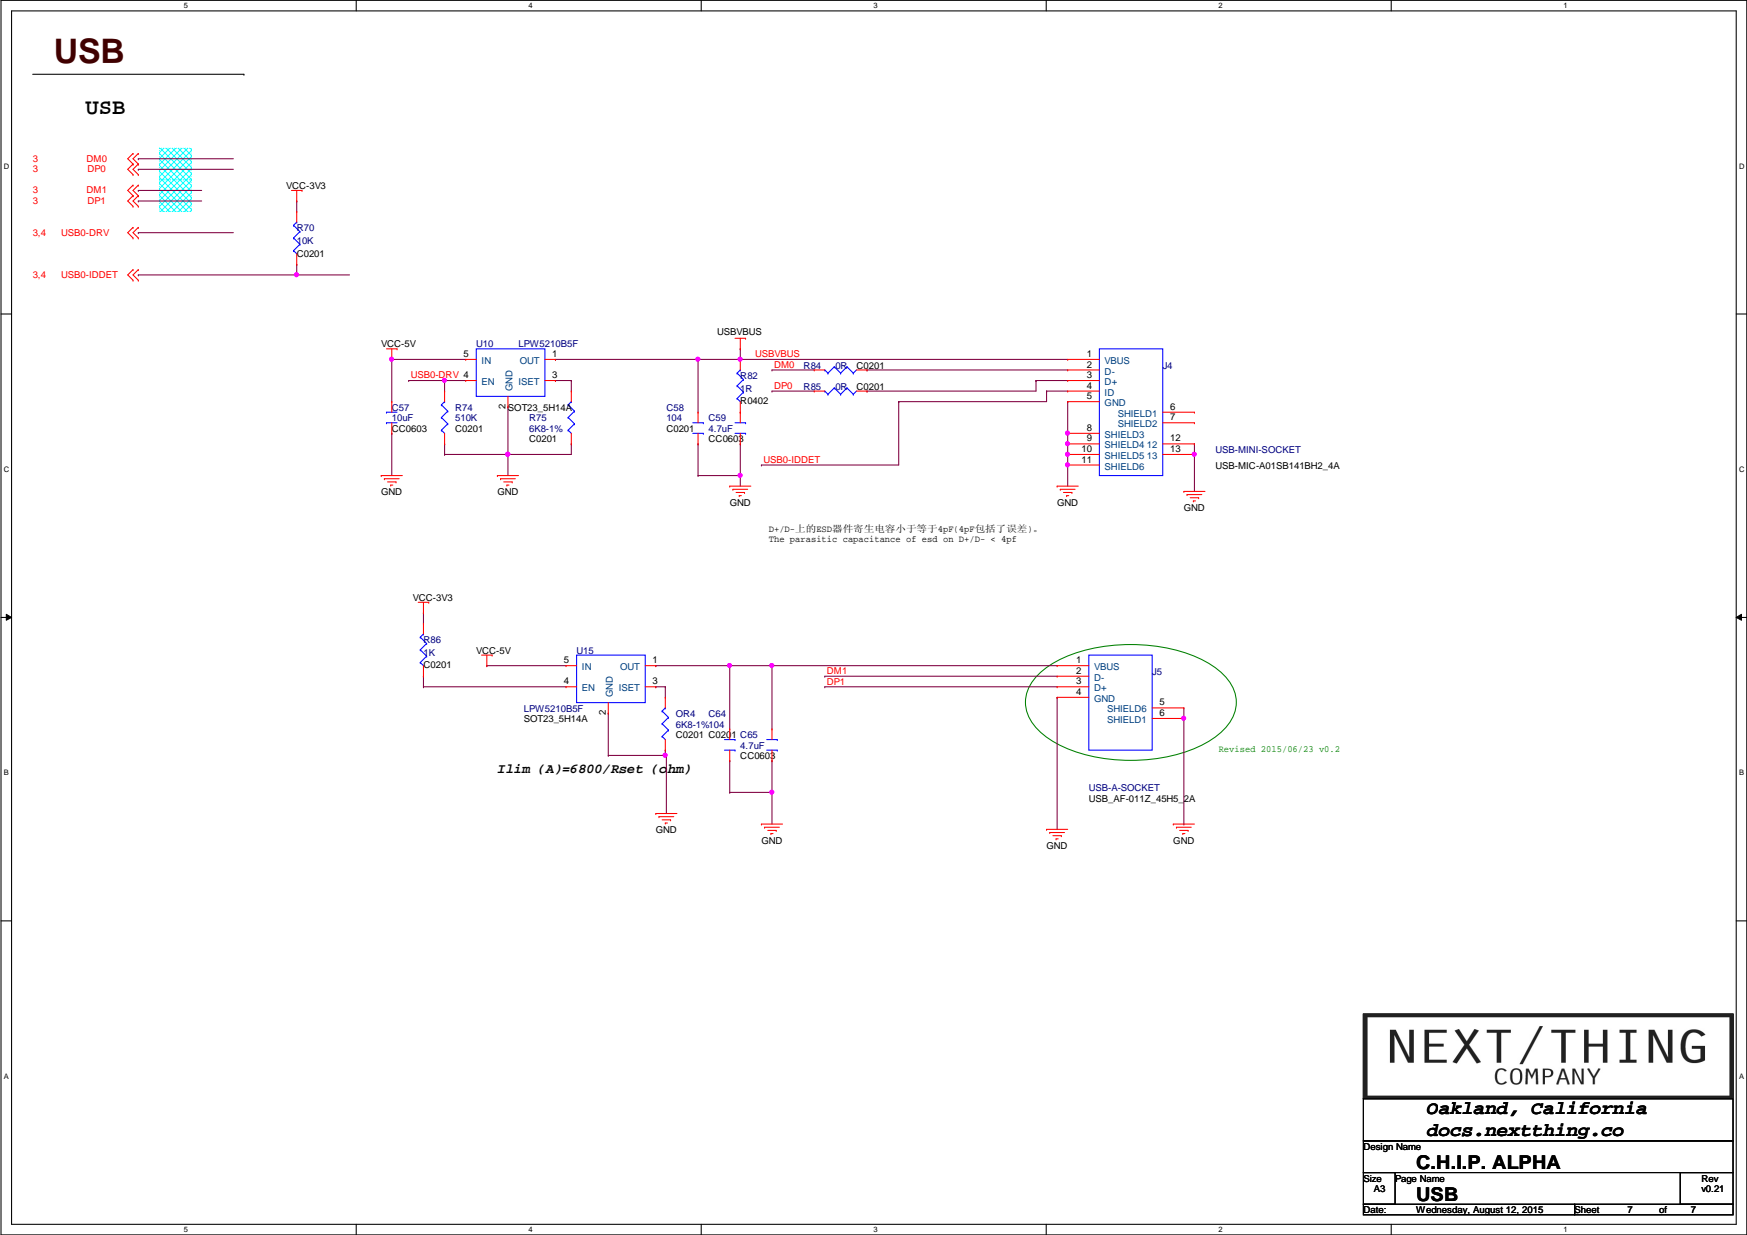
[picture p33: page 7]

D+/D-上上ESD器器器器器器器器器器4pF(4pF包包包包包)。
The parasitic capacitance of esd on D+/D- < 4pf
