joelguittet/chip-hardware/ALPHA-CHIP[v0_21]/CHIP_ALPHA_V_021_stackup.pdf

# ART FILM - past_bot

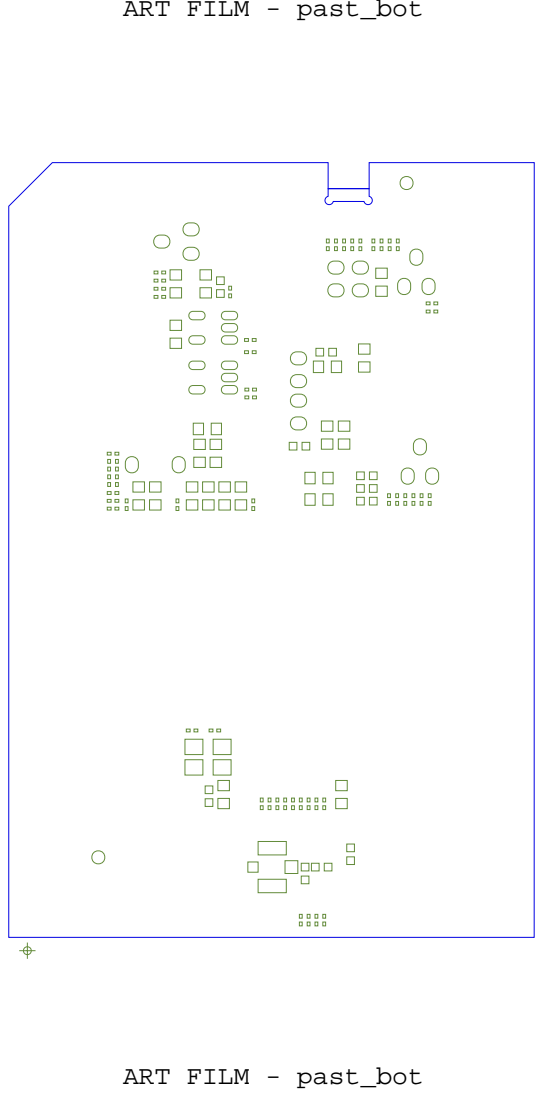
[picture p34: page 1]
ART FILM - past_bot

# ART FILM - mask_bot

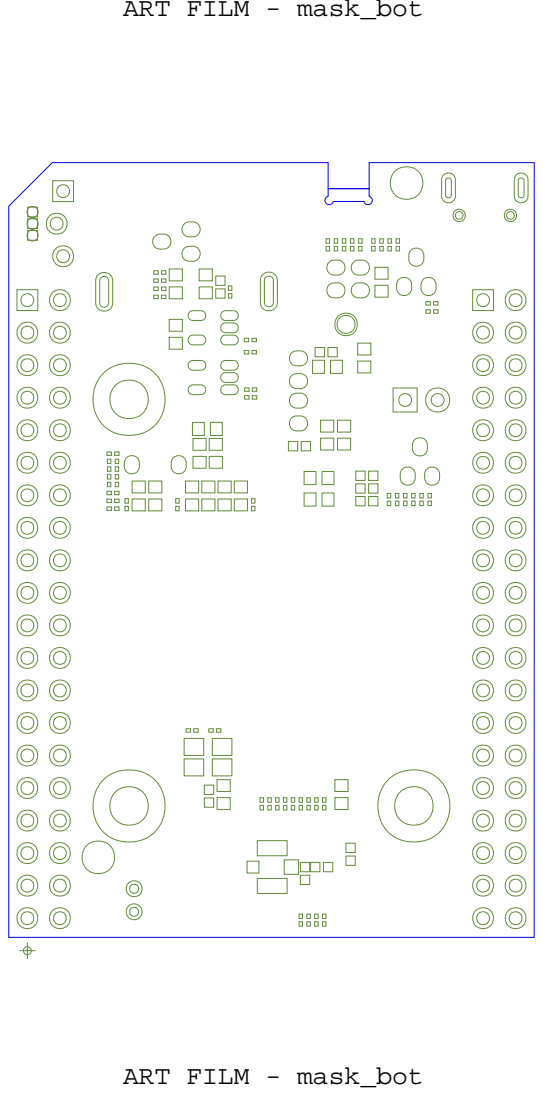
[picture p35: page 2]
ART FILM - mask_bot

# ART FILM - drill

# ALL UNITS ARE IN MILS

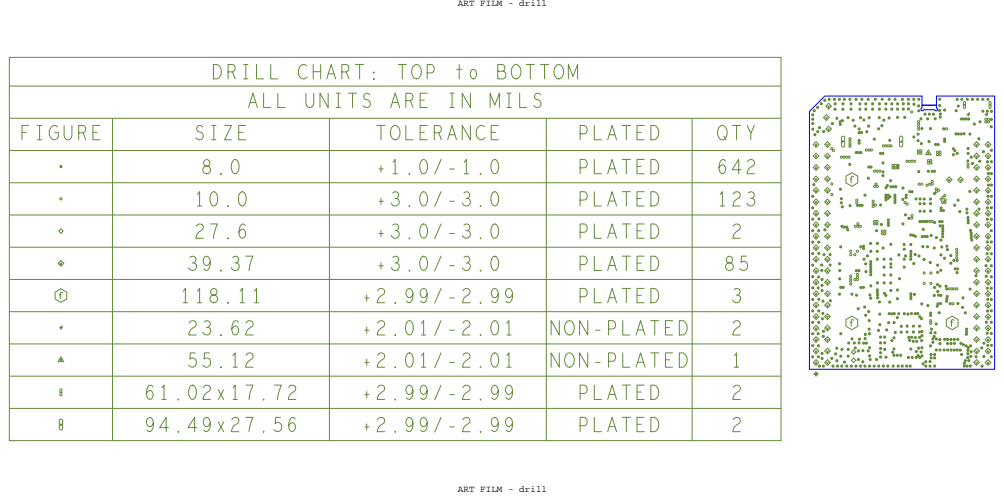
[picture p36: page 3]
QTY 642 123; PLATED PLATED PLATED PLATED PLATED PLATED; PLATED PLATED; NON-PLATED NON-PLATED; TOLERANCE +1.0/-1.0 +3.0/-3.0 +3.0/-3.0 +3.0/-3.0 +2.99/-2.99 +2.01/-2.01 +2.01/-2.01 +2.99/-2.99 +2.99/-2.99; SIZE; FIGURE

DRILL CHART: TOP to BOTTOM

ART FILM - drill

# ART FILM - gnd

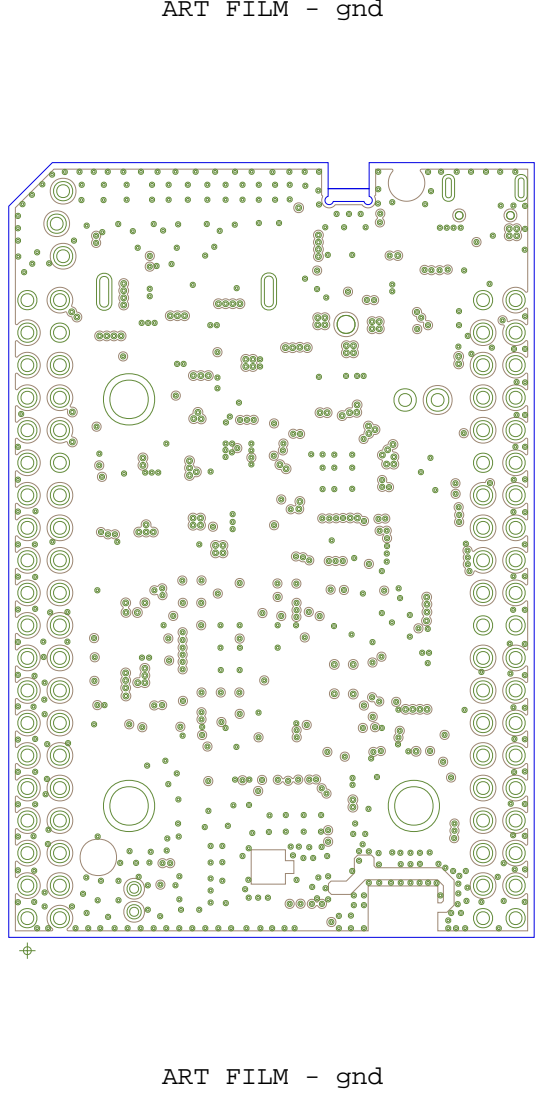
[picture p37: page 4]

ART FILM - gnd

# ART FILM - silk_top

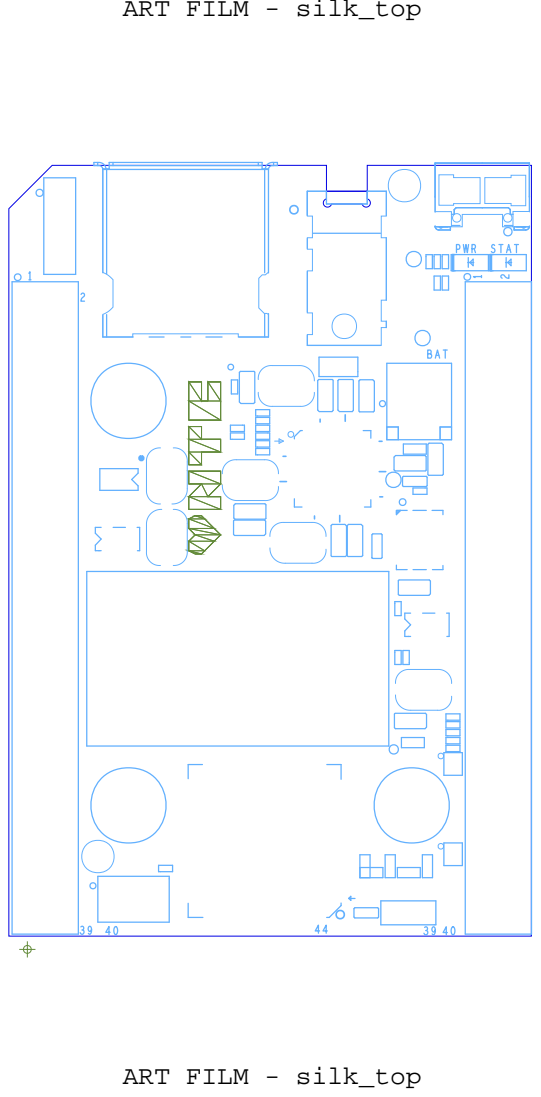
[picture p38: page 5]
ART FILM - silk_top; PWR STAT; BAT

# ART FILM - bottom

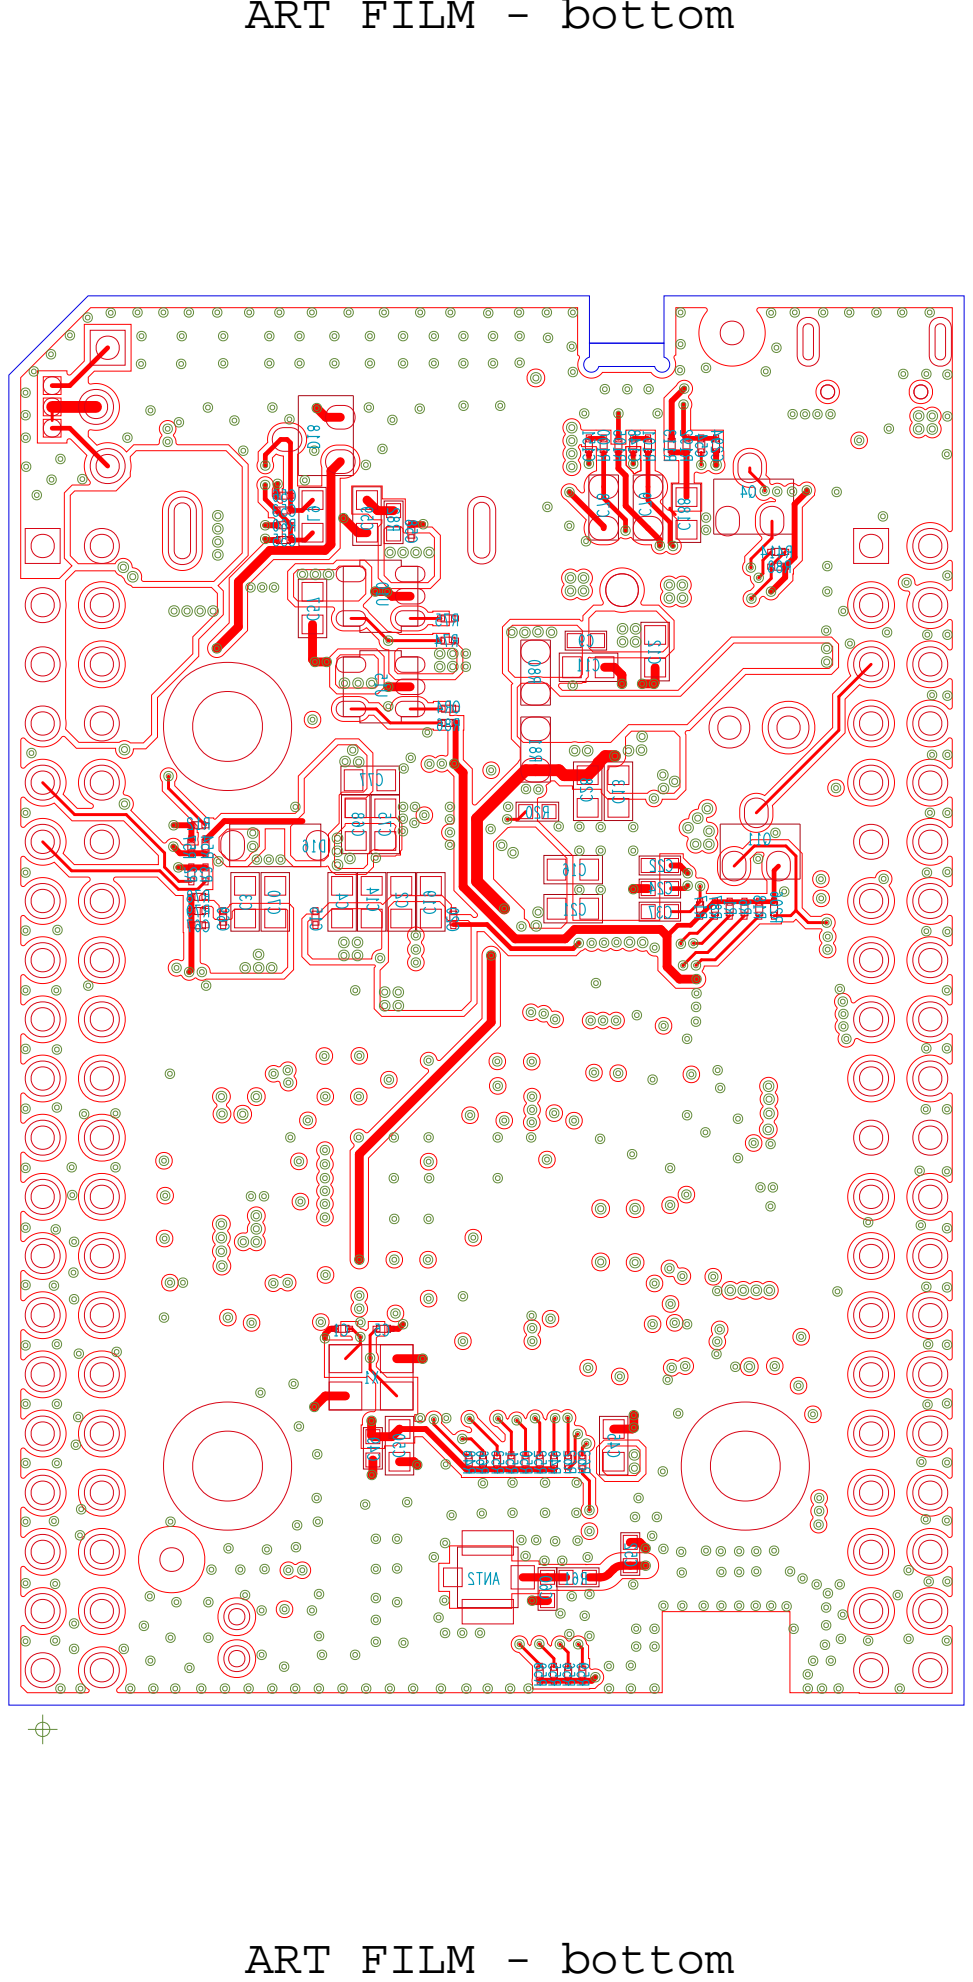
[picture p39: page 6]

# ART FILM - mask_top

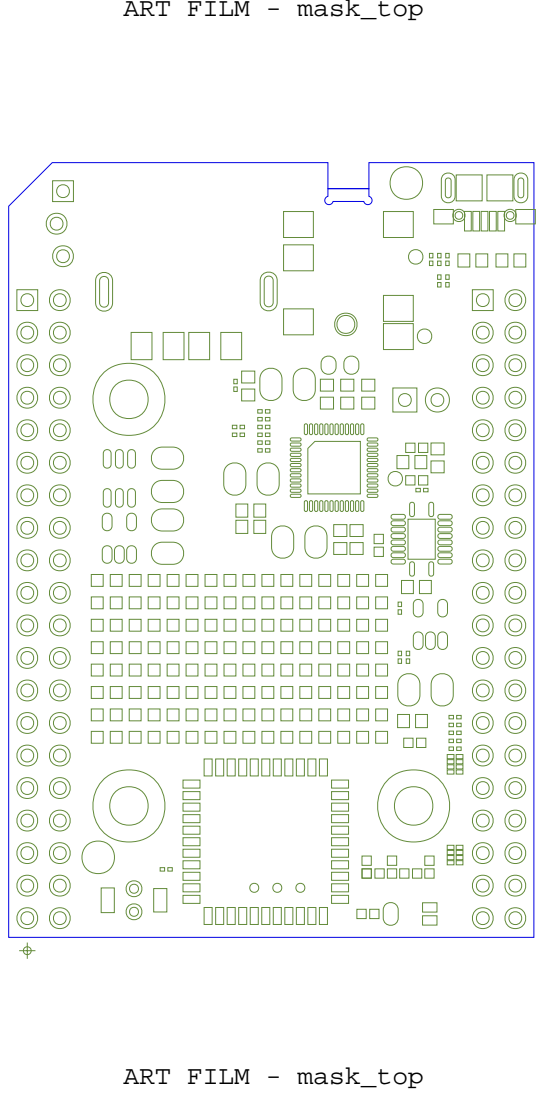
[picture p40: page 7]
ART FILM - mask_top

# ART FILM - past_top

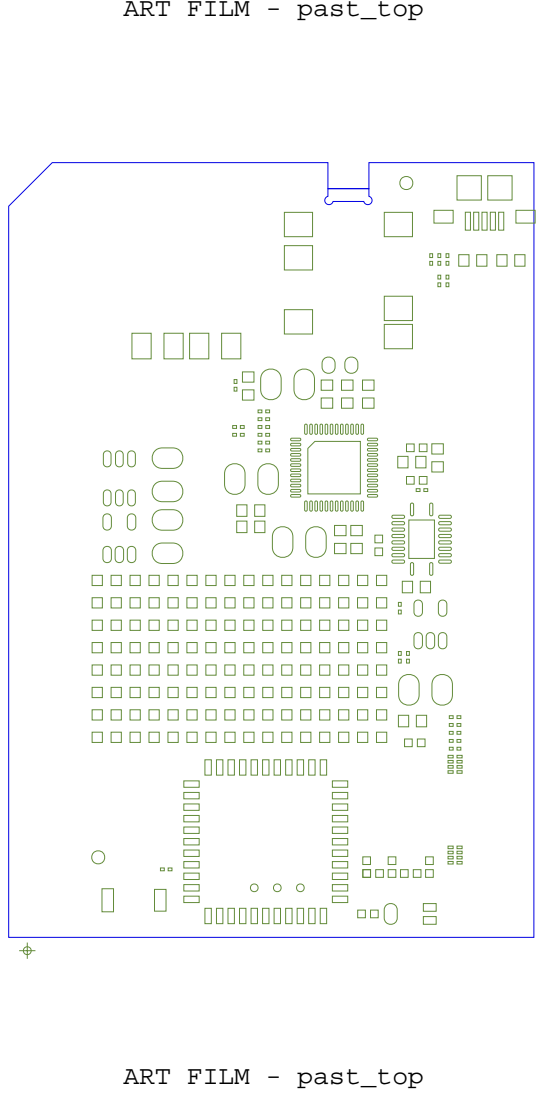
[picture p41: page 8]
ART FILM - past_top

# ART FILM - silk_bot

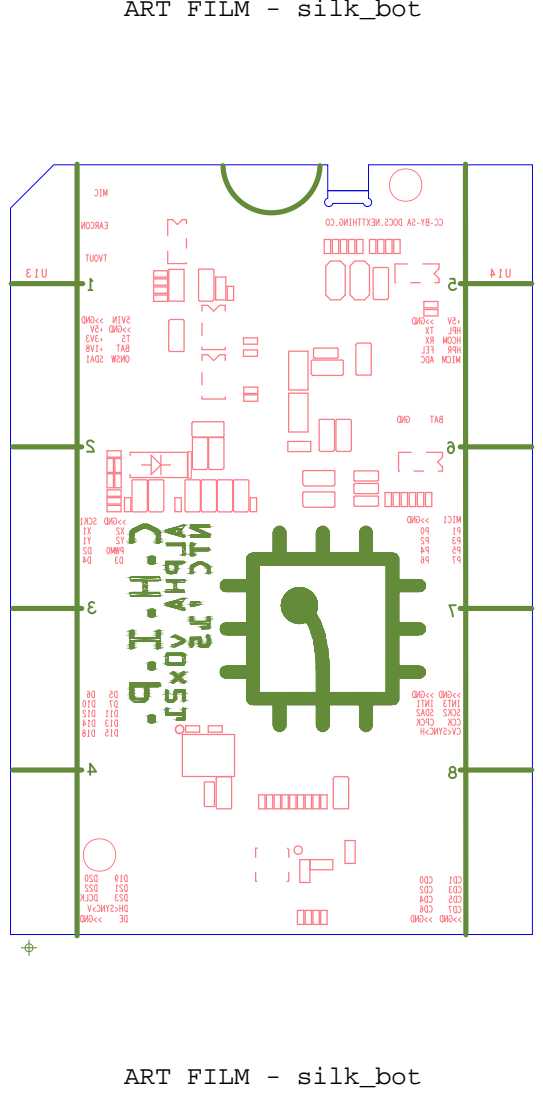
[picture p42: page 9]

CC-BY-SA DOCS.NEXTTHING.CO

# ART FILM - top

# D1 D2 U14

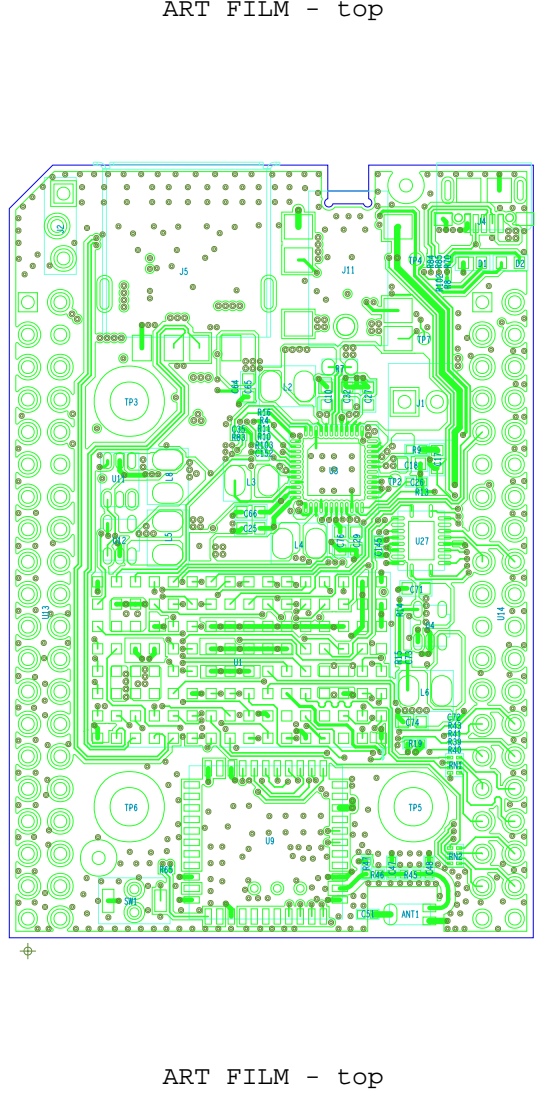
[picture p43: page 10]

# ART FILM - vcc

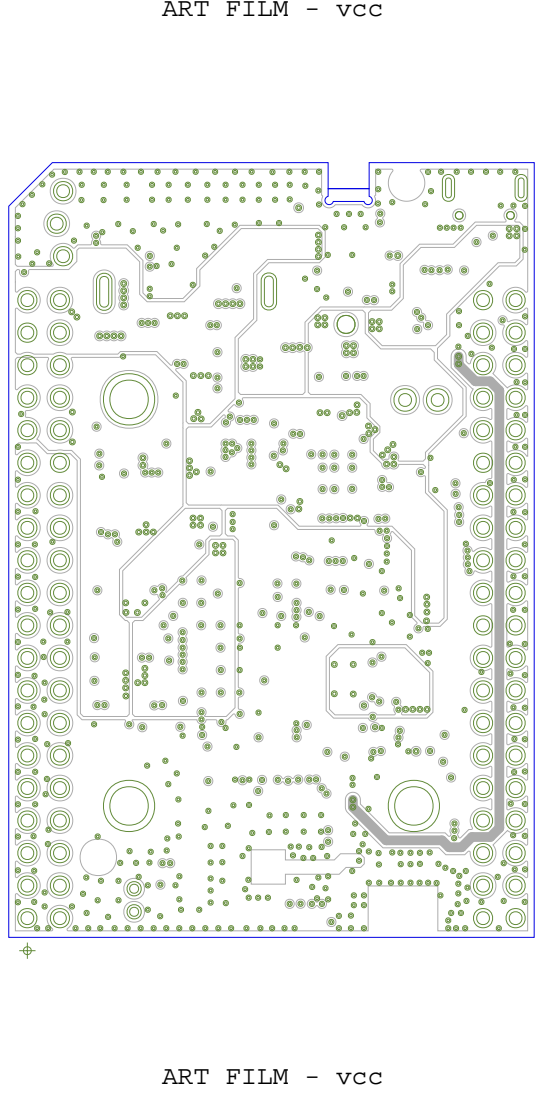
[picture p44: page 11]

ART FILM - vcc

# ART FILM - in1

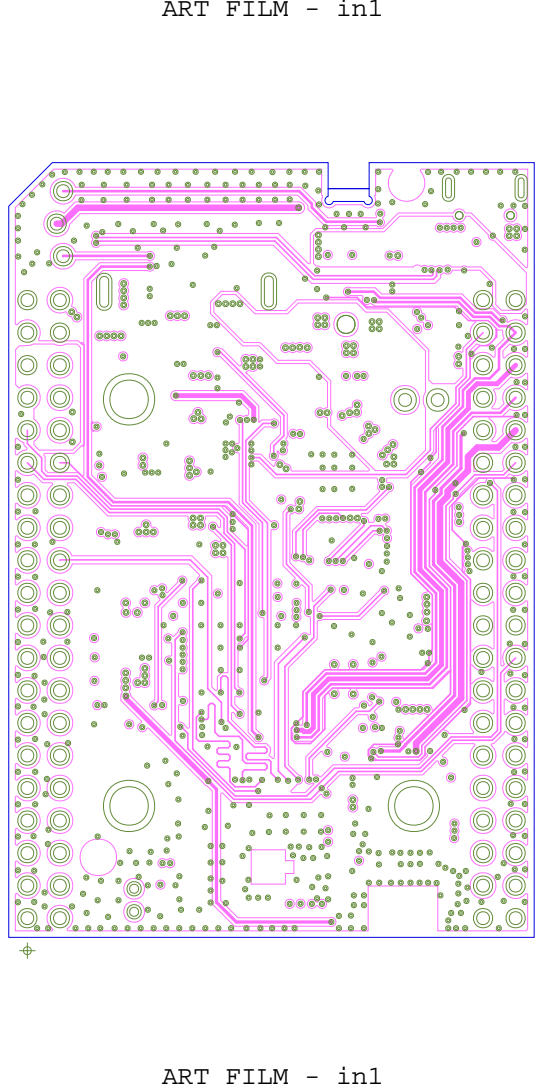
[picture p45: page 12]
ART FILM - in1

# ART FILM - in2

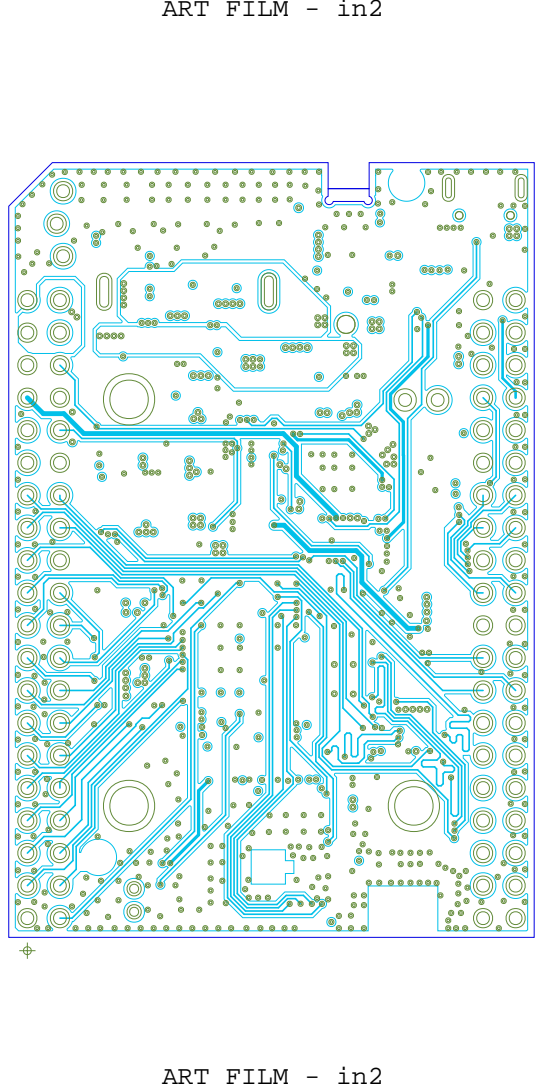
[picture p46: page 13]
ART FILM - in2
