joelguittet/chip-hardware/CHIP[v1_0]/CHIP_v1_0_STACKUP_20151222.pdf

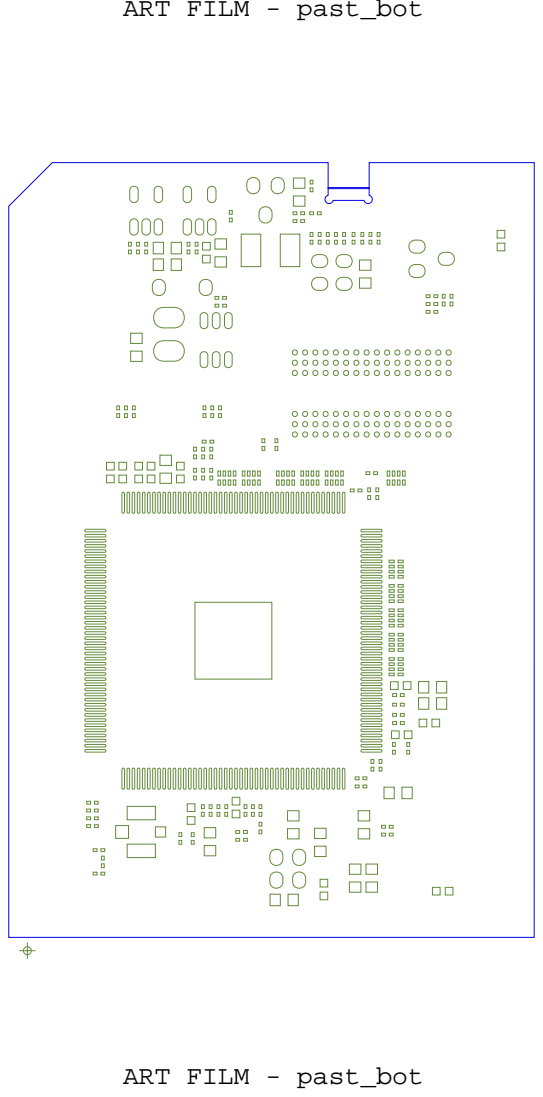
[picture p47: page 1]
ART FILM - past_bot

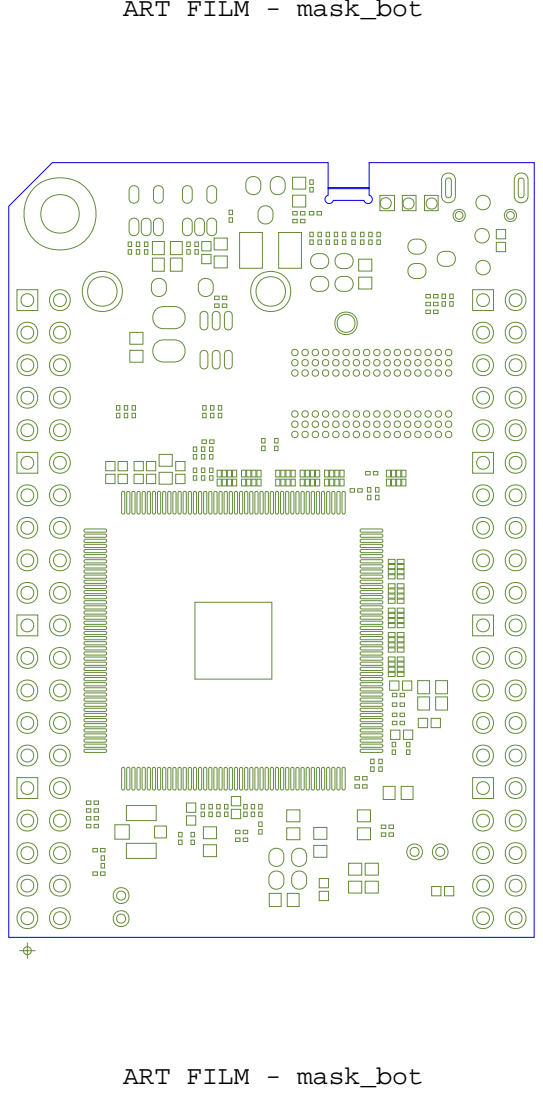
[picture p48: page 2]
ART FILM - mask_bot

## ALL UNITS ARE IN MILS

## DRILL CHART: TOP to BOTTOM

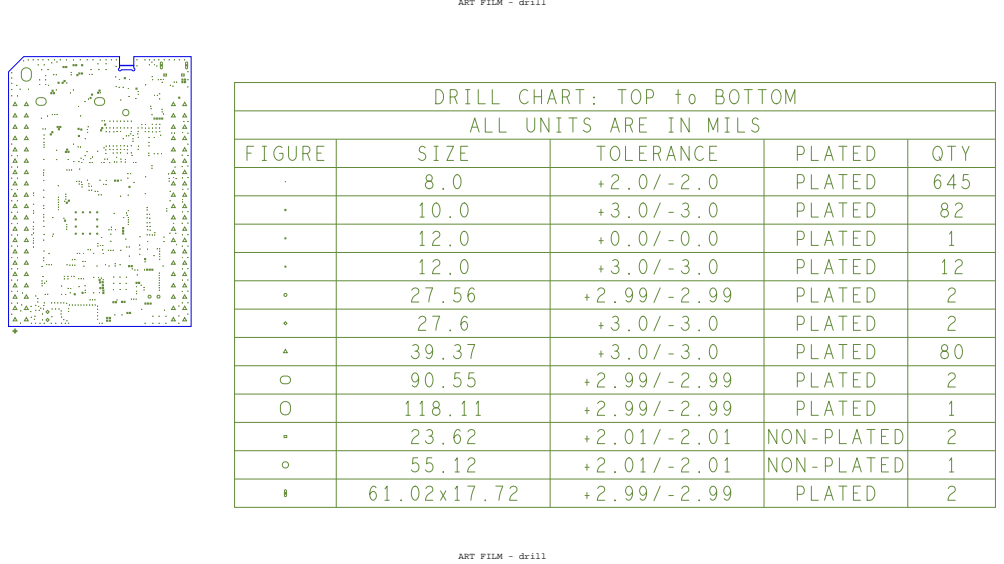
[picture p49: page 3]
QTY 645 82 1 12 2 2 80 2 1 2 1 2; PLATED PLATED PLATED PLATED PLATED PLATED PLATED PLATED PLATED PLATED; PLATED; NON-PLATED NON-PLATED; TOLERANCE +2.0/-2.0 +3.0/-3.0 +0.0/-0.0 +3.0/-3.0; SIZE; FIGURE

ART FILM - drill

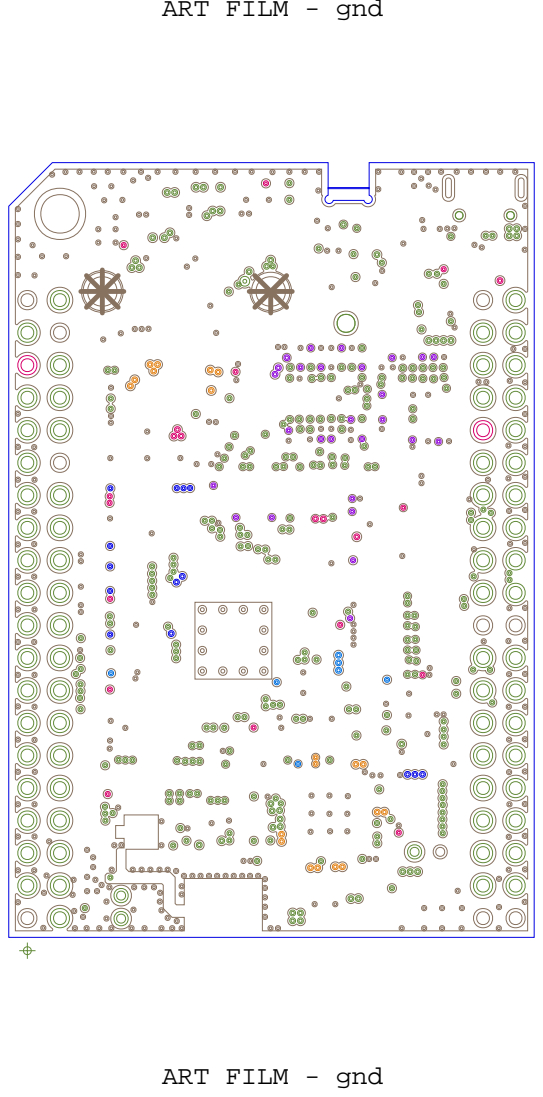
[picture p50: page 4]

ART FILM - gnd

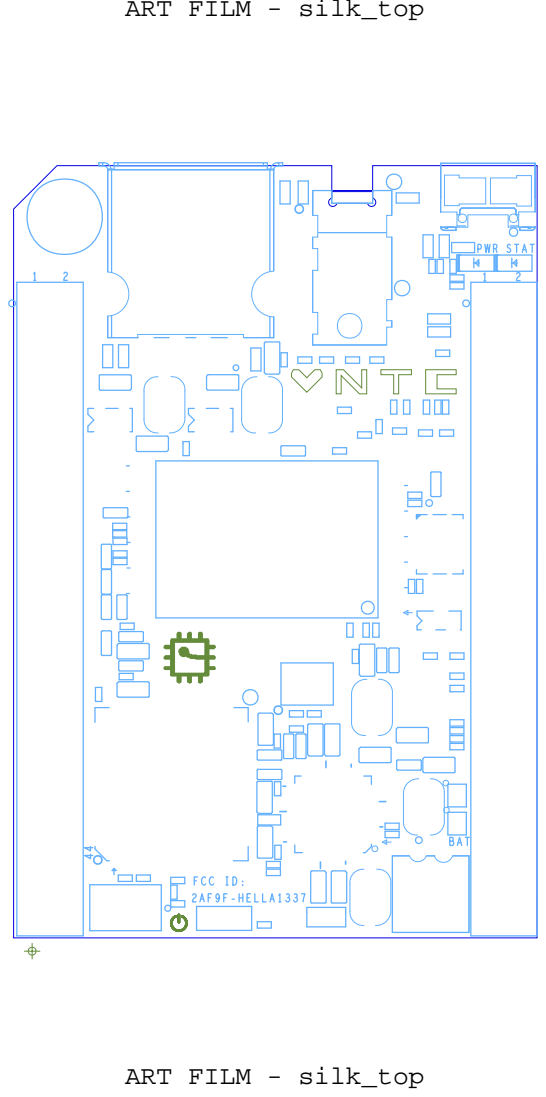
[picture p51: page 5]
ART FILM - silk_top; STAT; PWR; BAT; FCC ID: 2AF9F-HELLA1337

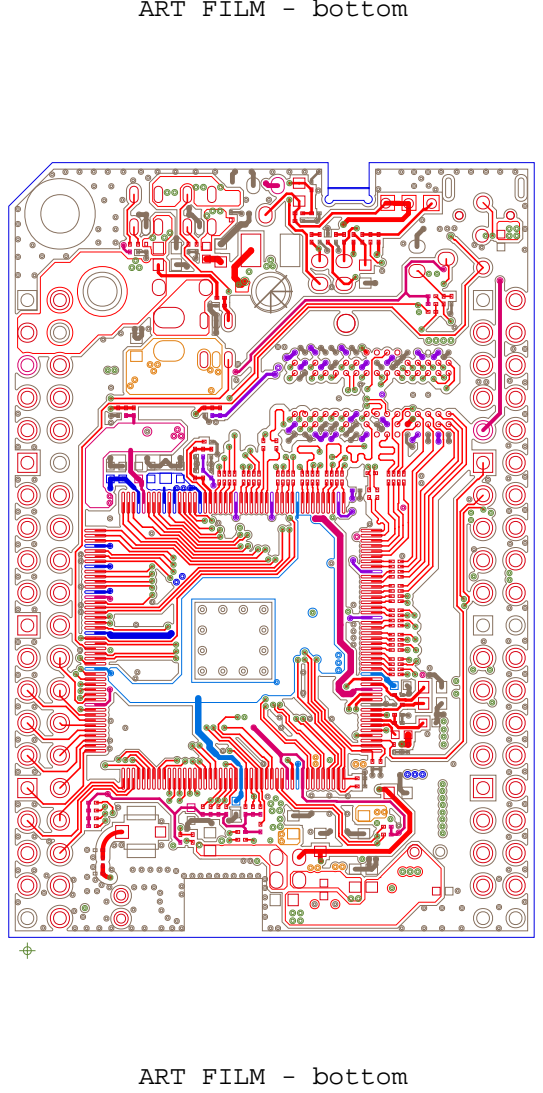
[picture p52: page 6]

ART FILM - bottom

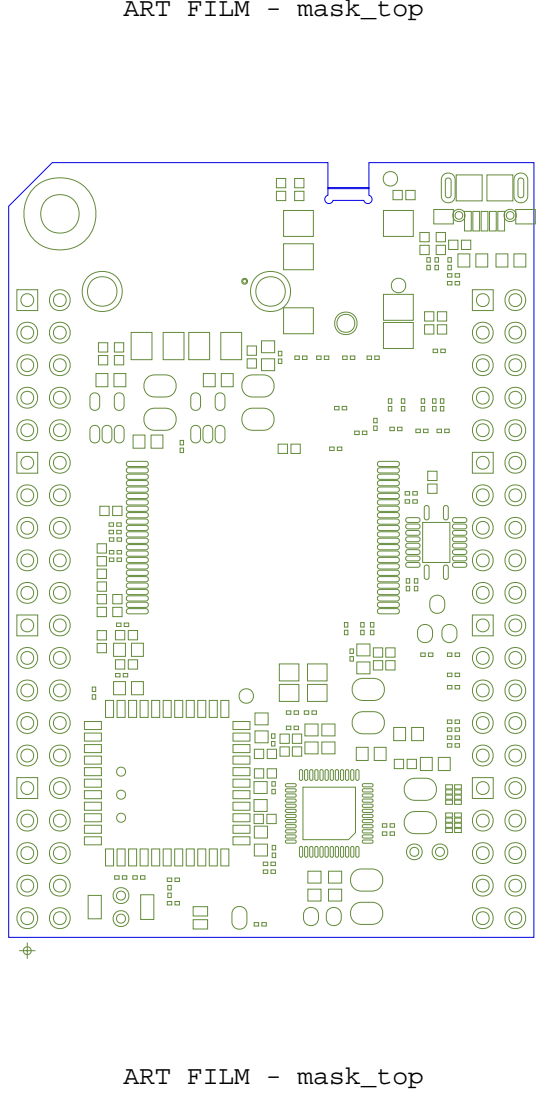
[picture p53: page 7]
ART FILM - mask_top

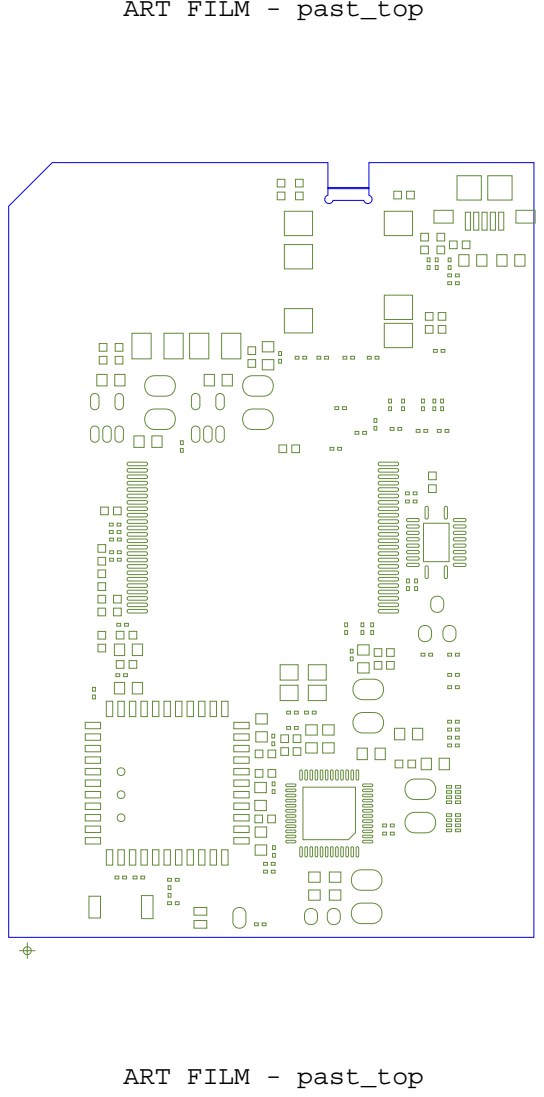
[picture p54: page 8]
ART FILM - past_top

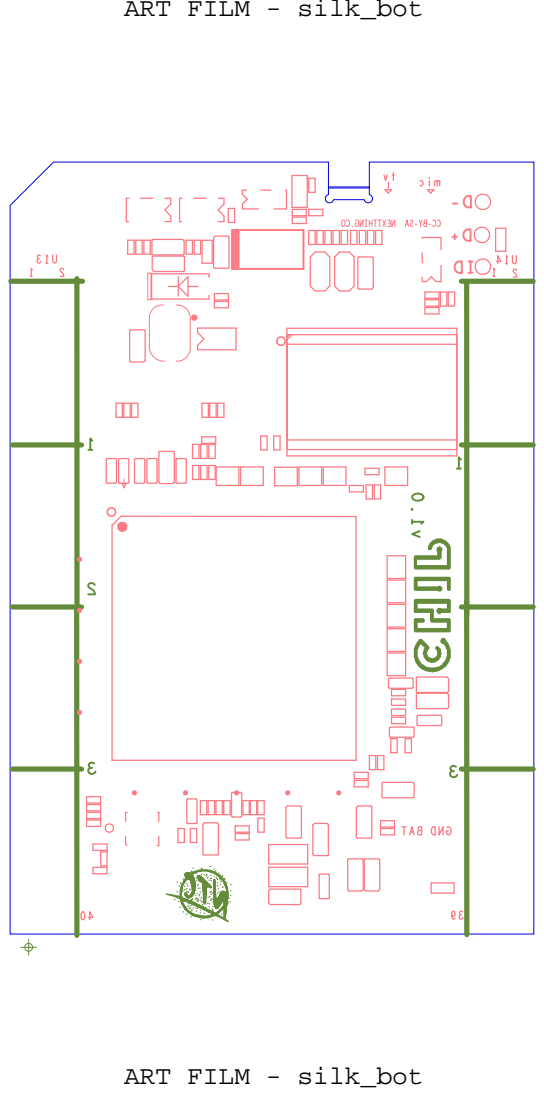
[picture p55: page 9]
ART FILM - silk_bot

mic tv v1.0 BAT GND

CC-BY-SA NEXTTHING.CO

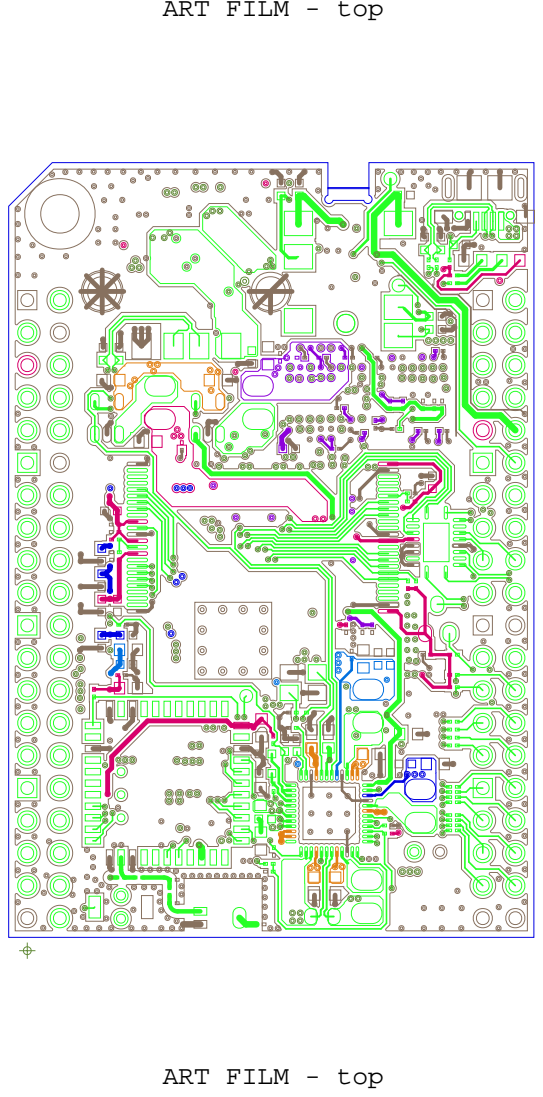
[picture p56: page 10]

ART FILM - top

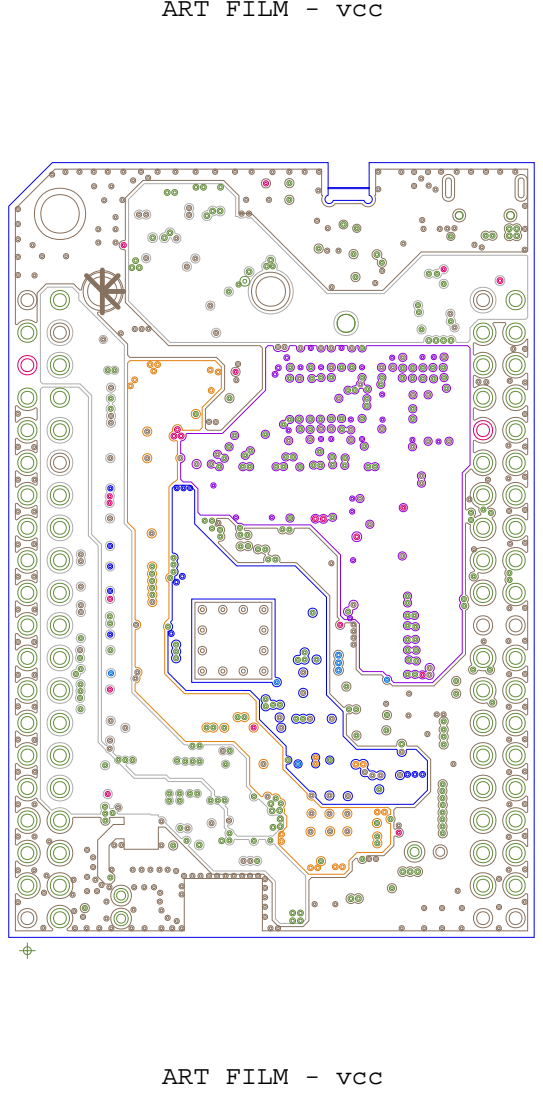
[picture p57: page 11]

ART FILM - vcc

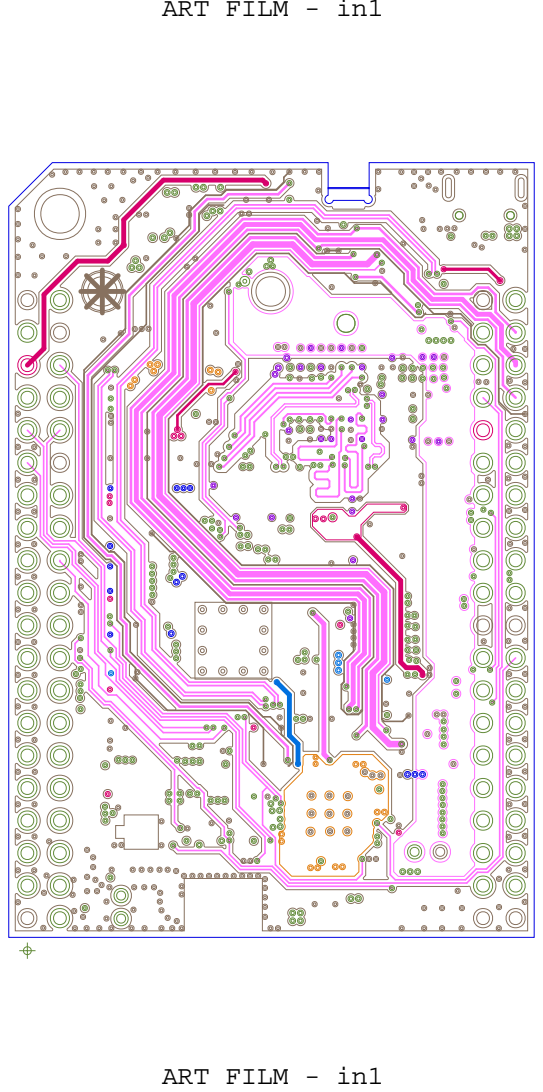
[picture p58: page 12]
ART FILM - in1

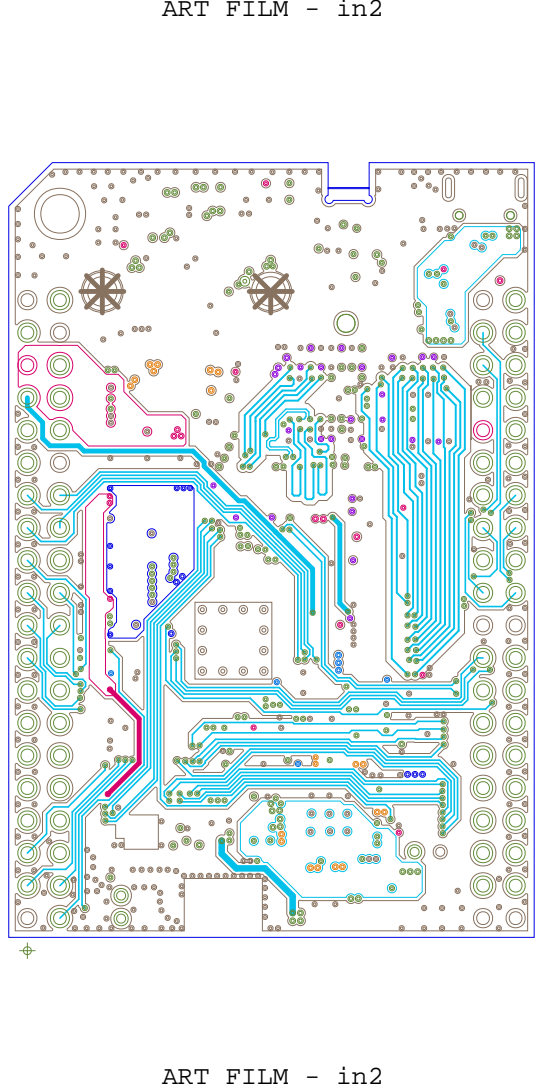
[picture p59: page 13]
ART FILM - in2
