joelguittet/chip-hardware/CHIP[v1_0]/CHIP_v1_0_ASSEMBLY_20151222.pdf

# ART FILM - silk_top

# STAT U14

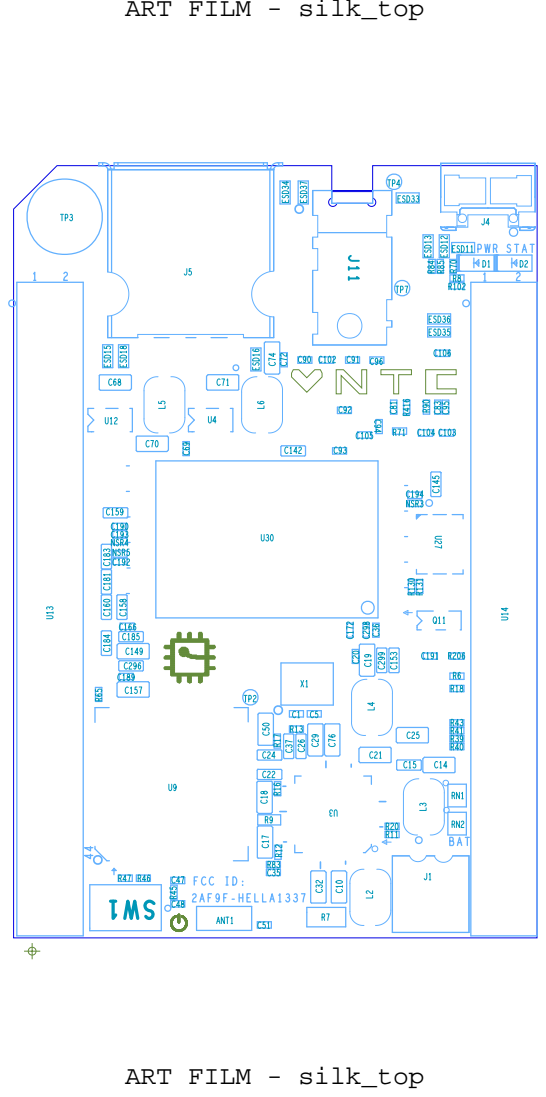
[picture p60: page 1]

# ART FILM - silk_bot

D+

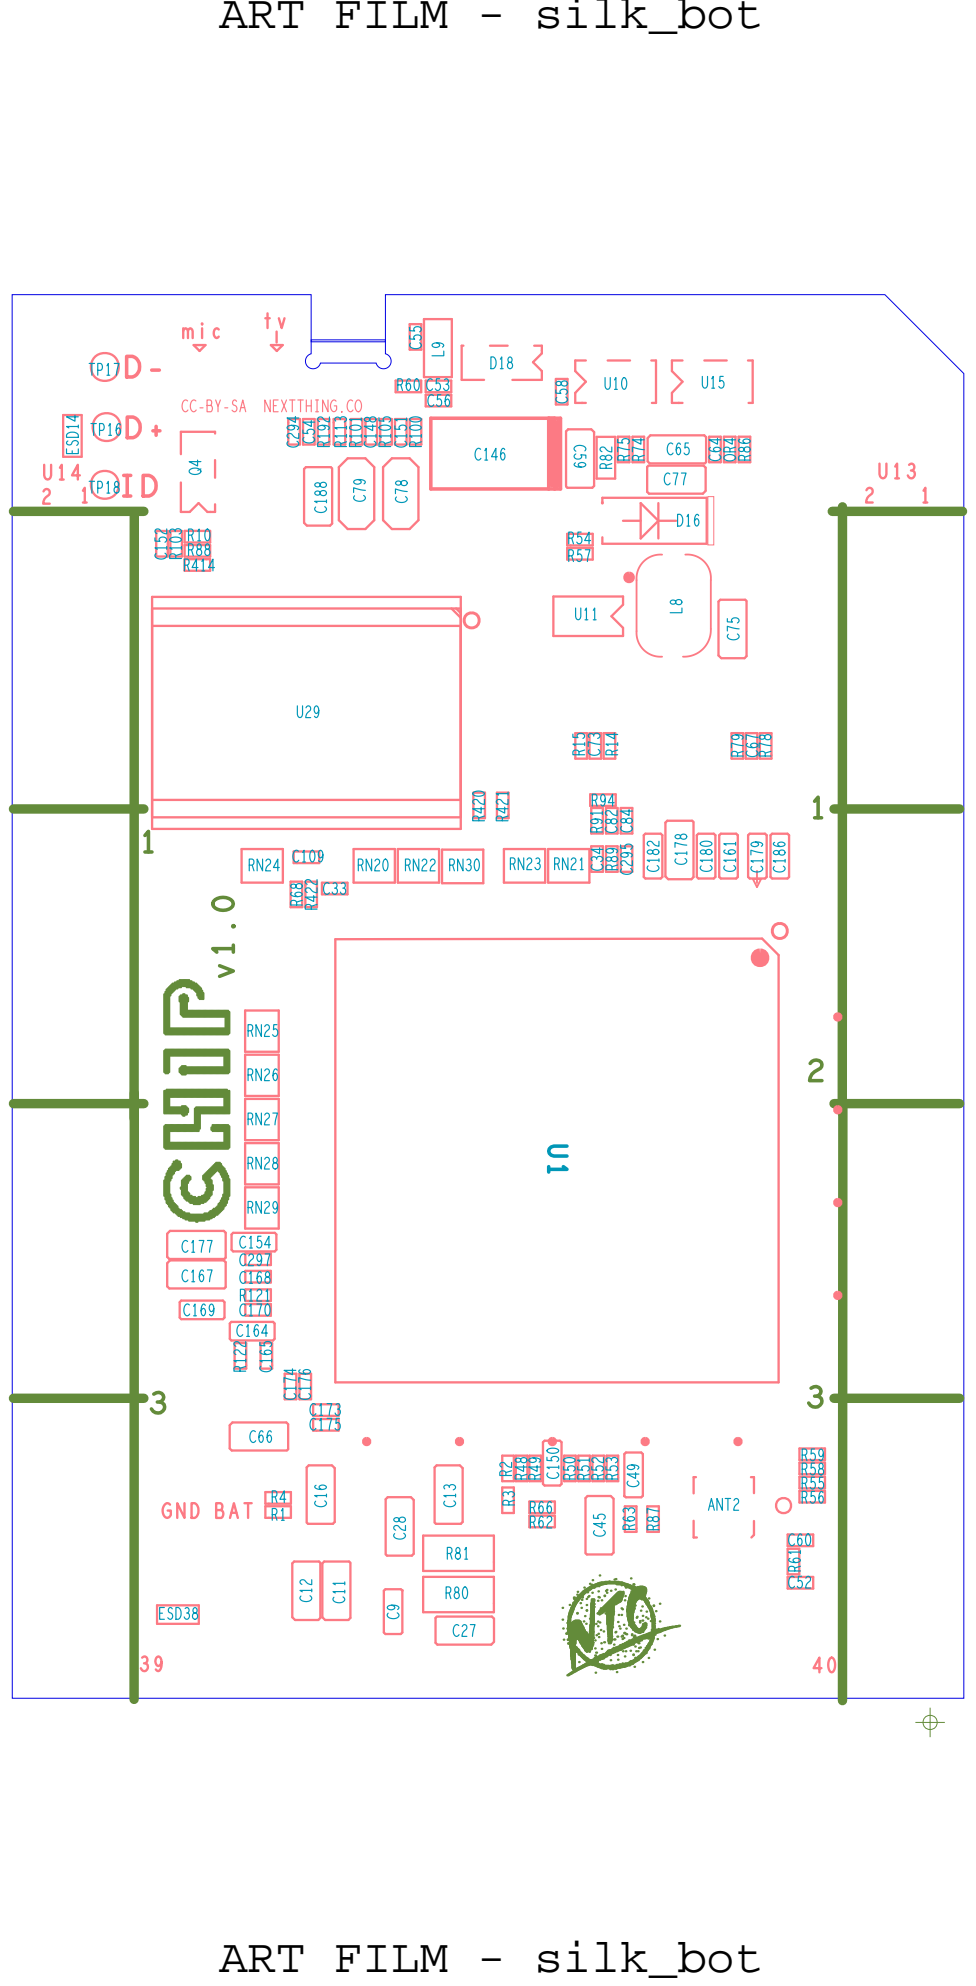
[picture p61: page 2]
