joelguittet/chip-hardware/(list of files, drawings)

Other design files:
ALPHA-CHIP[v0_21]/CHIP_ALPHA_V_021.DSN
CHIP[v1_0]/CHIP_v1_0.dsn
